parkourlrc/pcb-tgiacomellibr--sjc-6abed6a295/firmware/sjc_fw.pdf

24/08/2025

sjc_fw Project
Configuration Report

## 1. Description

### 1.1. Project

Project Name | sjc_fw
Board Name | custom
Generated with: | STM32CubeMX 6.15.0
Date | 08/24/2025

### 1.2. MCU

MCU Series | STM32F4
MCU Line | STM32F446
MCU name | STM32F446RETx
MCU Package | LQFP64
MCU Pin number | 64

### 1.3. Core(s) information

Core(s) | Arm Cortex-M4

## 2. Pinout Configuration

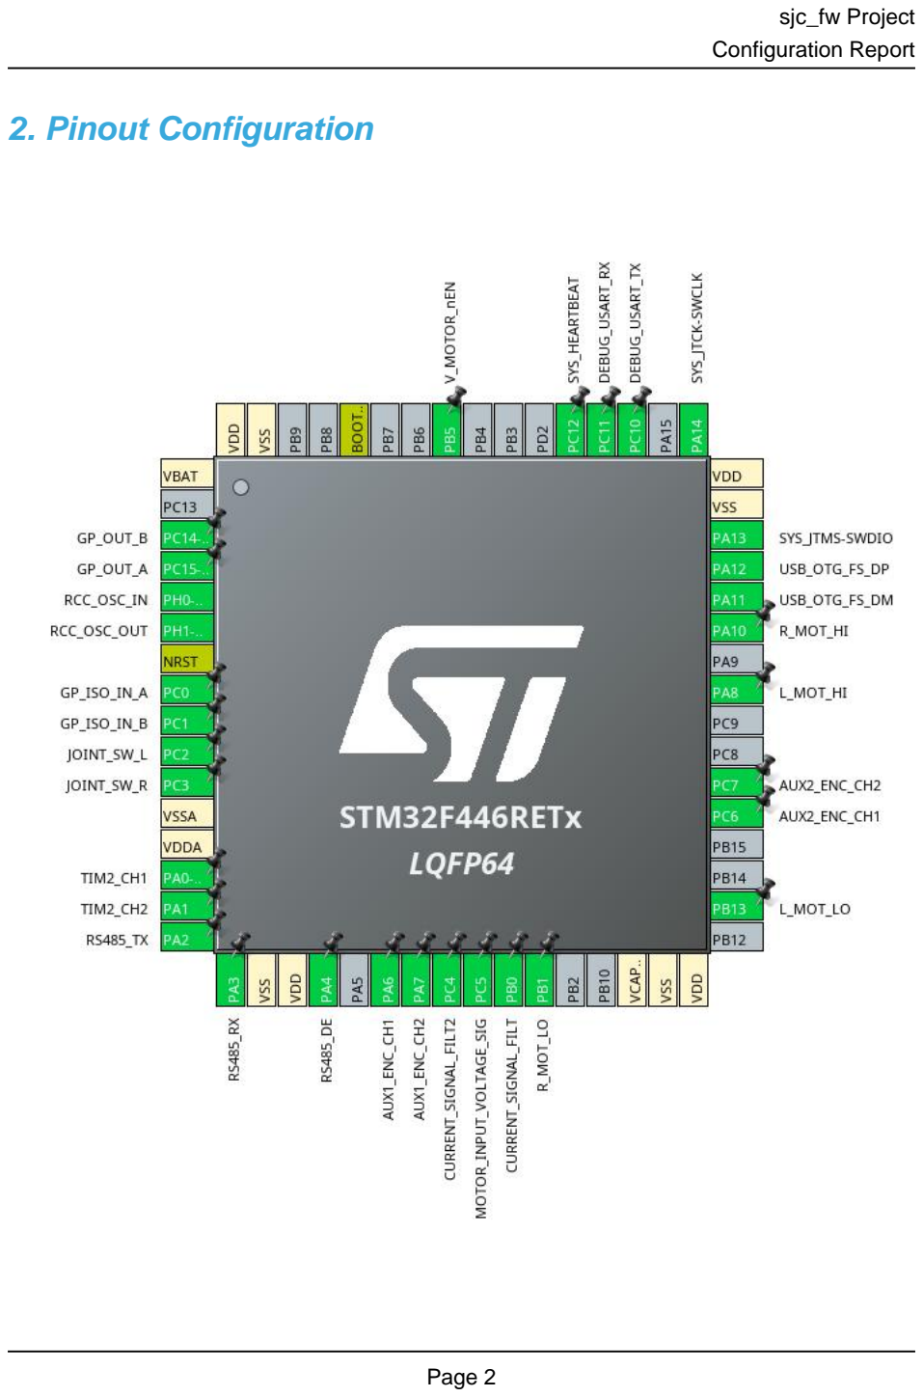
[picture p2: page 3]

## 3. Pins Configuration

Pin Number LQFP64 | Pin Name (function after reset) | Pin Type | Alternate Function(s) | Label
1 | VBAT | Power
3 | PC14-OSC32_IN * | I/O | GPIO_Output | GP_OUT_B
4 | PC15-OSC32_OUT * | I/O | GPIO_Output | GP_OUT_A
5 | PH0-OSC_IN | I/O | RCC_OSC_IN
6 | PH1-OSC_OUT | I/O | RCC_OSC_OUT
7 | NRST | Reset
8 | PC0 * | I/O | GPIO_Input | GP_ISO_IN_A
9 | PC1 * | I/O | GPIO_Input | GP_ISO_IN_B
10 | PC2 * | I/O | GPIO_Input | JOINT_SW_L
11 | PC3 * | I/O | GPIO_Input | JOINT_SW_R
12 | VSSA | Power
13 | VDDA | Power
14 | PA0-WKUP | I/O | TIM2_CH1
15 | PA1 | I/O | TIM2_CH2
16 | PA2 | I/O | USART2_TX | RS485_TX
17 | PA3 | I/O | USART2_RX | RS485_RX
18 | VSS | Power
19 | VDD | Power
20 | PA4 * | I/O | GPIO_Output | RS485_DE
22 | PA6 | I/O | TIM3_CH1 | AUX1_ENC_CH1
23 | PA7 | I/O | TIM3_CH2 | AUX1_ENC_CH2
24 | PC4 | I/O | ADC1_IN14 | CURRENT_SIGNAL_FILT2
25 | PC5 | I/O | ADC1_IN15 | MOTOR_INPUT_VOLTAGE _SIG
26 | PB0 | I/O | ADC1_IN8, ADC2_IN8 | CURRENT_SIGNAL_FILT
27 | PB1 | I/O | TIM1_CH3N | R_MOT_LO
30 | VCAP_1 | Power
31 | VSS | Power
32 | VDD | Power
34 | PB13 | I/O | TIM1_CH1N | L_MOT_LO
37 | PC6 | I/O | TIM8_CH1 | AUX2_ENC_CH1
38 | PC7 | I/O | TIM8_CH2 | AUX2_ENC_CH2
41 | PA8 | I/O | TIM1_CH1 | L_MOT_HI
43 | PA10 | I/O | TIM1_CH3 | R_MOT_HI
44 | PA11 | I/O | USB_OTG_FS_DM
45 | PA12 | I/O | USB_OTG_FS_DP

Pin Number LQFP64 | Pin Name (function after reset) | Pin Type | Alternate Function(s) | Label
46 | PA13 | I/O | SYS_JTMS-SWDIO
47 | VSS | Power
48 | VDD | Power
49 | PA14 | I/O | SYS_JTCK-SWCLK
51 | PC10 | I/O | USART3_TX | DEBUG_USART_TX
52 | PC11 | I/O | USART3_RX | DEBUG_USART_RX
53 | PC12 * | I/O | GPIO_Output | SYS_HEARTBEAT
57 | PB5 * | I/O | GPIO_Output | V_MOTOR_nEN
60 | BOOT0 | Boot
63 | VSS | Power
64 | VDD | Power

* The pin is affected with an I/O function

## 4. Clock Tree Configuration

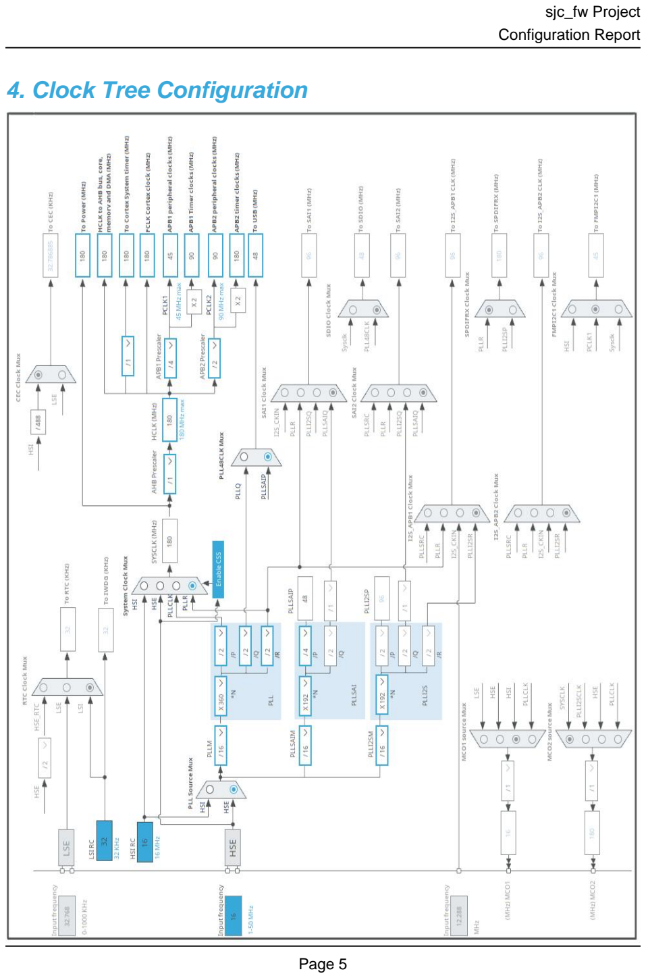
[picture p3: page 6]

## 1. Power Consumption Calculator report

### 1.1. Microcontroller Selection

Series | STM32F4
Line | STM32F446
MCU | STM32F446RETx
Datasheet | DS10693_Rev6

### 1.2. Parameter Selection

Temperature | 25
Vdd | 3.3

### 1.3. Battery Selection

Battery | Li-SOCL2(A3400)
Capacity | 3400.0 mAh
Self Discharge | 0.08 %/month
Nominal Voltage | 3.6 V
Max Cont Current | 100.0 mA
Max Pulse Current | 200.0 mA
Cells in series | 1
Cells in parallel | 1

### 1.4. Sequence

Step | Step1 | Step2
Mode | RUN | STOP_UDM (Under Drive)
Vdd | 3.3 | 3.3
Voltage Source | Battery | Battery
Range | Scale1-High | No Scale
Fetch Type | RAM/FLASH/REGON/ART/P REFETCH | n/a
CPU Frequency | 180 MHz | 0 Hz
Clock Configuration | HSE PLL | Regulator_LP Flash-PwrDwn
Clock Source Frequency | 4 MHz | 0 Hz
Peripherals
Additional Cons. | 0 mA | 0 mA
Average Current | 46 mA | 55 µA
Duration | 0.1 ms | 0.9 ms
DMIPS | 225.0 | 0.0
Ta Max | 98.02 | 104.99
Category | In DS Table | In DS Table

### 1.5. Results

Sequence Time | 1 ms | Average Current | 4.65 mA
Battery Life | 1 month | Average DMIPS | 225.0 DMIPS

### 1.6. Chart

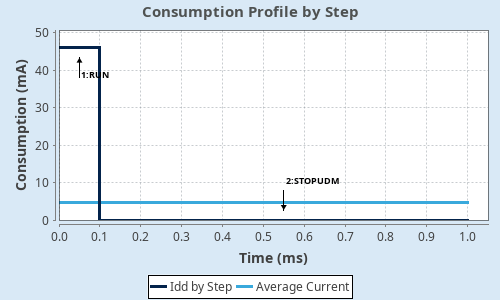
[picture p4: figure]

## 2. Software Project

### 2.1. Project Settings

Name | Value
Project Name | sjc_fw
Project Folder | /opt/Apps/Dropbox/Work/sjc/firmware
Toolchain / IDE | STM32CubeIDE
Firmware Package Name and Version | STM32Cube FW_F4 V1.28.2
Application Structure | Advanced
Generate Under Root | Yes
Do not generate the main() | No
Minimum Heap Size | 0x200
Minimum Stack Size | 0x400

### 2.2. Code Generation Settings

Name | Value
STM32Cube MCU packages and embedded software | Copy only the necessary library files
Generate peripheral initialization as a pair of '.c/.h' files | Yes
Backup previously generated files when re-generating | Yes
Keep User Code when re-generating | Yes
Delete previously generated files when not re-generated | Yes
Set all free pins as analog (to optimize the power consumption) | Yes
Enable Full Assert | Yes

### 2.3. Advanced Settings - Generated Function Calls

Rank | Function Name | Peripheral Instance Name
1 | SystemClock_Config | RCC
2 | MX_GPIO_Init | GPIO
3 | MX_DMA_Init | DMA
4 | MX_USART2_UART_Init | USART2
5 | MX_USART3_UART_Init | USART3
6 | MX_ADC1_Init | ADC1
7 | MX_TIM1_Init | TIM1
8 | MX_TIM2_Init | TIM2
9 | MX_TIM3_Init | TIM3
10 | MX_TIM8_Init | TIM8
11 | MX_USB_DEVICE_Init | USB_DEVICE

Rank | Function Name | Peripheral Instance Name
12 | MX_TIM11_Init | TIM11
13 | MX_TIM4_Init | TIM4
14 | MX_ADC2_Init | ADC2

## 3. Peripherals and Middlewares Configuration

### 3.1. ADC1

mode: IN14
mode: IN15
mode: Temperature Sensor Channel mode: Vrefint Channel
3.1.1. Parameter Settings:

ADCs_Common_Settings:

Mode | Independent mode
ADC_Settings:
Clock Prescaler | PCLK2 divided by 4
Resolution | 12 bits (15 ADC Clock cycles)
Data Alignment | Right alignment
Scan Conversion Mode | Enabled
Continuous Conversion Mode | Disabled
Discontinuous Conversion Mode | Disabled
DMA Continuous Requests | Disabled
End Of Conversion Selection | EOC flag at the end of all conversions *
ADC_Regular_ConversionMode:
Number Of Conversion | 1
External Trigger Conversion Source | Regular Conversion launched by software
External Trigger Conversion Edge | None
Rank | 1
Channel | Channel Vrefint *
Sampling Time | 28 Cycles *
ADC_Injected_ConversionMode:
Number Of Conversions | 4 *
External Trigger Source | Timer 1 Trigger Out event *
External Trigger Edge | Trigger detection on the falling edge *
Injected Conversion Mode | None
Injected Rank | 1
Channel | Channel Vrefint *
Sampling Time | 28 Cycles *
Injected Offset | 0
Injected Rank | 2 *
Channel | Channel Vrefint *
Sampling Time | 28 Cycles *

Injected Offset | 0
Injected Rank | 3 *
Channel | Channel 15 *
Sampling Time | 28 Cycles *
Injected Offset | 0
Injected Rank | 4 *
Channel | Channel 15 *
Sampling Time | 28 Cycles *
Injected Offset | 0
WatchDog:
Enable Analog WatchDog Mode | false

### 3.2. ADC2

mode: IN8
3.2.1. Parameter Settings:

ADCs_Common_Settings:

Mode | Independent mode
ADC_Settings:
Clock Prescaler | PCLK2 divided by 4
Resolution | 12 bits (15 ADC Clock cycles)
Data Alignment | Right alignment
Scan Conversion Mode | Enabled
Continuous Conversion Mode | Disabled
Discontinuous Conversion Mode | Disabled
DMA Continuous Requests | Disabled
End Of Conversion Selection | EOC flag at the end of all conversions *
ADC_Regular_ConversionMode:
Number Of Conversion | 1
External Trigger Conversion Source | Regular Conversion launched by software
External Trigger Conversion Edge | None
Rank | 1
Channel | Channel 8
Sampling Time | 3 Cycles
ADC_Injected_ConversionMode:
Number Of Conversions | 4 *
External Trigger Source | Timer 1 Trigger Out event *
External Trigger Edge | Trigger detection on the rising edge

Injected Conversion Mode | None
Injected Rank | 1
Channel | Channel 8
Sampling Time | 56 Cycles *
Injected Offset | 0
Injected Rank | 2 *
Channel | Channel 8
Sampling Time | 56 Cycles *
Injected Offset | 0
Injected Rank | 3 *
Channel | Channel 8
Sampling Time | 56 Cycles *
Injected Offset | 0
Injected Rank | 4 *
Channel | Channel 8
Sampling Time | 56 Cycles *
Injected Offset | 0
WatchDog:
Enable Analog WatchDog Mode | false

### 3.3. RCC

High Speed Clock (HSE): BYPASS Clock Source
3.3.1. Parameter Settings:

System Parameters:

VDD voltage (V) | 3.3
Instruction Cache | Enabled
Prefetch Buffer | Enabled
Data Cache | Enabled
Flash Latency(WS) | 5 WS (6 CPU cycle)
RCC Parameters:
HSI Calibration Value | 16
TIM Prescaler Selection | Disabled
HSE Startup Timout Value (ms) | 100
LSE Startup Timout Value (ms) | 5000
Power Parameters:
Power Regulator Voltage Scale | Power Regulator Voltage Scale 1
Power Over Drive | Enabled

### 3.4. SYS

Debug: Serial Wire
Timebase Source: TIM5

### 3.5. TIM1

Clock Source : Internal Clock Channel1: PWM Generation CH1 CH1N Channel3: PWM Generation CH3 CH3N
3.5.1. Parameter Settings:

Counter Settings:

Prescaler (PSC - 16 bits value) | 8 *
Counter Mode | Up
Counter Period (AutoReload Register - 16 bits value ) | 999 *
Internal Clock Division (CKD) | No Division
Repetition Counter (RCR - 8 bits value) | 0
auto-reload preload | Disable
Trigger Output (TRGO) Parameters:
Master/Slave Mode (MSM bit) | Disable (Trigger input effect not delayed)
Trigger Event Selection | Update Event *
Break And Dead Time management - BRK Configuration:
BRK State | Disable
BRK Polarity | High
Break And Dead Time management - Output Configuration:
Automatic Output State | Disable
Off State Selection for Run Mode (OSSR) | Disable
Off State Selection for Idle Mode (OSSI) | Disable
Lock Configuration | Off
Dead Time | 9 *
PWM Generation Channel 1 and 1N:
Mode | PWM mode 1
Pulse (16 bits value) | 700 *
Output compare preload | Enable
Fast Mode | Disable
CH Polarity | High
CHN Polarity | High
CH Idle State | Reset

CHN Idle State | Reset
PWM Generation Channel 3 and 3N:
Mode | PWM mode 2 *
Pulse (16 bits value) | 300 *
Output compare preload | Enable
Fast Mode | Disable
CH Polarity | High
CHN Polarity | High
CH Idle State | Reset
CHN Idle State | Reset

### 3.6. TIM2

Combined Channels: Encoder Mode
3.6.1. Parameter Settings:

Counter Settings:

Prescaler (PSC - 16 bits value) | 0
Counter Mode | Up
Counter Period (AutoReload Register - 32 bits value ) | 4294967295
Internal Clock Division (CKD) | No Division
auto-reload preload | Disable
Trigger Output (TRGO) Parameters:
Master/Slave Mode (MSM bit) | Disable (Trigger input effect not delayed)
Trigger Event Selection | Reset (UG bit from TIMx_EGR)
Encoder:
Encoder Mode | Encoder Mode TI1 and TI2 *

____ Parameters for Channel 1 ____
Polarity | Rising Edge
IC Selection | Direct
Prescaler Division Ratio | No division
Input Filter | 15 *

____ Parameters for Channel 2 ____
Polarity | Rising Edge
IC Selection | Direct
Prescaler Division Ratio | No division
Input Filter | 15 *

### 3.7. TIM3

Combined Channels: Encoder Mode
3.7.1. Parameter Settings:

Counter Settings:

Prescaler (PSC - 16 bits value) | 0
Counter Mode | Up
Counter Period (AutoReload Register - 16 bits value ) | 65535
Internal Clock Division (CKD) | No Division
auto-reload preload | Disable
Trigger Output (TRGO) Parameters:
Master/Slave Mode (MSM bit) | Disable (Trigger input effect not delayed)
Trigger Event Selection | Reset (UG bit from TIMx_EGR)
Encoder:
Encoder Mode | Encoder Mode TI1 and TI2 *

____ Parameters for Channel 1 ____
Polarity | Rising Edge
IC Selection | Direct
Prescaler Division Ratio | No division
Input Filter | 15 *

____ Parameters for Channel 2 ____
Polarity | Rising Edge
IC Selection | Direct
Prescaler Division Ratio | No division
Input Filter | 15 *

### 3.8. TIM4

Slave Mode: Trigger Mode
Trigger Source: ITR0
mode: Clock Source
3.8.1. Parameter Settings:

Counter Settings:

Prescaler (PSC - 16 bits value) | 89 *
Counter Mode | Up
Counter Period (AutoReload Register - 16 bits value ) | 9999 *
Internal Clock Division (CKD) | No Division

auto-reload preload | Enable *
Slave Mode Controller | Trigger Mode
Trigger Output (TRGO) Parameters:
Master/Slave Mode (MSM bit) | Disable (Trigger input effect not delayed)
Trigger Event Selection | Reset (UG bit from TIMx_EGR)

### 3.9. TIM8

Combined Channels: Encoder Mode
3.9.1. Parameter Settings:

Counter Settings:

Prescaler (PSC - 16 bits value) | 0
Counter Mode | Up
Counter Period (AutoReload Register - 16 bits value ) | 65535
Internal Clock Division (CKD) | No Division
Repetition Counter (RCR - 8 bits value) | 0
auto-reload preload | Disable
Trigger Output (TRGO) Parameters:
Master/Slave Mode (MSM bit) | Disable (Trigger input effect not delayed)
Trigger Event Selection | Reset (UG bit from TIMx_EGR)
Encoder:
Encoder Mode | Encoder Mode TI1 and TI2 *

____ Parameters for Channel 1 ____
Polarity | Rising Edge
IC Selection | Direct
Prescaler Division Ratio | No division
Input Filter | 15 *

____ Parameters for Channel 2 ____
Polarity | Rising Edge
IC Selection | Direct
Prescaler Division Ratio | No division
Input Filter | 15 *

### 3.10. TIM11

mode: Activated
3.10.1. Parameter Settings:

Counter Settings:

Prescaler (PSC - 16 bits value) | 4499 *
Counter Mode | Up
Counter Period (AutoReload Register - 16 bits value ) | 35 *
Internal Clock Division (CKD) | No Division
auto-reload preload | Disable

### 3.11. USART2

Mode: Asynchronous
3.11.1. Parameter Settings:

Basic Parameters:

Baud Rate | 921600 *
Word Length | 8 Bits (including Parity)
Parity | None
Stop Bits | 1
Advanced Parameters:
Data Direction | Receive and Transmit
Over Sampling | 16 Samples

### 3.12. USART3

Mode: Asynchronous
3.12.1. Parameter Settings:

Basic Parameters:

Baud Rate | 4000000 *
Word Length | 8 Bits (including Parity)
Parity | None
Stop Bits | 1
Advanced Parameters:
Data Direction | Transmit Only *
Over Sampling | 8 Samples *

### 3.13. USB_OTG_FS

Mode: Device_Only
3.13.1. Parameter Settings:
Speed | Device Full Speed 12MBit/s
Low power | Disabled
Link Power Management | Disabled
VBUS sensing | Disabled
Signal start of frame | Disabled

### 3.14. FREERTOS

Interface: CMSIS_V2
3.14.1. Config parameters:

API:

FreeRTOS API | CMSIS v2
Versions:
FreeRTOS version | 10.3.1
CMSIS-RTOS version | 2.00
MPU/FPU:
ENABLE_MPU | Disabled
ENABLE_FPU | Enabled *
Kernel settings:
USE_PREEMPTION | Enabled
CPU_CLOCK_HZ | SystemCoreClock
TICK_RATE_HZ | 1000
MAX_PRIORITIES | 56
MINIMAL_STACK_SIZE | 128
MAX_TASK_NAME_LEN | 16
USE_16_BIT_TICKS | Disabled
IDLE_SHOULD_YIELD | Enabled
USE_MUTEXES | Enabled
USE_RECURSIVE_MUTEXES | Enabled
USE_COUNTING_SEMAPHORES | Enabled
QUEUE_REGISTRY_SIZE | 8
USE_APPLICATION_TASK_TAG | Disabled
ENABLE_BACKWARD_COMPATIBILITY | Enabled
USE_PORT_OPTIMISED_TASK_SELECTION | Disabled
USE_TICKLESS_IDLE | Disabled

USE_TASK_NOTIFICATIONS | Enabled
RECORD_STACK_HIGH_ADDRESS | Enabled *
Memory management settings:
Memory Allocation | Dynamic / Static
TOTAL_HEAP_SIZE | 2048 *
Memory Management scheme | heap_4
Hook function related definitions:
USE_IDLE_HOOK | Disabled
USE_TICK_HOOK | Disabled
USE_MALLOC_FAILED_HOOK | Disabled
USE_DAEMON_TASK_STARTUP_HOOK | Disabled
CHECK_FOR_STACK_OVERFLOW | Option2 *
Run time and task stats gathering related definitions:
GENERATE_RUN_TIME_STATS | Enabled *
USE_TRACE_FACILITY | Enabled
USE_STATS_FORMATTING_FUNCTIONS | Enabled *
Co-routine related definitions:
USE_CO_ROUTINES | Disabled
MAX_CO_ROUTINE_PRIORITIES | 2
Software timer definitions:
USE_TIMERS | Enabled
TIMER_TASK_PRIORITY | 2
TIMER_QUEUE_LENGTH | 10
TIMER_TASK_STACK_DEPTH | 256
Interrupt nesting behaviour configuration:
LIBRARY_LOWEST_INTERRUPT_PRIORITY | 15
LIBRARY_MAX_SYSCALL_INTERRUPT_PRIORITY | 5
Added with 10.2.1 support:
MESSAGE_BUFFER_LENGTH_TYPE | size_t
USE_POSIX_ERRNO | Disabled
CMSIS-RTOS V2 flags:
USE_OS2_THREAD_SUSPEND_RESUME | Enabled
USE_OS2_THREAD_ENUMERATE | Enabled
USE_OS2_EVENTFLAGS_FROM_ISR | Enabled
USE_OS2_THREAD_FLAGS | Enabled
USE_OS2_TIMER | Enabled
USE_OS2_MUTEX | Enabled
3.14.2. Include parameters:

Include definitions:

vTaskPrioritySet | Enabled
uxTaskPriorityGet | Enabled
vTaskDelete | Enabled
vTaskCleanUpResources | Enabled *
vTaskSuspend | Enabled
vTaskDelayUntil | Enabled
vTaskDelay | Enabled
xTaskGetSchedulerState | Enabled
xTaskResumeFromISR | Enabled
xQueueGetMutexHolder | Enabled
xSemaphoreGetMutexHolder | Disabled
pcTaskGetTaskName | Enabled *
uxTaskGetStackHighWaterMark | Enabled
xTaskGetCurrentTaskHandle | Enabled
eTaskGetState | Enabled
xEventGroupSetBitFromISR | Enabled *
xTimerPendFunctionCall | Enabled
xTaskAbortDelay | Disabled
xTaskGetHandle | Enabled *
uxTaskGetStackHighWaterMark2 | Enabled *
3.14.3. Advanced settings:

Newlib settings (see parameter description first):

USE_NEWLIB_REENTRANT | Enabled *
Project settings (see parameter description first):
Use FW pack heap file | Enabled

### 3.15. USB_DEVICE

Class For FS IP: Communication Device Class (Virtual Port Com)
3.15.1. Parameter Settings:

Basic Parameters:

USBD_MAX_NUM_INTERFACES (Maximum number of supported interfaces) | 1
USBD_MAX_NUM_CONFIGURATION (Maximum number of supported configuration) | 1
USBD_MAX_STR_DESC_SIZ (Maximum size for the string descriptors) | 512

USBD_SELF_POWERED (Enabled self power) | Enabled
USBD_DEBUG_LEVEL (USBD Debug Level) | 0: No debug message
USBD_LPM_ENABLED (Link Power Management) | 1: Link Power Management supported
Class Parameters:
USB CDC Rx Buffer Size | 2048
USB CDC Tx Buffer Size | 2048
3.15.2. Device Descriptor:

Device Descriptor:

VID (Vendor IDentifier) | 1155
LANGID_STRING (Language Identifier) | English(United States)
MANUFACTURER_STRING (Manufacturer Identifier) | STMicroelectronics
Device Descriptor FS:
PID (Product IDentifier) | 22336
PRODUCT_STRING (Product Identifier) | STM32 Virtual ComPort
CONFIGURATION_STRING (Configuration Identifier) | CDC Config
INTERFACE_STRING (Interface Identifier) | CDC Interface

* User modified value

## 4. System Configuration

### 4.1. GPIO configuration

IP | Pin | Signal | GPIO mode | GPIO pull/up pull down | Max Speed | User Label
ADC1 | PC4 | ADC1_IN14 | Analog mode | No pull-up and no pull-down | n/a | CURRENT_SIGNAL_FILT 2
| PC5 | ADC1_IN15 | Analog mode | No pull-up and no pull-down | n/a | MOTOR_INPUT_VOLTAG E_SIG
| PB0 | ADC1_IN8 | Analog mode | No pull-up and no pull-down | n/a | CURRENT_SIGNAL_FILT
ADC2 | PB0 | ADC2_IN8 | Analog mode | No pull-up and no pull-down | n/a | CURRENT_SIGNAL_FILT
RCC | PH0-OSC_IN | RCC_OSC_IN | n/a | n/a | n/a
| PH1-OSC_OUT | RCC_OSC_OUT | n/a | n/a | n/a
SYS | PA13 | SYS_JTMS-SWDIO | n/a | n/a | n/a
| PA14 | SYS_JTCK-SWCLK | n/a | n/a | n/a
TIM1 | PB1 | TIM1_CH3N | Alternate Function Push Pull | No pull-up and no pull-down | Very High * | R_MOT_LO
| PB13 | TIM1_CH1N | Alternate Function Push Pull | No pull-up and no pull-down | Very High * | L_MOT_LO
| PA8 | TIM1_CH1 | Alternate Function Push Pull | No pull-up and no pull-down | Very High * | L_MOT_HI
| PA10 | TIM1_CH3 | Alternate Function Push Pull | No pull-up and no pull-down | Very High * | R_MOT_HI
TIM2 | PA0-WKUP | TIM2_CH1 | Alternate Function Push Pull | No pull-up and no pull-down | Low
| PA1 | TIM2_CH2 | Alternate Function Push Pull | No pull-up and no pull-down | Low
TIM3 | PA6 | TIM3_CH1 | Alternate Function Push Pull | No pull-up and no pull-down | Low | AUX1_ENC_CH1
| PA7 | TIM3_CH2 | Alternate Function Push Pull | No pull-up and no pull-down | Low | AUX1_ENC_CH2
TIM8 | PC6 | TIM8_CH1 | Alternate Function Push Pull | No pull-up and no pull-down | Low | AUX2_ENC_CH1
| PC7 | TIM8_CH2 | Alternate Function Push Pull | No pull-up and no pull-down | Low | AUX2_ENC_CH2
USART2 | PA2 | USART2_TX | Alternate Function Push Pull | No pull-up and no pull-down | Very High * | RS485_TX
| PA3 | USART2_RX | Alternate Function Push Pull | No pull-up and no pull-down | Very High * | RS485_RX
USART3 | PC10 | USART3_TX | Alternate Function Push Pull | No pull-up and no pull-down | Very High * | DEBUG_USART_TX
| PC11 | USART3_RX | Alternate Function Push Pull | No pull-up and no pull-down | Very High * | DEBUG_USART_RX

IP | Pin | Signal | GPIO mode | GPIO pull/up pull down | Max Speed | User Label
USB_OTG_ FS | PA11 | USB_OTG_FS_ DM | Alternate Function Push Pull | No pull-up and no pull-down | Very High *
| PA12 | USB_OTG_FS_ DP | Alternate Function Push Pull | No pull-up and no pull-down | Very High *
GPIO | PC14-OSC32_IN | GPIO_Output | Output Push Pull | No pull-up and no pull-down | Low | GP_OUT_B
| PC15-OSC32_OU T | GPIO_Output | Output Push Pull | No pull-up and no pull-down | Low | GP_OUT_A
| PC0 | GPIO_Input | Input mode | No pull-up and no pull-down | n/a | GP_ISO_IN_A
| PC1 | GPIO_Input | Input mode | No pull-up and no pull-down | n/a | GP_ISO_IN_B
| PC2 | GPIO_Input | Input mode | No pull-up and no pull-down | n/a | JOINT_SW_L
| PC3 | GPIO_Input | Input mode | No pull-up and no pull-down | n/a | JOINT_SW_R
| PA4 | GPIO_Output | Output Push Pull | No pull-up and no pull-down | Very High * | RS485_DE
| PC12 | GPIO_Output | Output Push Pull | No pull-up and no pull-down | Very High * | SYS_HEARTBEAT
| PB5 | GPIO_Output | Output Push Pull | No pull-up and no pull-down | Very High * | V_MOTOR_nEN

### 4.2. DMA configuration

DMA request | Stream | Direction | Priority
USART2_TX | DMA1_Stream6 | Memory To Peripheral | Medium *
USART3_TX | DMA1_Stream3 | Memory To Peripheral | Medium *

USART2_TX: DMA1_Stream6 DMA request Settings:

Mode: | Normal
Use fifo: | Disable
Peripheral Increment: | Disable
Memory Increment: | Enable *
Peripheral Data Width: | Byte
Memory Data Width: | Byte

USART3_TX: DMA1_Stream3 DMA request Settings:

Mode: | Normal
Use fifo: | Disable
Peripheral Increment: | Disable
Memory Increment: | Enable *
Peripheral Data Width: | Byte
Memory Data Width: | Byte

### 4.3. NVIC configuration

4.3.1. NVIC
Interrupt Table | Enable | Preenmption Priority | SubPriority
Non maskable interrupt | true | 0 | 0
Hard fault interrupt | true | 0 | 0
Memory management fault | true | 0 | 0
Pre-fetch fault, memory access fault | true | 0 | 0
Undefined instruction or illegal state | true | 0 | 0
System service call via SWI instruction | true | 0 | 0
Debug monitor | true | 0 | 0
Pendable request for system service | true | 15 | 0
System tick timer | true | 15 | 0
DMA1 stream3 global interrupt | true | 5 | 0
DMA1 stream6 global interrupt | true | 5 | 0
ADC1, ADC2 and ADC3 interrupts | true | 5 | 0
TIM1 trigger and commutation interrupts and TIM11 global interrupt | true | 5 | 0
USART2 global interrupt | true | 5 | 0
TIM8 break interrupt and TIM12 global interrupt | true | 5 | 0
TIM5 global interrupt | true | 15 | 0
USB On The Go FS global interrupt | true | 5 | 0
PVD interrupt through EXTI line 16 | | unused
Flash global interrupt | | unused
RCC global interrupt | | unused
TIM1 break interrupt and TIM9 global interrupt | | unused
TIM1 update interrupt and TIM10 global interrupt | | unused
TIM1 capture compare interrupt | | unused
TIM2 global interrupt | | unused
TIM3 global interrupt | | unused
TIM4 global interrupt | | unused
USART3 global interrupt | | unused
TIM8 update interrupt and TIM13 global interrupt | | unused
TIM8 trigger and commutation interrupts and TIM14 global interrupt | | unused
TIM8 capture compare interrupt | | unused
FPU global interrupt | | unused
4.3.2. NVIC Code generation
Enabled interrupt Table | Select for init | Generate IRQ | Call HAL handler

Enabled interrupt Table Select for init sequence ordering

Generate IRQ
handler

Call HAL handler

Non maskable interrupt | false | true | false
Hard fault interrupt | false | true | false
Memory management fault | false | true | false
Pre-fetch fault, memory access fault | false | true | false
Undefined instruction or illegal state | false | true | false
System service call via SWI instruction | false | false | false
Debug monitor | false | true | false
Pendable request for system service | false | false | false
System tick timer | false | false | true
DMA1 stream3 global interrupt | false | false | true
DMA1 stream6 global interrupt | false | false | true
ADC1, ADC2 and ADC3 interrupts | false | false | true
TIM1 trigger and commutation interrupts and TIM11 global interrupt | false | false | true
USART2 global interrupt | false | false | true
TIM8 break interrupt and TIM12 global interrupt | false | false | true
TIM5 global interrupt | false | true | true
USB On The Go FS global interrupt | false | true | true

* User modified value

## 5. System Views

5.1. Category view
5.1.1. Current

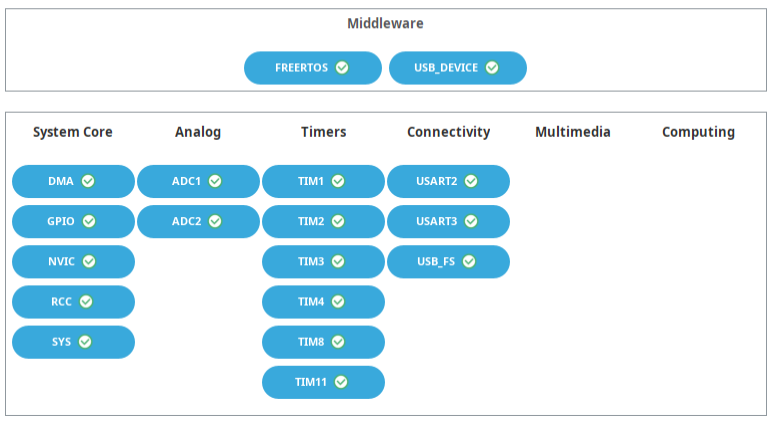
[picture p5: figure]

## 6. Docs & Resources

Type | Link
BSDL files | https://www.st.com/resource/en/bsdl_model/stm32f446_bsdl.zip
IBIS models | https://www.st.com/resource/en/ibis_model/stm32f446_ibis.zip
System View Description | https://www.st.com/resource/en/svd/stm32f4-svd.zip
Presentations | https://www.st.com/resource/en/product_presentation/stm32-stm8_embedded_software_solutions.pdf
Presentations | https://www.st.com/resource/en/product_presentation/stm32_eval-tools_portfolio.pdf
Presentations | https://www.st.com/resource/en/product_presentation/stm32_stm8_functi onal-safety-packages.pdf
Presentations | https://www.st.com/resource/en/product_presentation/stm32-stm8_software_development_tools.pdf
Presentations | https://www.st.com/resource/en/product_presentation/microcontrollers-stm32-family-overview.pdf
Brochures | https://www.st.com/resource/en/brochure/products-and-solutions-for-plcs-and-smart-i-os.pdf
Flyers | https://www.st.com/resource/en/flyer/flstm32nucleo.pdf
Flyers | https://www.st.com/resource/en/flyer/flstm32trust.pdf
Product Certifications | https://www.st.com/resource/en/certification_document/stm32_authentication_can.pdf
Security Bulletin | https://www.st.com/resource/en/technical_note/tn1489-security-bulletin-tn1489stpsirt-physical-attacks-on-stm32-and-stm32cube-firmware-stmicroelectronics.pdf
Application Notes | https://www.st.com/resource/en/application_note/an1709-emc-design-guide-for-stm8-stm32-and-legacy-mcus-stmicroelectronics.pdf
Application Notes | https://www.st.com/resource/en/application_note/an2606-stm32-microcontroller-system-memory-boot-mode-stmicroelectronics.pdf
Application Notes | https://www.st.com/resource/en/application_note/an2945-stm8s-and- stm32-mcus-a-consistent-832bit-product-line-for-painless-migration-

| stmicroelectronics.pdf
Application Notes | https://www.st.com/resource/en/application_note/an3070-managing-the-driver-enable-signal-for-rs485-and-iolink-communications-with-the-stm32s-usart-stmicroelectronics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
Application Notes | https://www.st.com/resource/en/application_note/an3126-audio-and-waveform-generation-using-the-dac-in-stm32-products-stmicroelectronics.pdf
Application Notes | https://www.st.com/resource/en/application_note/an3155-usart-protocol-used-in-the-stm32-bootloader-stmicroelectronics.pdf
Application Notes | https://www.st.com/resource/en/application_note/an3156-usb-dfu-protocol-used-in-the-stm32-bootloader-stmicroelectronics.pdf
Application Notes | https://www.st.com/resource/en/application_note/an3364-migration-and-compatibility-guidelines-for-stm32-microcontroller-applications-stmicroelectronics.pdf
Application Notes | https://www.st.com/resource/en/application_note/an3997-audio-playback-and-recording-using-the-stm32f4discovery-stmicroelectronics.pdf
Application Notes | https://www.st.com/resource/en/application_note/an3998-pdm-audio-software-decoding-on-stm32-microcontrollers-stmicroelectronics.pdf
Application Notes | https://www.st.com/resource/en/application_note/an4031-using-the-stm32f2-stm32f4-and-stm32f7-series-dma-controller-stmicroelectronics.pdf
Application Notes | https://www.st.com/resource/en/application_note/an4221-i2c-protocol-used-in-the-stm32-bootloader-stmicroelectronics.pdf
Application Notes | https://www.st.com/resource/en/application_note/an4286-spi-protocol-used-in-the-stm32-bootloader-stmicroelectronics.pdf
Application Notes | https://www.st.com/resource/en/application_note/an4488-getting-started-with-stm32f4xxxx-mcu-hardware-development-stmicroelectronics.pdf
Application Notes | https://www.st.com/resource/en/application_note/an4640-peripherals-interconnections-on-stm32f4057xx-stm32f4157xx-stm32f42xxx-stm32f43xxx-stm32f446xx-and-stm32f469479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
Application Notes | https://www.st.com/resource/en/application_note/an4655-virtually-increasing-the-number-of-serial-communication-peripherals-in-stm32-applications-stmicroelectronics.p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

Application Notes | https://www.st.com/resource/en/application_note/an4658-migration-of-applications-from-stm32f429439-lines-to-stm32f446-line-stmicroelectronics.pdf
Application Notes | https://www.st.com/resource/en/application_note/an4739-stm32cube-firmware-examples-for-stm32f4-series-stmicroelectronics.pdf
Application Notes | https://www.st.com/resource/en/application_note/an4750-handling-of-soft-errors-in-stm32-applications-stmicroelectronics.pdf
Application Notes | https://www.st.com/resource/en/application_note/an4776-generalpurpose-timer-cookbook-for-stm32-microcontrollers-stmicroelectronics.pdf
Application Notes | https://www.st.com/resource/en/application_note/an4803-highspeed-si-simulations-using-ibis-and-boardlevel-simulations-using-hyperlynx-si-on-stm32-mcus-and-mpus-stmic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
Application Notes | https://www.st.com/resource/en/application_note/an4850-stm32-mcus-spreadspectrum-clock-generation-principles-properties-and-implementation-stmicroelectronics.pdf
Application Notes | https://www.st.com/resource/en/application_note/an4989-stm32-microcontroller-debug-toolbox-stmicroelectronics.pdf
Application Notes | https://www.st.com/resource/en/application_note/an4995-using-an-electromyogram-technique-to-detect-muscle-activity-stmicroelectronics.pdf
Application Notes | https://www.st.com/resource/en/application_note/an5027-interfacing-pdm-digital-microphones-using-stm32-mcus-and-mpus-stmicroelectronics.pdf
Application Notes | https://www.st.com/resource/en/application_note/an5073-receiving-spdif-audio-stream-with-the-stm32f4f7h7-series-stmicroelectronics.pdf
Application Notes | https://www.st.com/resource/en/application_note/an4760-quadspi-interface-on-stm32-microcontrollers-and-microprocessors--stmicroelectronics.pdf
Application Notes | https://www.st.com/resource/en/application_note/an4899-stm32-microcontroller-gpio-hardware-settings-and-lowpower-consumption-stmicroelectronics.pdf
Application Notes | https://www.st.com/resource/en/application_note/an5612-esd-protection-of-stm32-mcus-and-mpus-stmicroelectronics.pdf
Application Notes | https://www.st.com/resource/en/application_note/an4838-introduction-to-

| memory-protection-unit-management-on-stm32-mcus-stmicroelectronics.pdf
Application Notes | https://www.st.com/resource/en/application_note/an4879-introduction-to-usb-hardware-and-pcb-guidelines-using-stm32-mcus-stmicroelectronics.pdf
Application Notes | https://www.st.com/resource/en/application_note/an5225-introduction-to-usb-typec-power-delivery-for-stm32-mcus-and-mpus-stmicroelectronics.pdf
Application Notes | https://www.st.com/resource/en/application_note/an5537-how-to-use-adc-oversampling-techniques-to-improve-signaltonoise-ratio-on-stm32-mcus-stmicroelectronics.pdf
Application Notes | https://www.st.com/resource/en/application_note/an5036-guidelines-for-thermal-management-on-stm32-applications-stmicroelectronics.pdf
Application Notes | https://www.st.com/resource/en/application_note/an4230-introduction-to-random-number-generation-validation-using-the-nist-statistical-test-suite-for-stm32-mcus-and-m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
Application Notes | https://www.st.com/resource/en/application_note/an2867-guidelines-for-oscillator-design-on-stm8afals-and-stm32-mcusmpus-stmicroelectronics.pdf
Application Notes | https://www.st.com/resource/en/application_note/an4013-introduction-to-timers-for-stm32-mcus-stmicroelectronics.pdf
Application Notes | https://www.st.com/resource/en/application_note/an4277-how-to-use-pwm-shutdown-for-motor-control-and-digital-power-conversion-on-stm32-mcus-stmicroelectronics.pdf
Application Notes | https://www.st.com/resource/en/application_note/an4759-introduction-to-using-the-hardware-realtime-clock-rtc-and-the-tamper-management-unit-tamp-with-stm32-mcus-stmi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
Application Notes | https://www.st.com/resource/en/application_note/an4908-getting-started-with-usart-automatic-baud-rater-detection-for-stm32-mcus-stmicroelectronics.pdf
Application Notes | https://www.st.com/resource/en/application_note/an5156-introduction-to-security-for-stm32-mcus-stmicroelectronics.pdf
Application Notes | https://www.st.com/resource/en/application_note/an5543-guidelines-for- enhanced-spi-communication-on-stm32-mcus-and-mpus-

| stmicroelectronics.pdf
Application Notes | https://www.st.com/resource/en/application_note/an5992-migrating-from-stm32f446-to-stm32h523533-mcus-stmicroelectronics.pdf
Application Notes | https://www.st.com/resource/en/application_note/cd00211314-how-to-optimize-the-adc-accuracy-in-the-stm32-mcus-stmicroelectronics.pdf
Application Notes | https://www.st.com/resource/en/application_note/an2639-soldering-recommendations-and-package-information-for-leadfree-ecopack2-mcus-and-mpus-stmicroelectronics.pdf
Application Notes | https://www.st.com/resource/en/application_note/an5020-introduction-to-digital-camera-interface-dcmi-for-stm32-mcus-stmicroelectronics.pdf
Application Notes | https://www.st.com/resource/en/application_note/an3154-how-to-use-can-protocol-in-bootloader-on-stm32-mcus-stmicroelectronics.pdf
Application Notes | https://www.st.com/resource/en/application_note/an4566-how-to-extend-the-dac-performance-on-stm32-mcus-stmicroelectronics.pdf
Application Notes for related Tools & Software | https://www.st.com/resource/en/application_note/an2656-stm32f10xxx-lcd-glass-driver-firmware-stmicroelectronics.pdf
Application Notes for related Tools & Software | https://www.st.com/resource/en/application_note/an2790-tft-lcd-interfacing-with-the-highdensity-stm32f10xxx-fsmc-stmicroelectronics.pdf
Application Notes for related Tools & Software | https://www.st.com/resource/en/application_note/an3078-stm32-inapplication-programming-over-the-ic-bus-stmicroelectronics.pdf
Application Notes for related Tools & Software | https://www.st.com/resource/en/application_note/an3116-stm32s-adc-modes-and-their-applications-stmicroelectronics.pdf
Application Notes for related Tools & Software | https://www.st.com/resource/en/application_note/an3174-implementing-receivers-for-infrared-remote-control-protocols-using-stm32f10xxx-microcontrollers-stmicroelectro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
Application Notes for related Tools & Software | https://www.st.com/resource/en/application_note/an3241-qvga-tftlcd-direct-drive-using-the-stm32f10xx-fsmc-peripheral-stmicroelectronics.pdf
Application Notes | https://www.st.com/resource/en/application_note/an3307-guidelines-for-

for related Tools & Software | obtaining-iec-60335-class-b-certification-for-any-stm32-application-stmicroelectronics.pdf
Application Notes for related Tools & Software | https://www.st.com/resource/en/application_note/an3965-stm32f40xstm32f41x-inapplication-programming-using-the-usart-stmicroelectronics.pdf
Application Notes for related Tools & Software | https://www.st.com/resource/en/application_note/an3969-eeprom-emulation-in-stm32f40xstm32f41x-microcontrollers-stmicroelectronics.pdf
Application Notes for related Tools & Software | https://www.st.com/resource/en/application_note/an4044-floating-point-unit-demonstration-on-stm32-microcontrollers-stmicroelectronics.pdf
Application Notes for related Tools & Software | https://www.st.com/resource/en/application_note/an4323-getting-started-with-stemwin-library-stmicroelectronics.pdf
Application Notes for related Tools & Software | https://www.st.com/resource/en/application_note/an4365-using-stm32f4-mcu-power-modes-with-best-dynamic-efficiency-stmicroelectronics.pdf
Application Notes for related Tools & Software | https://www.st.com/resource/en/application_note/an4435-guidelines-for-obtaining-ulcsaiec-607301603351-class-b-certification-in-any-stm32-application-stmicroelectroni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
Application Notes for related Tools & Software | https://www.st.com/resource/en/application_note/an4457-implementing-an-emulated-uart-on-stm32f4-microcontrollers-stmicroelectronics.pdf
Application Notes for related Tools & Software | https://www.st.com/resource/en/application_note/an4499-stm32--nrf51822-bluetooth-low-energy-system-solution-stmicroelectronics.pdf
Application Notes for related Tools & Software | https://www.st.com/resource/en/application_note/an4657-stm32-inapplication-programming-iap-using-the-usart-stmicroelectronics.pdf
Application Notes for related Tools & Software | https://www.st.com/resource/en/application_note/an4666-parallel-synchronous-transmission-using-gpio-and-dma-stmicroelectronics.pdf

Application Notes
for related Tools

https://www.st.com/resource/en/application_note/an4678-full-duplex-spiemulation-for-stm32f4-microcontrollers-stmicroelectronics.pdf

& Software
Application Notes for related Tools & Software | https://www.st.com/resource/en/application_note/an4701-proprietary-code-readout-protection-on-microcontrollers-of-the-stm32f4-series-stmicroelectronics.pdf
Application Notes for related Tools & Software | https://www.st.com/resource/en/application_note/an4739-stm32cube-firmware-examples-for-stm32f4-series-stmicroelectronics.pdf
Application Notes for related Tools & Software | https://www.st.com/resource/en/application_note/an4758-proprietary-code-readout-protection-on-stm32l4-stm32l4-stm32g4-and-stm32wb-series-mcus-stmicroelectronics.pdf
Application Notes for related Tools & Software | https://www.st.com/resource/en/application_note/an4841-digital-signal-processing-for-stm32-microcontrollers-using-cmsis-stmicroelectronics.pdf
Application Notes for related Tools & Software | https://www.st.com/resource/en/application_note/an4852-programming-an-external-flash-memory-using-the-uart-bootloader-builtin-stm32-microcontrollers-stmicroelectroni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
Application Notes for related Tools & Software | https://www.st.com/resource/en/application_note/an4968-proprietary-code-read-out-protection-pcrop-on-stm32f72xxx-and-stm32f73xxx-microcontrollers-stmicroelectronics.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
Application Notes for related Tools & Software | https://www.st.com/resource/en/application_note/an5056-integration-guide-for-the-xcubesbsfu-stm32cube-expansion-package-stmicroelectronics.pdf
Application Notes for related Tools & Software | https://www.st.com/resource/en/application_note/an5360-getting-started-with-projects-based-on-the-stm32mp1-series-in-stm32cubeide-stmicroelectronics.pdf
Application Notes for related Tools & Software | https://www.st.com/resource/en/application_note/an5361-getting-started-with-projects-based-on-dualcore-stm32h7-microcontrollers-in-stm32cubeide-stmicroelectronics.pd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
Application Notes for related Tools & Software | https://www.st.com/resource/en/application_note/an5394-getting-started-with-projects-based-on-the-stm32l5-series-in-stm32cubeide-stmicroelectronics.pdf
Application Notes for related Tools & Software | https://www.st.com/resource/en/application_note/an5418-how-to-build-a-simple-usbpd-sink-application-with-stm32cubemx-stmicroelectronics.pdf

Application Notes for related Tools & Software | https://www.st.com/resource/en/application_note/an5426-migrating-graphics-middleware-projects-from-stm32cubemx-540-to-stm32cubemx-550-stmicroelectronics.pdf
Application Notes for related Tools & Software | https://www.st.com/resource/en/application_note/an5464-position-control-of-a-threephase-permanent-magnet-motor-using-xcubemcsdk-or-xcubemcsdkful-stmicroelectronics.p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
Application Notes for related Tools & Software | https://www.st.com/resource/en/application_note/an5564-getting-started-with-projects-based-on-dualcore-stm32wl-microcontrollers-in-stm32cubeide-stmicroelectronics.pd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
Application Notes for related Tools & Software | https://www.st.com/resource/en/application_note/an5698-adapting-the-xcubestl-functional-safety-package-for-stm32-iec-61508-compliant-to-other-safety-standards-stmicr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
Application Notes for related Tools & Software | https://www.st.com/resource/en/application_note/an5731-stm32cubemx-and-stm32cubeide-threadsafe-solution-stmicroelectronics.pdf
Application Notes for related Tools & Software | https://www.st.com/resource/en/application_note/an4502-stm32-smbuspmbus-expansion-package-for-stm32cube-stmicroelectronics.pdf
Application Notes for related Tools & Software | https://www.st.com/resource/en/application_note/an5952-how-to-use-cmake-in-stm32cubeide-stmicroelectronics.pdf
Application Notes for related Tools & Software | https://www.st.com/resource/en/application_note/an5054-how-to-perform-secure-programming-using-stm32cubeprogrammer-stmicroelectronics.pdf
Application Notes for related Tools & Software | https://www.st.com/resource/en/application_note/an6179-how-to-integrate-the-stl-firmware-into-a-time-critical-user-application-stmicroelectronics.pdf
Application Notes for related Tools & Software | https://www.st.com/resource/en/application_note/an6127-getting-started-with-stm32h7rx7sx-mcus-in-stm32cubeide-stmicroelectronics.pdf
Errata Sheets | https://www.st.com/resource/en/errata_sheet/es0298-stm32f446xcxe-device-errata-stmicroelectronics.pdf
Datasheet | https://www.st.com/resource/en/datasheet/dm00141306.pdf
Programming | https://www.st.com/resource/en/programming_manual/pm0214-stm32-

Manuals | cortexm4-mcus-and-mpus-programming-manual-stmicroelectronics.pdf
Reference Manuals | https://www.st.com/resource/en/reference_manual/rm0390-stm32f446xx-advanced-armbased-32bit-mcus-stmicroelectronics.pdf
Technical Notes & Articles | https://www.st.com/resource/en/technical_note/tn0516-overview-of-the-stm32f0xf100xxf103xx-and-stm32f2xxf30xf4xx-mcus-pmsm-singledual-foc-sdk-v40-stmicroelectronics.p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
Technical Notes & Articles | https://www.st.com/resource/en/technical_note/tn1163-description-of-wlcsp-for-microcontrollers-and-recommendations-for-its-use-stmicroelectronics.pdf
Technical Notes & Articles | https://www.st.com/resource/en/technical_note/tn1204-tape-and-reel-shipping-media-for-stm32-microcontrollers-in-bga-packages-stmicroelectronics.pdf
Technical Notes & Articles | https://www.st.com/resource/en/technical_note/tn1205-tape-and-reel-shipping-media-for-stm8-and-stm32-microcontrollers-in-fpn-packages-stmicroelectronics.pdf
Technical Notes & Articles | https://www.st.com/resource/en/technical_note/tn1206-tape-and-reel-shipping-media-for-stm8-and-stm32-microcontrollers-in-qfp-packages-stmicroelectronics.pdf
Technical Notes & Articles | https://www.st.com/resource/en/technical_note/tn1207-tape-and-reel-shipping-media-for-stm8-and-stm32-microcontrollers-in-so-packages-stmicroelectronics.pdf
Technical Notes & Articles | https://www.st.com/resource/en/technical_note/tn1208-tape-and-reel-shipping-media-for-stm8-and-stm32-microcontrollers-in-tssop-and-ssop-packages-stmicroelectronics.p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
Technical Notes & Articles | https://www.st.com/resource/en/technical_note/tn1433-reference-device-marking-schematics-for-stm32-microcontrollers-and-microprocessors-stmicroelectronics.pdf
User Manuals | https://www.st.com/resource/en/user_manual/um3461-stm32f4-series-ulcsaiec-607301603351-selftest-library-user-guide-stmicroelectronics.pdf
