parkourlrc/pcb-tgiacomellibr--sjc-6abed6a295/hardware_v2/outputs/doc/hardware_v2_botton.png

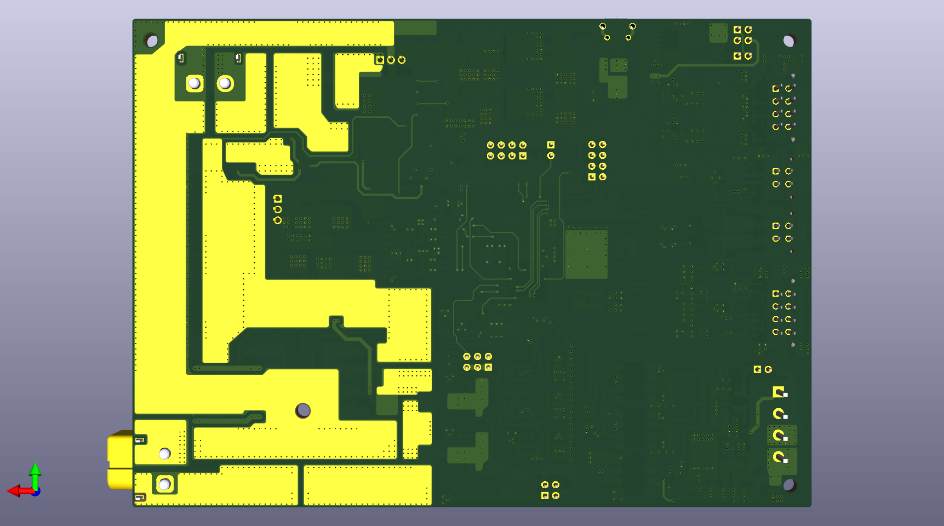
hardware_v2/outputs/doc/hardware_v2_botton.png
