parkourlrc/pcb-tgiacomellibr--sjc-6abed6a295/hardware/outputs/bom/bom_mouser.xlsx

Comment | Designator | Footprint | Quantity Per PCB | LCSC part number | MF | PN | Mouser #
Capacitor, 100nF, ±5%, X7R, 50V, SMD 0603 | C3 C8 C9 C20 C21 C23 C24 C25 C27 C28 C29 C36 C39 C43 C46 C54 C55 C56 C57 C58 C59 C60 C61 C62 C65 C66 C67 C68 C69 C70 C72 C73 C78 C80 C82 C84 C86 C88 C93 | C_0603_1608Metric | 39 | C91183 | YAGEO | CC0603JRX7R9BB104
Capacitor, 10nF, ±5%, NP0, 50V, SMD 0603 | C26 C30 C40 C47 C63 C64 C85 C90 C91 C92 | C_0603_1608Metric | 10 | C389113 | YAGEO | CC0603JRNPO9BN103
Capacitor, 10uF, ±10%, X5R, 50V, SMD 1206 | C2 C6 C11 C12 C13 C17 C18 C19 C31 C35 C42 C48 C75 C76 C79 | C_1206_3216Metric | 15 | C13585 | Samsung Electro-Mechanics | CL31A106KBHNNNE
Capacitor, 12nF, ±5%, X7R, 50V, SMD 0603 | C22 | C_0603_1608Metric | 1 | C302013 | Walsin Tech Corp | 0603B123J500CT
Capacitor, 1uF, ±10%, X7R, 50V, SMD 1206 | C14 C15 C32 C49 C50 C51 C71 C74 C77 C81 C83 C87 | C_1206_3216Metric | 12 | C1848 | Samsung Electro-Mechanics | CL31B105KBHNNNE
Capacitor, 22nF, ±5%, X7R, 50V, SMD 0603 | C34 C52 C53 | C_0603_1608Metric | 3 | C277528 | YAGEO | CC0603JRX7R9BB223
Capacitor, 22uF, ±10%, X5R, 25V, SMD 1206 | C4 C16 | C_1206_3216Metric | 2 | C105213 | Walsin Tech Corp | 1206X226K250CT
Capacitor, 39nF, ±5%, X7R, 50V, SMD 0603 | C37 C38 C41 C44 | C_0603_1608Metric | 4 | C519553 | YAGEO | CC0603JRX7R9BB393
Tantalum Capacitor, 4.7uF, ±10%, X5R, 50V, SMD 1206 | C89 | CP_EIA-3528-15_AVX-H_Pad1.50x2.35mm_HandSolder | 1 | C308921 | Kyocera AVX | TPSB475K020R0750
Electrolytic capacitor, 47uF, 20%, 63V, SMD D8xL10.5mm | C1 C10 | CP_Elec_8x10.5 | 2 | C116428 | ST(Semtech) | CS1J470M-CRF10
Electrolytic capacitor, 680uF, 20%, 63V, SMD D18xL16.5mm | C5 C7 | CP_Elec_18x17.5 | 2 | C249956 | Lelon | VZH681M1JTR-1816
Capacitor, 82nF, ±5%, X7R, 50V, SMD 0805 | C33 C45 | C_0805_2012Metric_Pad1.18x1.45mm_HandSolder | 2 | C520047 | YAGEO | CC0805JRX7R9BB823
Dual Series Schottky Barrier Diodes, 30V Reverse Voltage, 200mA Forward Current | D2 | SOT-23 | 1 | C19726 | Onsemi | BAT54SLT1G
Schottky diode, 60 V reverse voltage, 1 A average forward current, 600 mV forward voltage, SOD123W | D4 D5 D6 D7 D9 D10 | D_SOD-123F | 6 | C552945 | Nexperia | PMEG60T10ELRX
60V, 2A low leakage current Trench MEGA Schottky barrier rectifier, SOD-123W | D1 D3 D8 D11 | D_SOD-123F | 4 | C552947 | Nexperia | PMEG60T20ELRX
Ferrite Bead, 3A, 40mΩ DC Resistance, 220Ω@100MHz, SMD 0805 | FB1 FB2 FB3 FB4 FB5 FB6 FB7 FB8 FB9 FB10 FB11 FB12 FB13 FB14 | L_0805_2012Metric_Pad1.05x1.20mm_HandSolder | 14 | C76818 | TDK | MPZ2012S221AT000
USB Micro Type B connector | J8 | AMPHENOL_10118194-0001LF | 1 | C132563 | Amphenol ICC | 10118194-0001LF
Generic connector, double row, 02x04, top/bottom pin numbering scheme (row 1: 1...pins_per_row, row2: pins_per_row+1 ... num_pins), script generated (kicad-library-utils/schlib/autogen/connector/) | J4 J5 | Molex_Micro-Fit_3.0_43045-0812_2x04_P3.00mm_Vertical | 2
Generic connector, double row, 02x02, top/bottom pin numbering scheme (row 1: 1...pins_per_row, row2: pins_per_row+1 ... num_pins), script generated (kicad-library-utils/schlib/autogen/connector/) | J6 J7 | Molex_Micro-Fit_3.0_43045-0412_2x02_P3.00mm_Vertical | 2
Generic screw terminal, single row, 01x02, script generated (kicad-library-utils/schlib/autogen/connector/) | J3 | TerminalBlock_Phoenix_MKDS-3-2-5.08_1x02_P5.08mm_Horizontal | 1 | C8465 | Ningbo Kangnex Elec | WJ500V-5.08-2P
Generic connector, single row, 01x04, script generated (kicad-library-utils/schlib/autogen/connector/) | J9 | TerminalBlock_Phoenix_MKDS-3-4-5.08_1x04_P5.08mm_Horizontal | 1 | C2915641 | DIBO | DB128V-5.08-4P-GN-S
2 Pos. Pin Header, 2.54 mm Pitch | JP1 JP2 JP3 JP4 JP5 | PinHeader_1x02_P2.54mm_Vertical | 5 | C234182 | MOLEX | 22284020
Light emitting diode | LD1 LD2 LD3 LD4 LD5 LD6 LD7 | LED_0603_1608Metric_Pad1.05x0.95mm_HandSolder | 7 | C165982 | BrtLed (Bright LED Elec) | BL-HGE36G-AV-TRB
-0.13A Id, -50V Vds, P-Channel MOSFET, SOT-23 | Q7 | SOT-23 | 1 | C85202 | Diodes Incorporated | BSS84-7-F
280mA Id, 60V Vds, 20V Vgss, N-Channel MOSFET, SOT-23 | Q2 Q5 Q6 Q8 | SOT-23 | 4 | C74715 | onsemi | NDS7002A
50A Id, -30 V Drain-Source Voltage, 25 V Gate-Source Voltage, 5.2 mOhm Ron, PowerPAK-8 | Q1 Q3 | PowerPAK_SO-8_Single | 2 | C554002 | Vishay Intertech | SI7149ADP-T1-GE3
Resistor, 0 Ohms, ±5%, 1/10W, SMD 0603 | R29 R49 | R_0603_1608Metric | 2 | C103196 | RALEC | RTT03000JTP
Resistor, 1.6 kOhms, ±5%, 1W, SMD 2512 | R73 R74 | R_2512_6332Metric_Pad1.40x3.35mm_HandSolder | 2 | C453392 | FH (Guangdong Fenghua Advanced Tech) | RC-12K162JT
Resistor, 1.02 kOhms, ±0.1%, 1/10W, SMD 0603 | R26 R35 R38 R40 R43 R50 | R_0603_1608Metric | 6 | C705819 | YAGEO | RT0603BRE071K02L
Resistor, 1.5 kOhms, ±1%, 1/10W, SMD 0603 | R57 R58 R90 | R_0603_1608Metric | 3 | C285210 | Viking Tech | CR-03FA7---1K5
Resistor, 100k Ohms, ±1%, 1/10W, SMD 0603 | R1 R3 R5 R6 R13 R36 R37 R41 R42 R76 R81 R85 R104 R114 R117 | R_0603_1608Metric | 15 | C14675 | YAGEO | RC0603FR-07100KL
Pulse-Proof/Anti-Surge Resistor, 10 Ohms, ±1%, 1/2W, SMD 0805 | R99 R100 | R_0805_2012Metric_Pad1.20x1.40mm_HandSolder | 2 | C441969 | PANASONIC | ERJP06F10R0V
Resistor, 10 kOhms, ±1%, 1/10W, SMD 0603 | R14 R23 R107 | R_0603_1608Metric | 3 | C98220 | YAGEO | RC0603FR-0710KL
Resistor, 120 Ohms, ±0.1%, 1/8W, SMD 0805 | R103 | R_0805_2012Metric_Pad1.20x1.40mm_HandSolder | 1 | C2828708 | Viking Tech | ARG05BTC1200
Resistor, 130 Ohms, ±1%, 1W, SMD 2512 | R32 R34 R45 R47 | R_2512_6332Metric_Pad1.40x3.35mm_HandSolder | 4 | C728111 | YAGEO | AC2512FK-07130RL
Resistor, 160 Ohms, ±5%, 1/8W, SMD 0603 | R88 R89 R93 | R_0603_1608Metric | 3 | C171721 | KOA Speer Elec | RK73B1JTTD161J
Resistor, 1.0 kOhms, ±1%, 1/10W, SMD 0603 | R2 R21 R59 R60 R75 R80 R86 R96 R97 R105 R116 | R_0603_1608Metric | 11 | C22548 | YAGEO | RC0603FR-071KL
Resistor, 2.4 Ohms, ±1%, 1W, SMD 2512 | R31 R33 R44 R46 | R_2512_6332Metric_Pad1.40x3.35mm_HandSolder | 4 | C175225 | Ever Ohms Tech | CR2512F2R40E04S
Resistor, 22 Ohms, ±1%, 1/10W, SMD 0603 | R91 R92 | R_0603_1608Metric | 2 | C107701 | YAGEO | RC0603FR-0722RL
Resistor, 270 Ohms, ±0.1%, 1/10W, SMD 0603 | R24 | R_0603_1608Metric | 1 | C861270 | YAGEO | RT0603BRD07270RL
Resistor, 2 Ohms, ±5%, 2W, SMD 2512 | R30 R48 | R_2512_6332Metric_Pad1.40x3.35mm_HandSolder | 2 | C91926 | Ever Ohms Tech | CRH2512J2R00E04S
Resistor, 2k Ohms, ±5%, 1/10W, SMD 0603 | R10 R77 R78 R79 R82 | R_0603_1608Metric | 5 | C103396 | RALEC | RTT03202JTP
Resistor, 2.7 kOhms, ±1%, 1/10W, SMD 0603 | R8 R15 R16 R22 R53 R54 R55 R56 R61 R62 R87 R94 R95 R118 R119 R120 | R_0603_1608Metric | 16 | C114612 | YAGEO | RC0603FR-072K7L
Resistor, 330 Ohms, ±1%, 1/10W, SMD 0603 | R12 R106 R115 | R_0603_1608Metric | 3 | C144102 | YAGEO | AF0603FR-07330RL
Resistor, 33 Ohms, ±1%, 1/10W, SMD 0603 | R17 R18 R19 R20 R27 R28 R51 R52 R63 R64 R65 R66 R67 R68 R69 R70 R71 R72 R83 R84 R98 R108 R109 R110 R111 R112 R113 | R_0603_1608Metric | 27 | C108661 | YAGEO | RC0603FR-0733RL
Resistor, 47 kOhms, ±0.1%, 1/10W, SMD 0603 | R101 | R_0603_1608Metric | 1 | C2828645 | Viking Tech | AR03BTCX4702
Resistor, 5.62k Ohms, ±5%, 250 mW, SMD 0805 | R9 | R_0805_2012Metric_Pad1.20x1.40mm_HandSolder | 1 | C425493 | UNI-ROYAL(Uniroyal Elec) | TC0550D5621T5E
Resistor, 510 Ohms, ±0.1%, 1/10W, SMD 0603 | R25 | R_0603_1608Metric | 1 | C2828640 | Viking Tech | AR03BTCX5100
Resistor, 680 Ohms, ±1%, 1/10W, SMD 0603 | R11 | R_0603_1608Metric | 1 | C2097840 | YAGEO | AF0603FR-07680RL
Resistor, 82 kOhms, ±0.1%, 1/10W, SMD 0603 | R4 R7 R102 | R_0603_1608Metric | 3 | C728598 | YAGEO | RT0603BRD0782KL
Current Sense Resistor, 8 mOhms, ±1%, 2 W, SMD 2512 | R39 | R_2512_6332Metric_Pad1.40x3.35mm_HandSolder | 1 | C2440282 | JU YONG CHANG | AND2512EFR008
Unidirectional Transient Voltage Suppressor, 400W, 12Vrwm, 14.7 V Max. Breakdown Voltage, 19.9 Max. Clamping Voltage, 20.1 Ippm, SOD123W | TV4 TV6 TV11 TV16 TV17 TV18 | D_SOD-123 | 6 | C456115 | Nexperia | PTVS12VS1UR,115
Unidirectional Transient Voltage Suppressor, 400W, 30Vrwm, 36.8 V Max. Breakdown Voltage, 48.4 Max. Clamping Voltage, 8.3 Ippm, SOD123W | TV14 TV15 | D_SOD-123 | 2 | C553410 | Nexperia | PTVS30VS1UR,115
Unidirectional Transient Voltage Suppressor, 350W, 3.3 Vrwm, 6 V Max. Breakdown Voltage, 8 Max. Clamping Voltage, 43.8 Ippm, SOD123W | TV3 TV20 | D_SOD-123 | 2 | C183521 | Nexperia | PTVS3V3S1UR,115
Unidirectional Transient Voltage Suppressor, 350W, 5 Vrwm, 7 V Max. Breakdown Voltage, 9.2 Max. Clamping Voltage, 43.5 Ippm, SOD123W | TV2 TV5 TV7 TV8 TV9 TV10 TV12 TV13 | D_SOD-123 | 8 | C478011 | Nexperia | PTVS5V0S1UR,115
7V/12V, 600W Asymmetrical TVS Diode Array, SOT-23 | TV19 | SOT-23-3 | 1 | C293966 | BOURNS | CDSOT23-SM712
Unidirectional Transient Voltage Suppressor, 400W, 30Vrwm, 36.8 V Max. Breakdown Voltage, 48.4 Max. Clamping Voltage, 8.3 Ippm, SOD123W | TV1 | D_SMB_Handsoldering | 1 | C83851 | Littelfuse | SMBJ30A
Optocoupler, Logic output, 3.3 V/5 V Dual supply voltage, 15 MBd, SOIC-8pa | U29 U30 U31 | SMDIP-8_W7.62mm | 3 | C92651 | Lite-On | 6N137S-TA1-L
Dual supply translating transceiver, 3-state, 2-bit, VSSOP-8 | U6 U8 U21 U22 U23 U24 | VSSOP-8_2.3x2mm_P0.5mm | 6 | C730237 | Nexperia | 74LVC2T45DC,125
±20A Bidirectional Hall-Effect Current Sensor, +5.0V supply, 100mV/A, SOIC-8 | U12 | SOIC-8_3.9x4.9mm_P1.27mm | 1 | C10681 | Allegro MicroSystems, LLC | ACS712ELCTR-20A-T
70V Bidirectional, Zero Drift, Current Sense Amplifier, 20V/V gain, bandwidth 250kHz, VS=2.7V~5.5V, SOIC-8/MSOP-8 | U18 | MSOP-8_3x3mm_P0.65mm | 1 | C147928 | Analog Devices | AD8418BRMZ-RL
MOSFET Transistor, 30Vdss, 100A @ 25°C, 2.8mOhm, 20Vgss | U13 U14 U16 U17 | TDSON-8-1 | 4 | C534382 | Infineon Technologies | BSC0902NSI
High-side and low-side gate driver, 600V, 350/650mA, SOIC-8 | U11 U20 | SOIC-8_3.9x4.9mm_P1.27mm | 2 | C128796 | onsemi | FAN7382MX
1A Low drop-out regulator, Fixed Output 3.3V, TO-252 (DPAK) | U5 U35 | TO-252-2 | 2 | C152529 | onsemi | NCP1117DT33T5G
1A Low drop-out regulator, Fixed Output 5V, TO-252 (DPAK) | U4 | TO-252-2 | 1 | C152470 | onsemi | NCP1117DT50RKG
3.3V, 20 Mbps RS-485 Transceiver With IEC ESD protection, SOIC-8 | U34 | SOIC-8_3.9x4.9mm_P1.27mm | 1 | C57928 | Texas Instruments | SN65HVD75DR
Single Inverter Gate, 1.65 V to 5.5 V, 24 mA Output drive at 3.3 V, SOT-23-5 | U1 U32 | SOT-23-5_HandSoldering | 2 | C7827 | Texas Instruments | SN74LVC1G04DBVR
Dual Inverter Gate, SOT-23 | U25 U28 | SOT-23-6_Handsoldering | 2 | C10428 | Texas Instruments | SN74LVC2G04DBVR
STMicroelectronics Arm Cortex-M4 MCU, 512KB flash, 128KB RAM, 180 MHz, 1.8-3.6V, 50 GPIO, LQFP64 | U9 | LQFP-64_10x10mm_P0.5mm | 1 | C69336 | STMicroelectronics | STM32F446RET6
DC Optocoupler, Vce 80V, CTR 50-100%, SOP4 | U26 U27 | SOP-4_4.4x2.6mm_P1.27mm | 2 | C55144 | TOSHIBA | TLP291(GB-TP,SE
Low-power Operational Amplifier, SOT-353 | U7 U10 U15 U19 | SOT-23-5 | 4 | C1849429 | Texas Instruments | TLV9051IDBVR
Very low capacitance ESD protection diode, 4 data-line, SOT-23-6 | U33 | SOT-23-6_Handsoldering | 1 | C111212 | STMicroelectronics | USBLC6-4SC6
Non-isolated DC-DC switching regulator, Fixed Output 12V | U3 | CONV_VXO78012-1000 | 1 |  | CUI Inc. | VXO78012-1000 | 490-VXO7812-1000
Non-isolated DC-DC switching regulator, Fixed Output 15V | U2 | CONV_VXO78015-1000 | 1 |  | CUI Inc. | VXO78015-1000 | 490-VXO7815-1000
Wide voltage crystal oscillator, 16 MHz, 1.8V - 3.3V Supply voltage, 10 PPM Frequency tolerance @25℃, CMOS, SMD7050-4P | U36 | Oscillator_SMD_YXC_YSO110TR_7050-4Pin_7.0x5.0mm | 1 | C669093 | Yangxing Tech | OT705016MJBA4SL
