parkourlrc/pcb-tgiacomellibr--sjc-6abed6a295/deprecated/hardware_v2/outputs/doc/hardware_v2_color.pdf

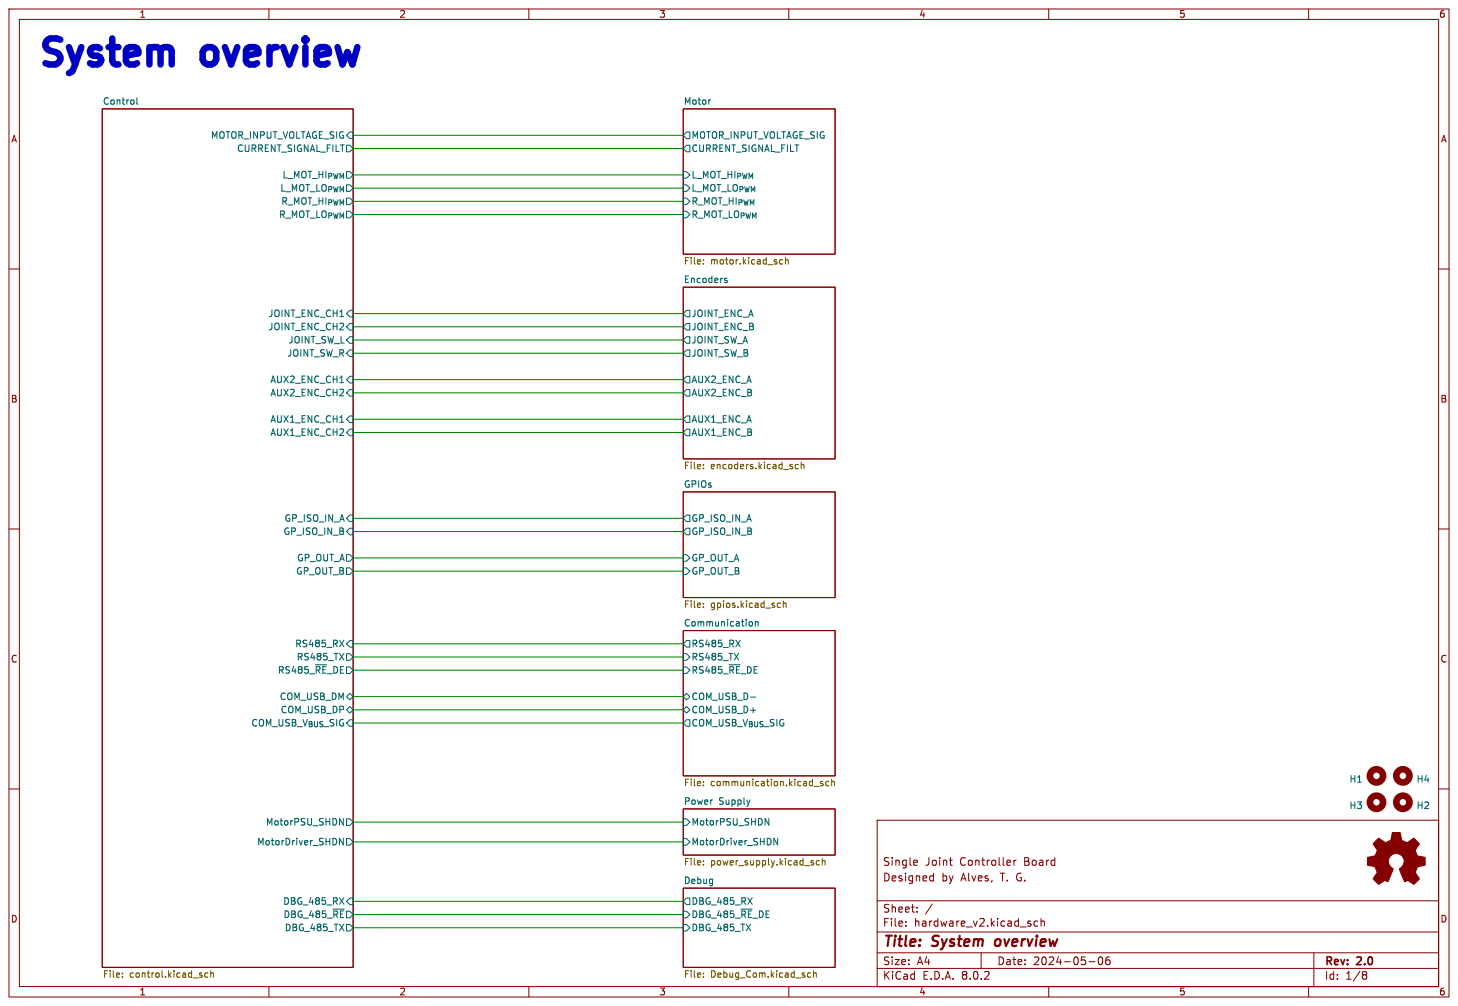
[picture p14: page 1]

R_MOT_LO_{PWM} Motor File: motor.kicad_sch

Encoders File: encoders.kicad_sch RS485_~{RE}_DE RS485_RX RS485_TX COM_USB_DP COM_USB_DM

Id: 1/8 Title: System overview

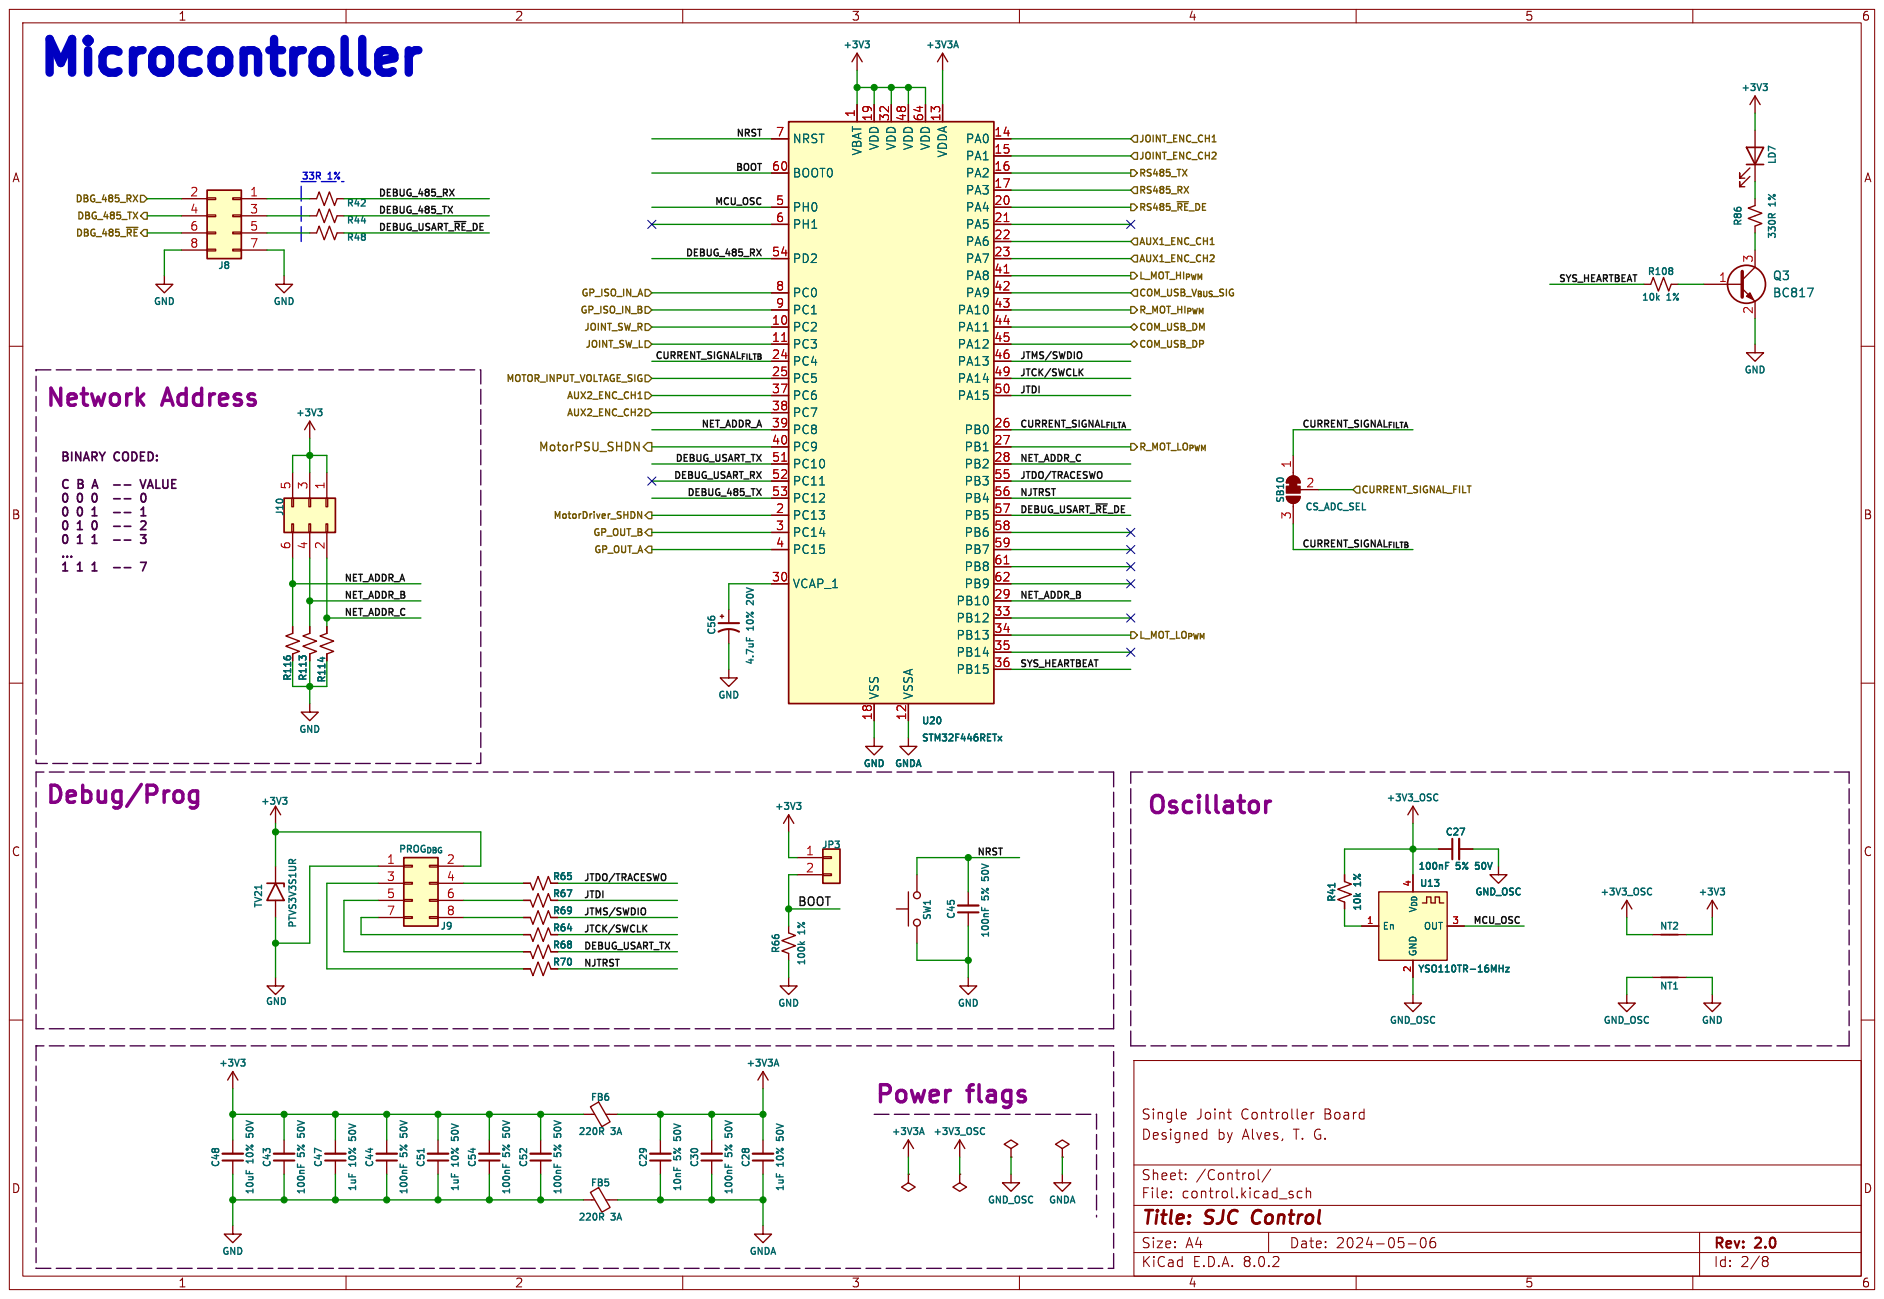
[picture p15: page 2]

1 PC2 10 PC3 11 VSSA 12 VDDA 13 PA0 14 PA1 15 PA2 16 PA3 17 VSS 18 VDD 19 PC13 2 PA4 20 PA5 21 PA6 22 PA7 23 PC4 24 PC5 25 PB0 26 PB1 27 PB2 28 PB10 29 PC14 3 VCAP_1 30 VDD 32 PB12 33 PB13 34 PB14 35 PB15 36 PC6 37 PC7 38 PC8 39 PC15 4 PC9 40 PA8 41 PA9 42 PA10 43 PA11 44 PA12 45 PA13 46 VDD 48 PA14 49 PH0 5 PA15 50 PC10 51 PC11 52 PC12 53 PD2 54 PB3 55 PB4 56 PB5 57 PB6 58 PB7 59 PH1 6 BOOT0 60 PB8 61 PB9 62 VDD 64 NRST 7 PC0 8 PC1 9 U20 STM32F446RETx R108

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

2 OUT 3 V_{DD}4U13 YSO110TR-16MHz NT1 NT2 GND GNDR113 R114 C56 4.7uF 10% 20V VBAT

DEBUG_485_RX
CURRENT_SIGNAL_{FILTA} JTCK/SWCLK DEBUG_USART_~{RE}_DE DEBUG_485_TX

JTCK/SWCLK Debug/Prog

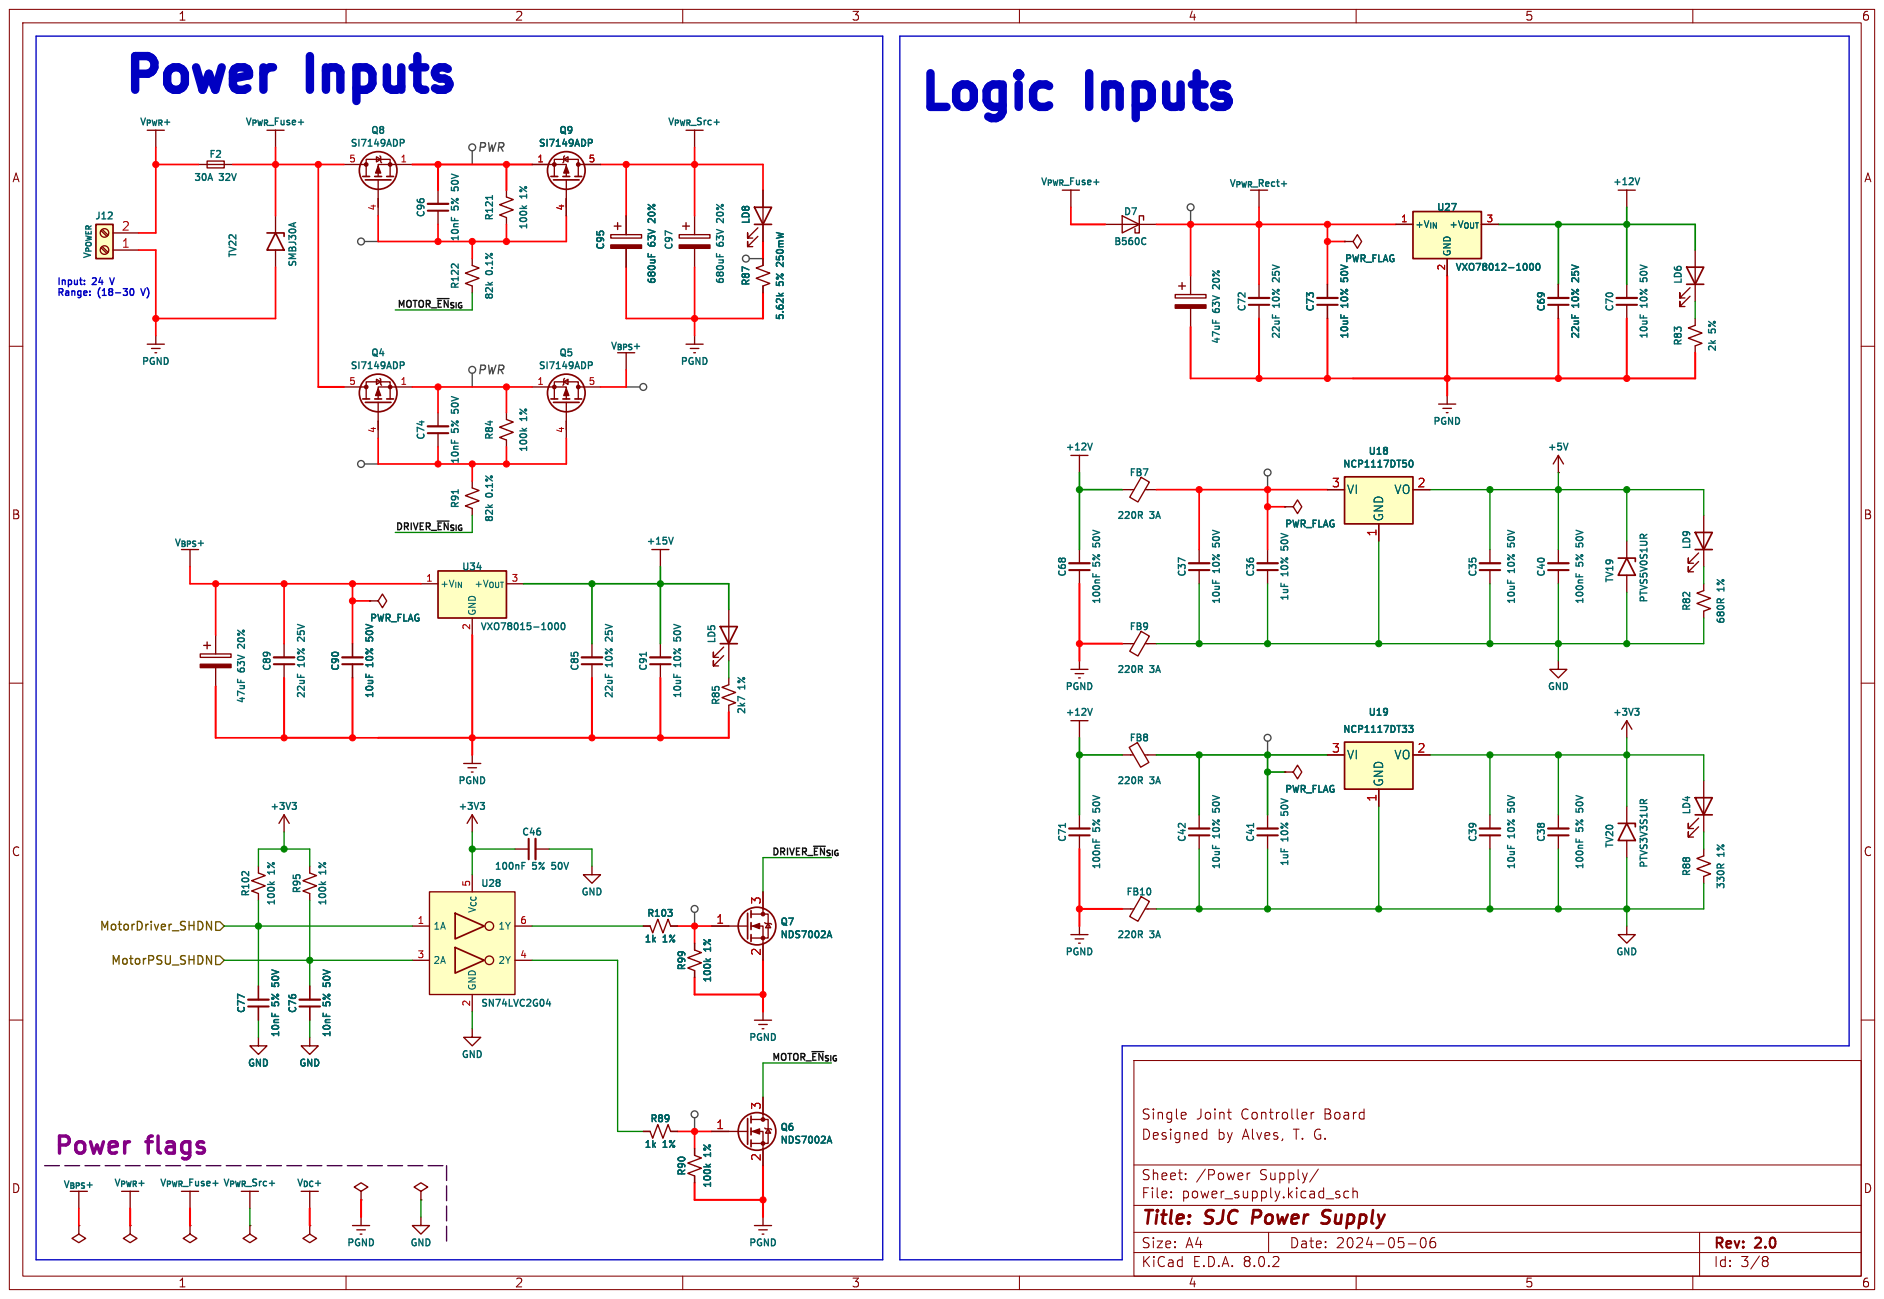
[picture p16: page 3]

MOTOR_~{EN}_{SIG} Power flags

Id: 3/8 Title: SJC Power Supply

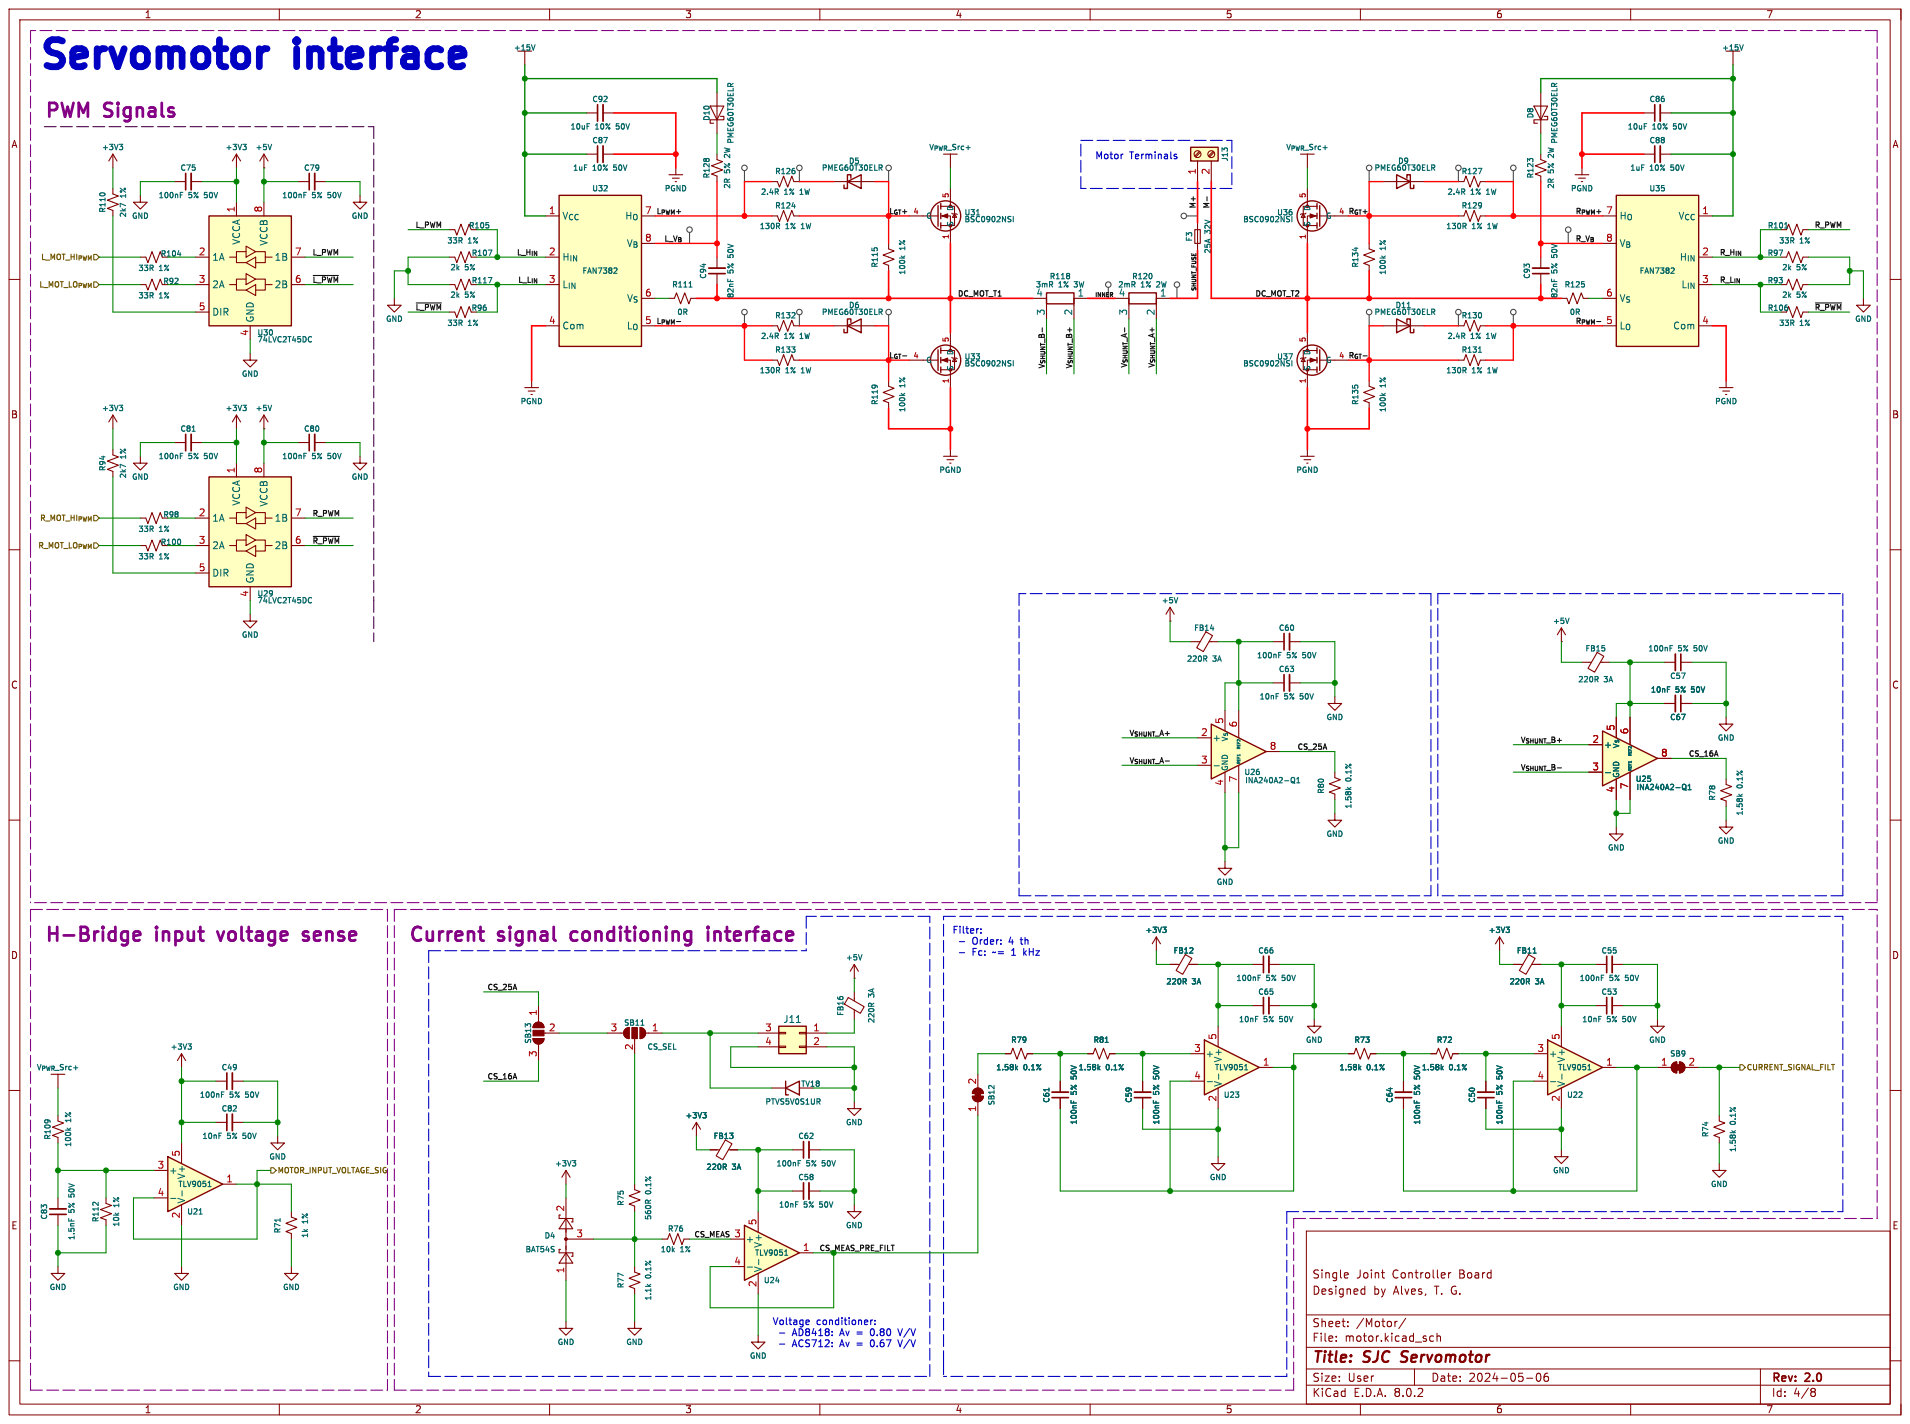
[picture p17: page 4]

- Fc: ~= 1 kHz PWM Signals

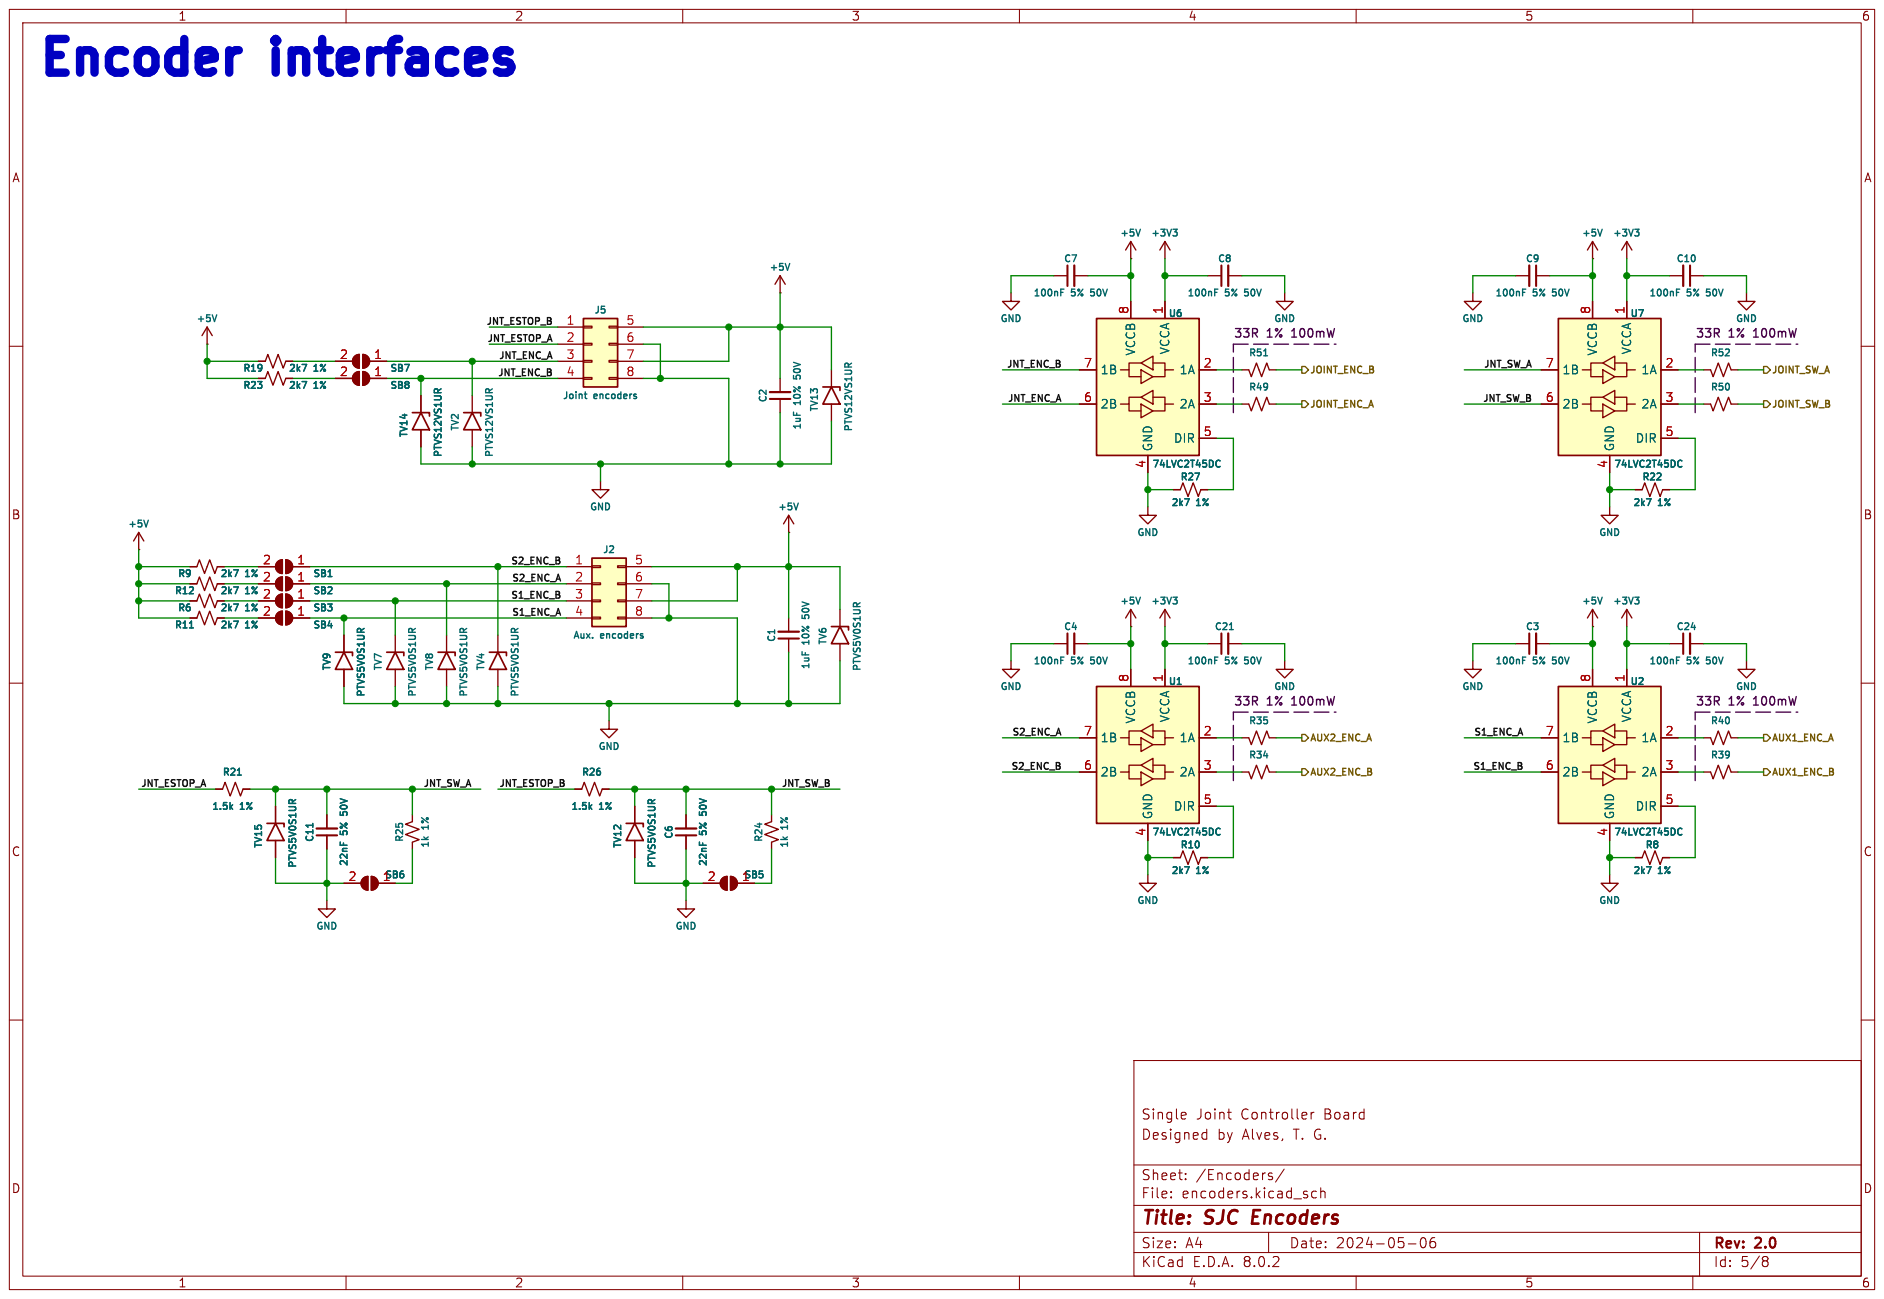
[picture p18: page 5]

Id: 5/8 Title: SJC Encoders

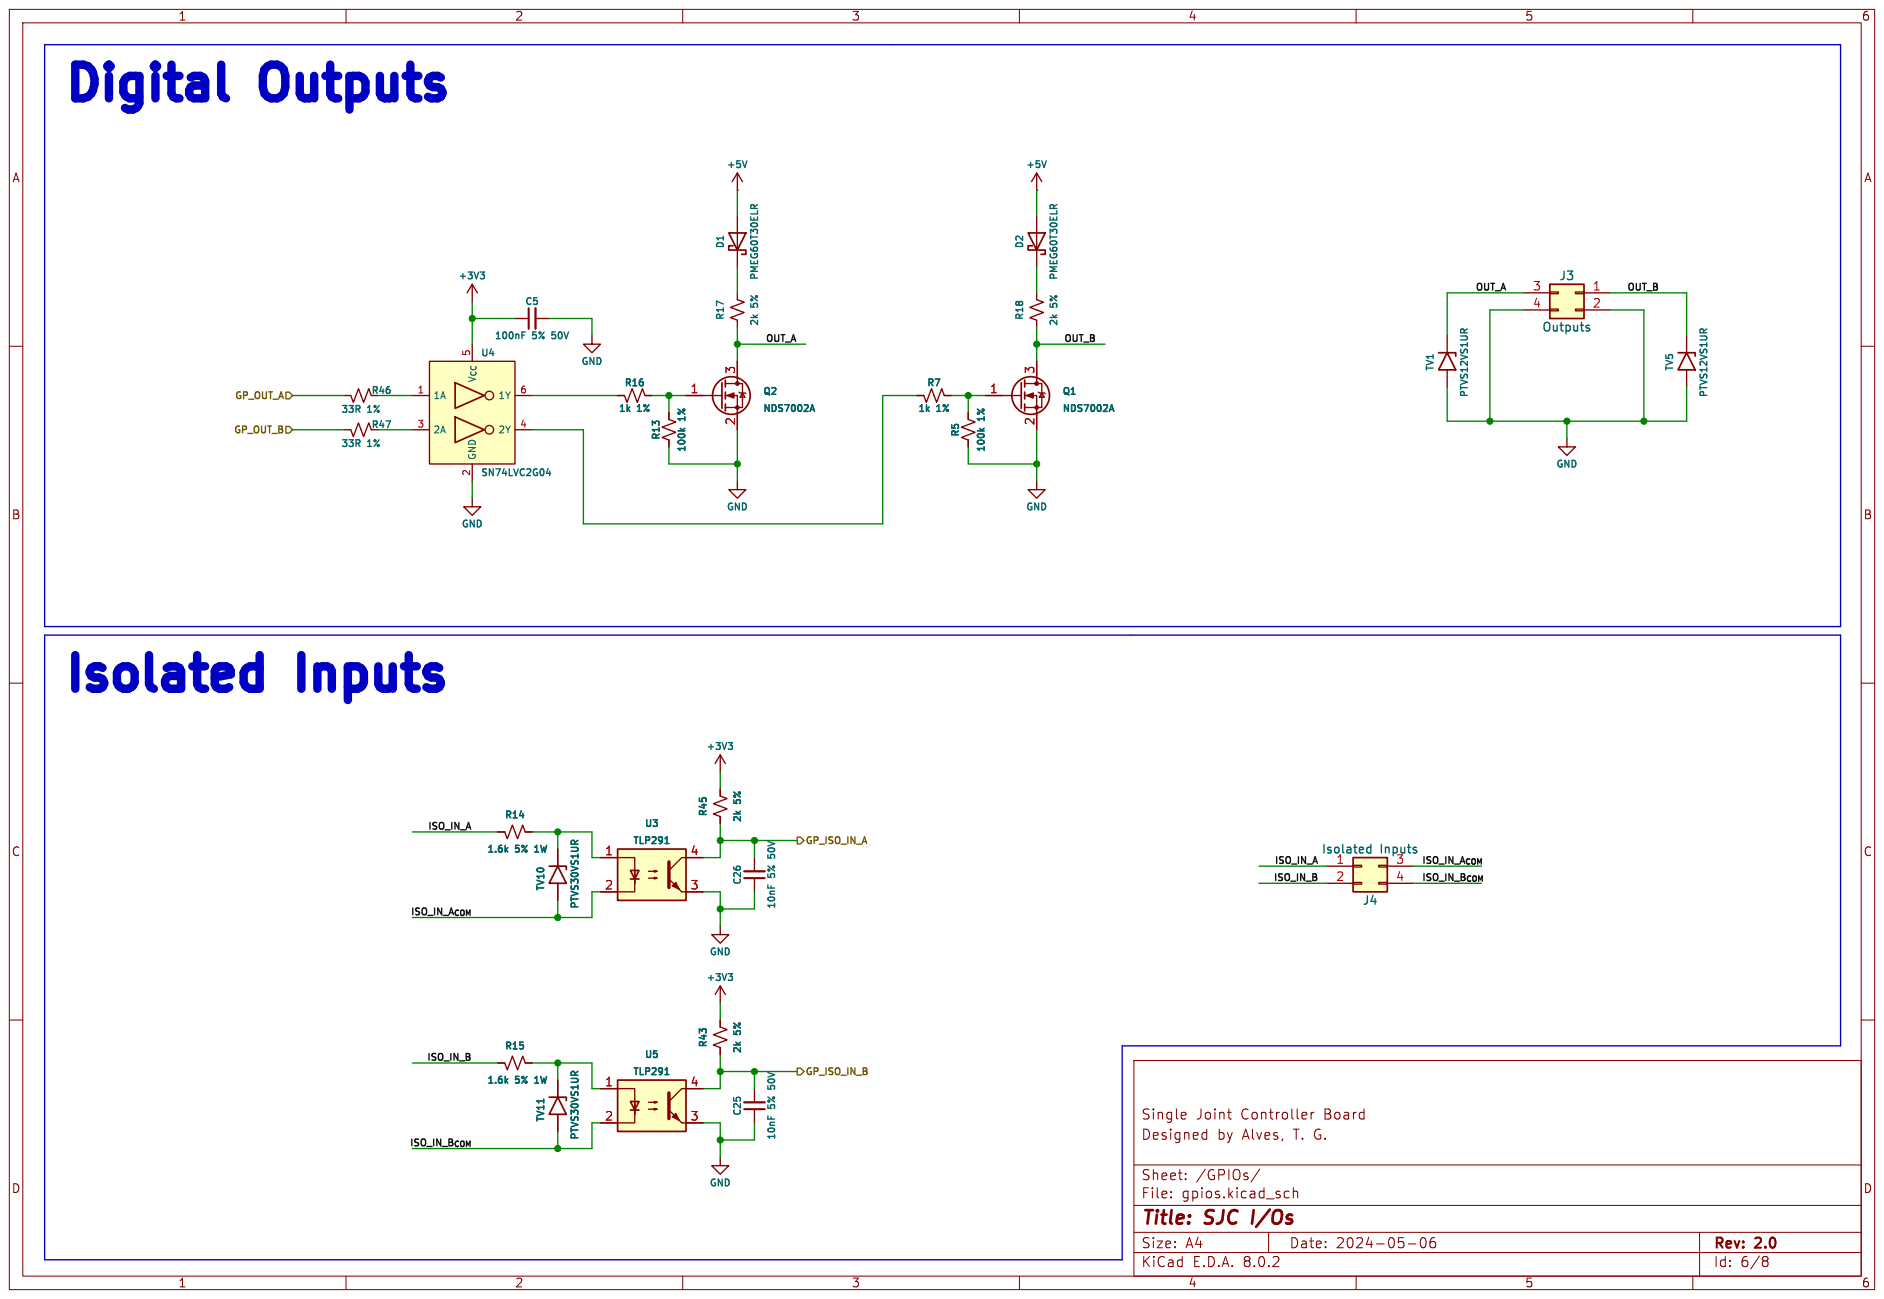
[picture p19: page 6]

Id: 6/8 Title: SJC I/Os

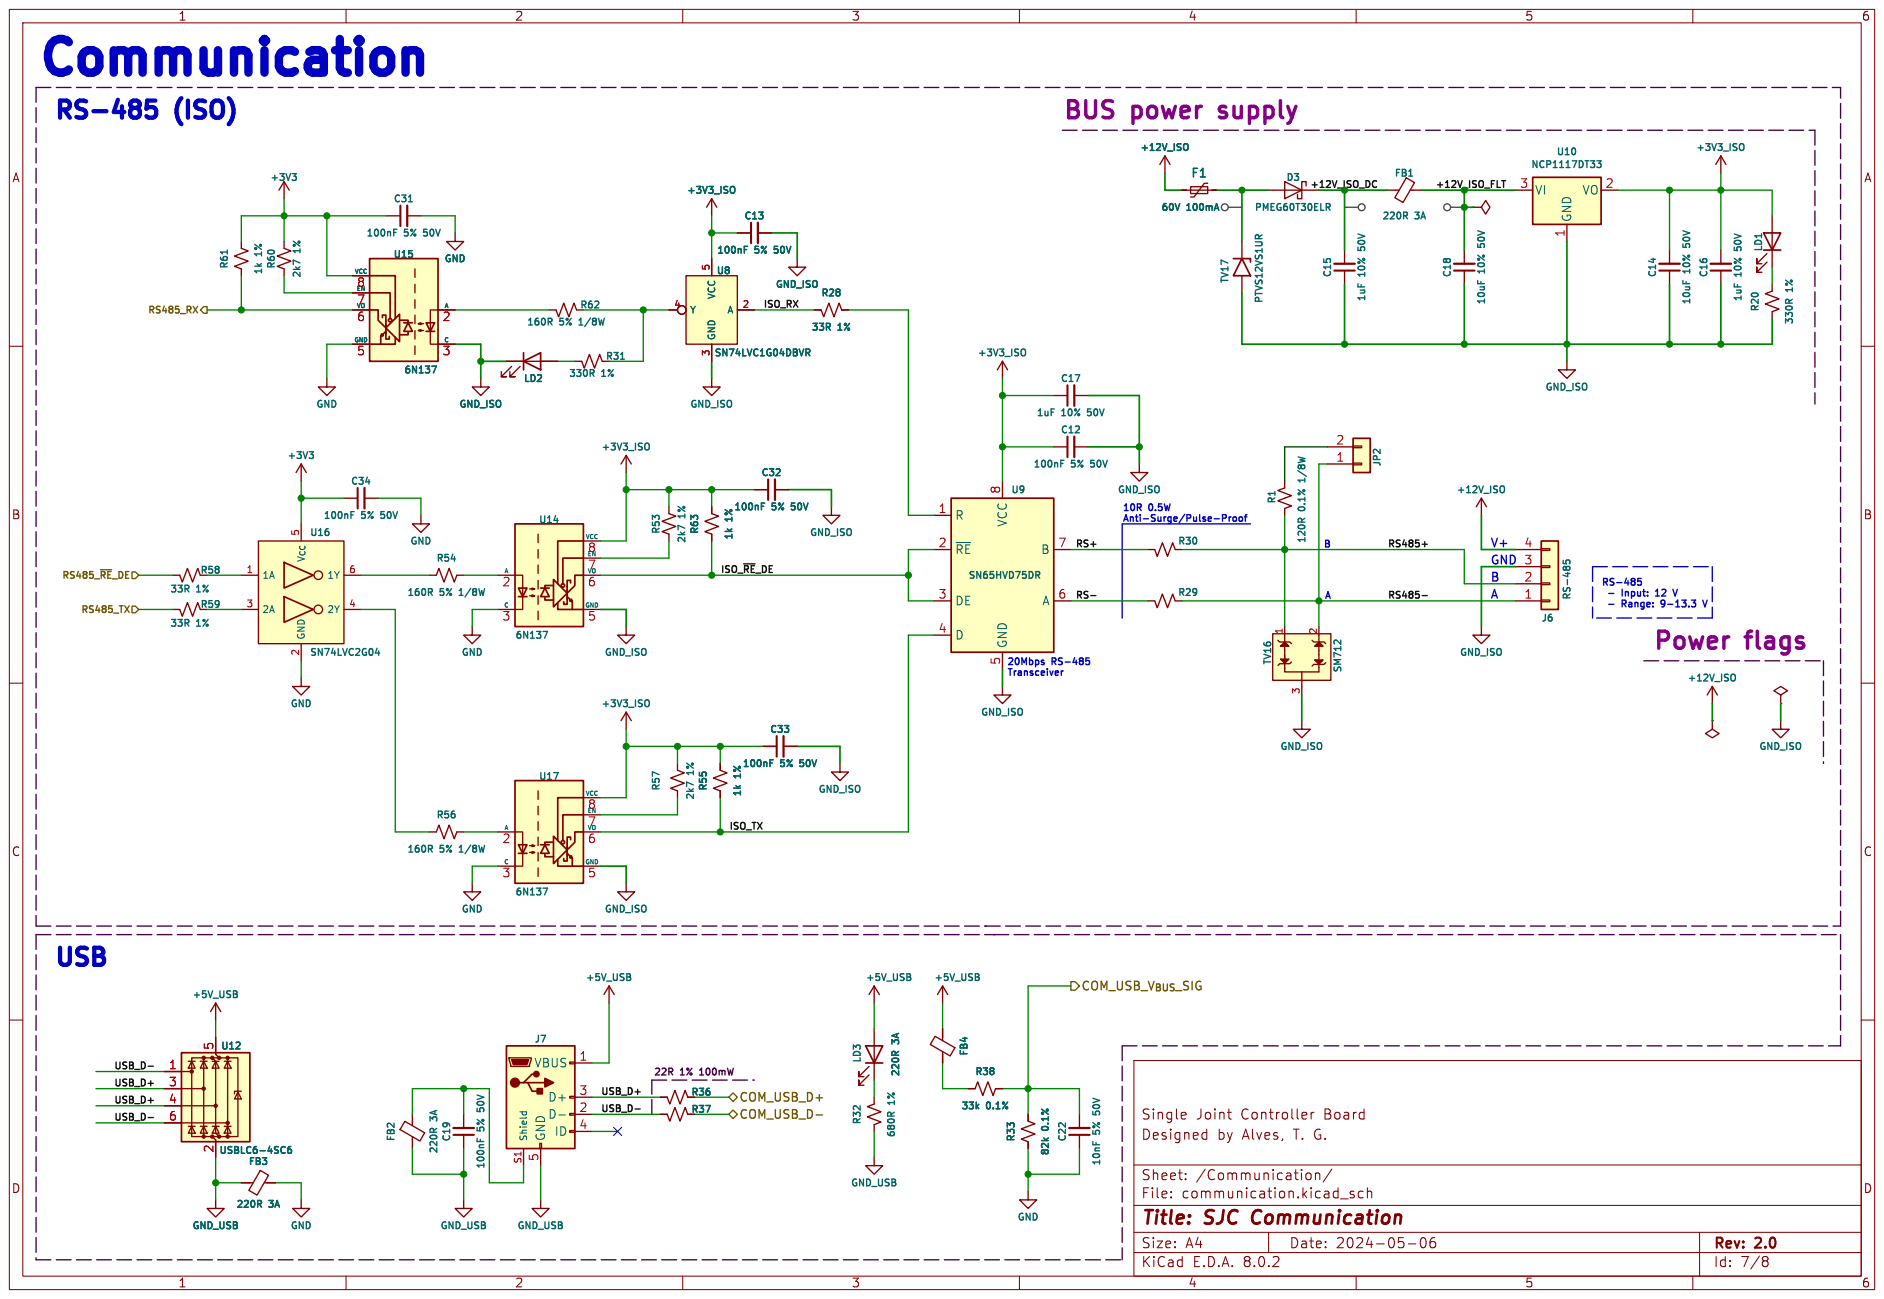
[picture p20: page 7]

Anti-Surge/Pulse-Proof GND U15
6N137 GND

Id: 7/8 Title: SJC Communication

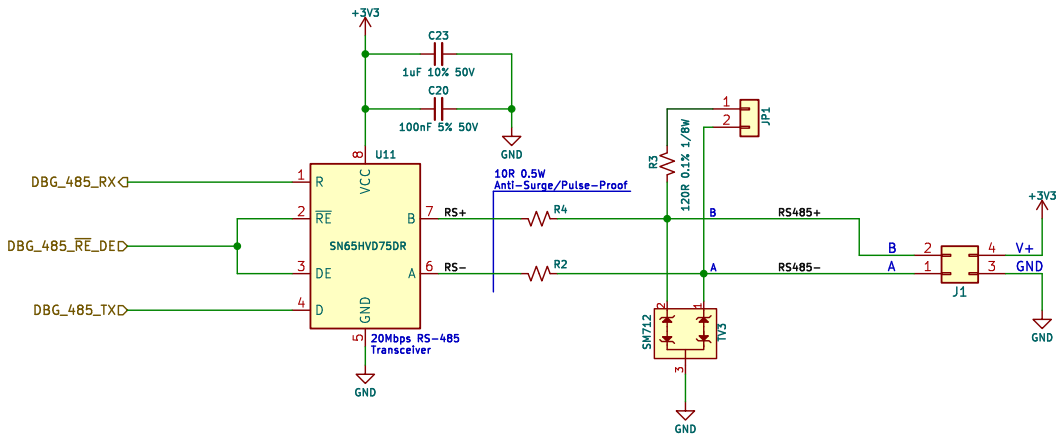
[picture p21: page 8]

Anti-Surge/Pulse-Proof

Id: 8/8 Title: Data Logger Debug Output File: Debug_Com.kicad_sch Sheet: /Debug/
