parkourlrc/pcb-tgiacomellibr--sjc-6abed6a295/hardware/outputs/deprecated/doc/hardware.pdf

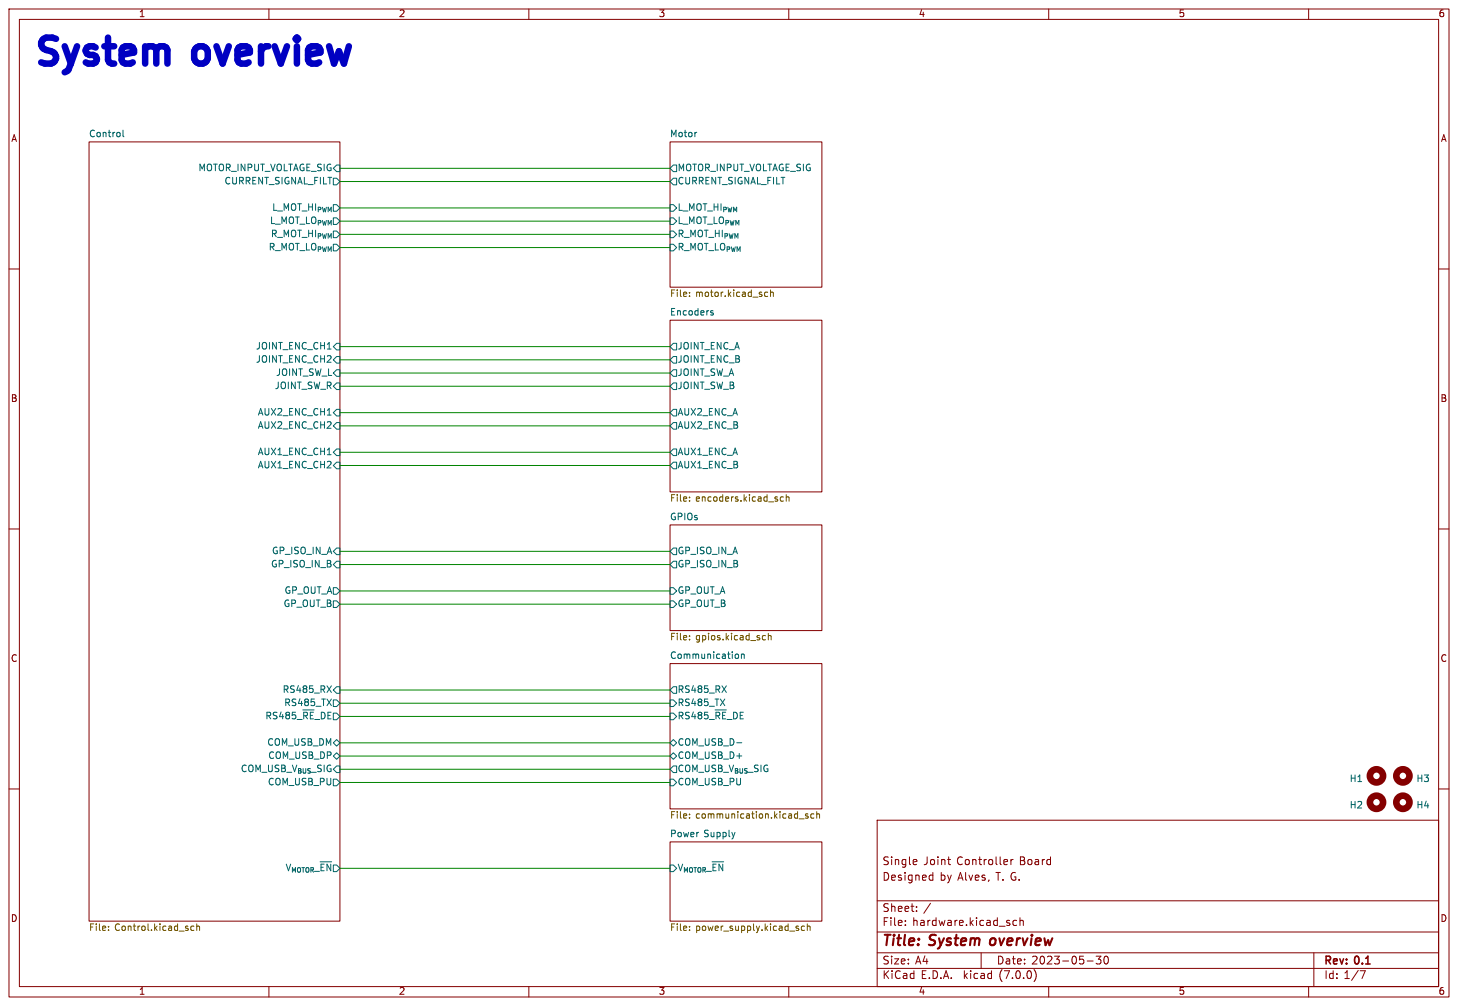
[picture p22: page 1]

R_MOT_LO_{PWM} Motor File: motor.kicad_sch
Encoders File: encoders.kicad_sch RS485_~{RE}_DE RS485_TX RS485_RX COM_USB_V_{BUS}_SIG

Id: 1/7 Title: System overview

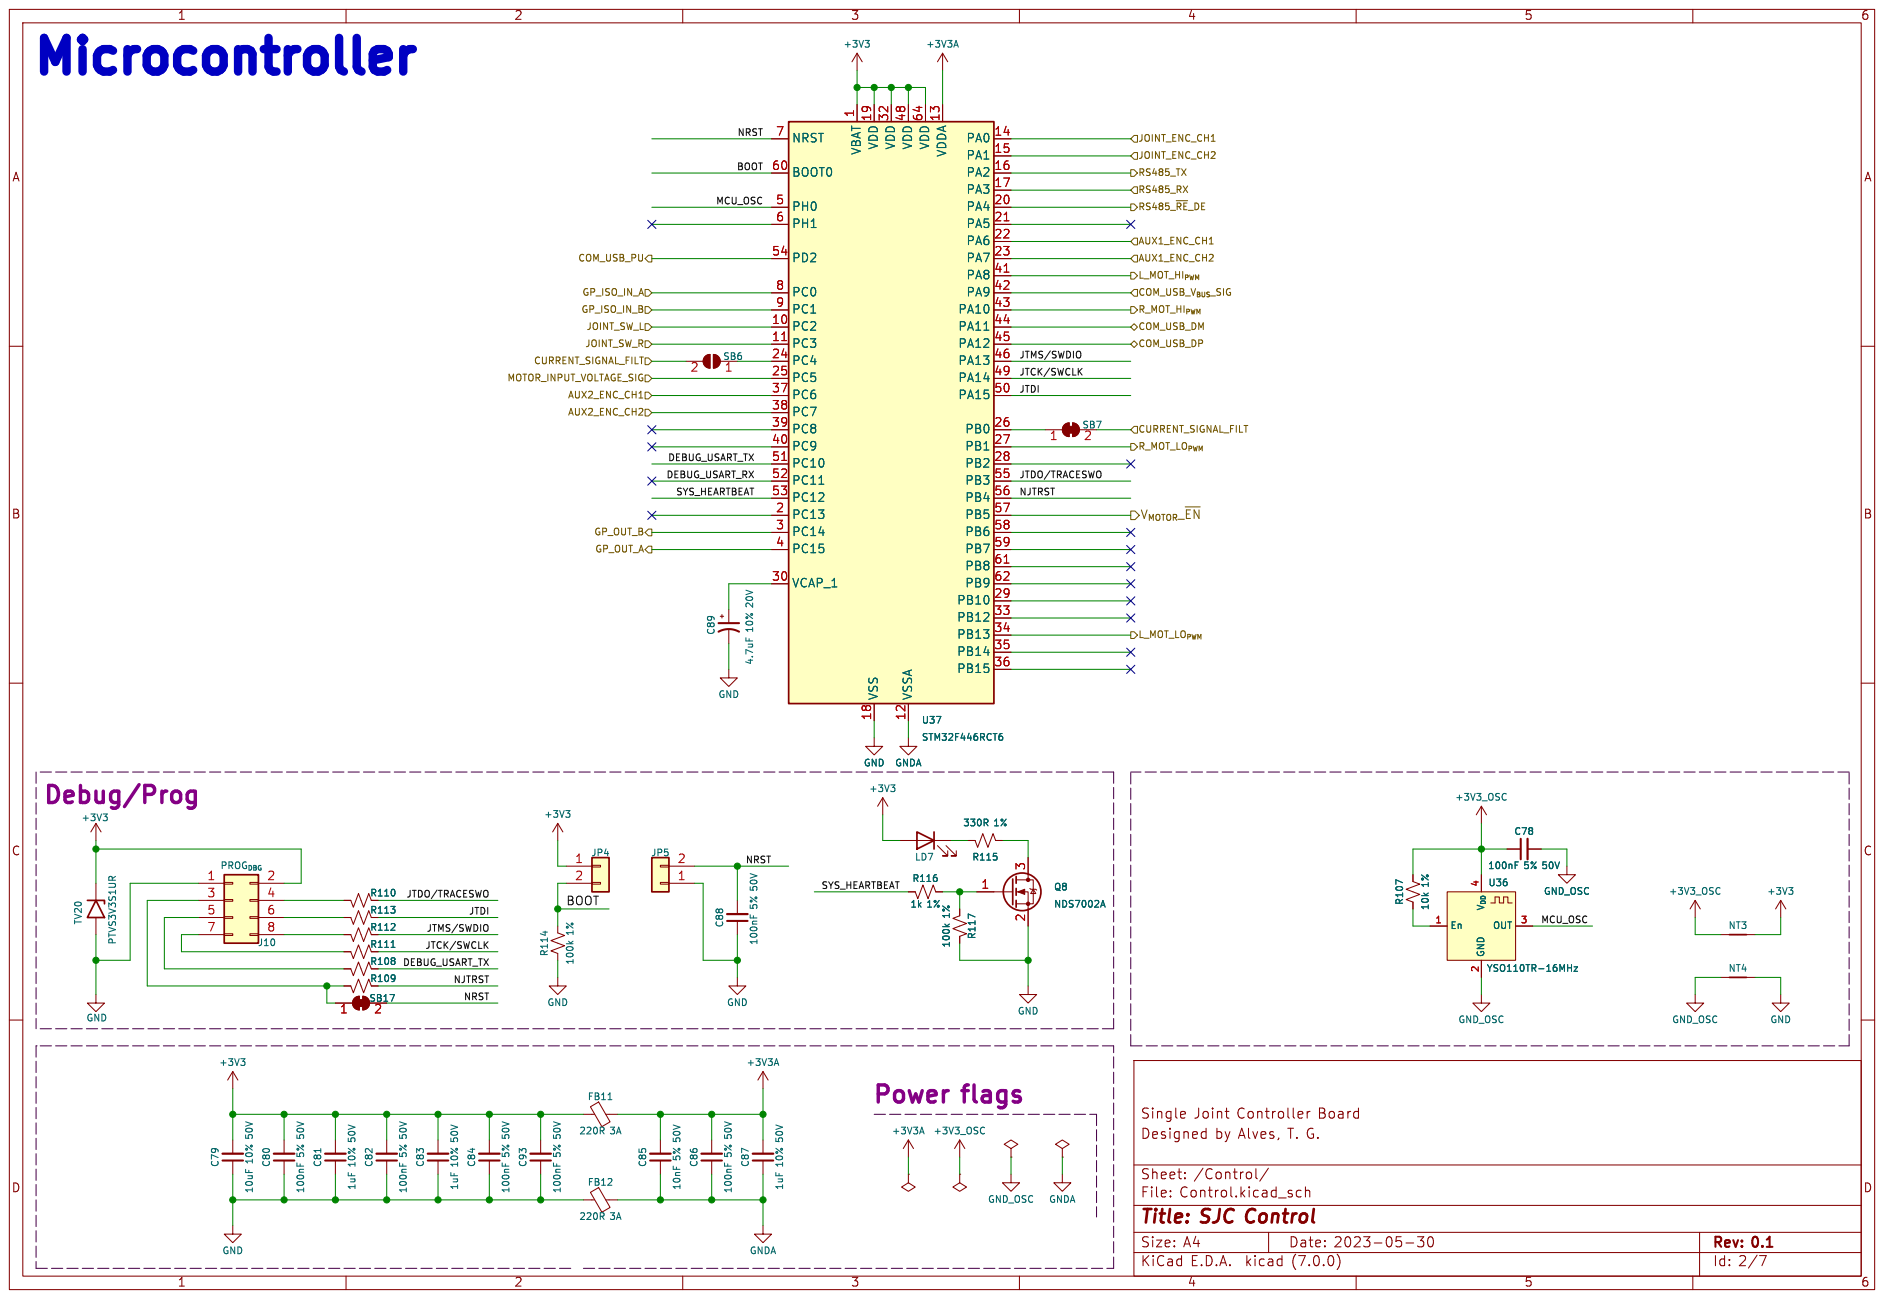
[picture p23: page 2]

1 PC2 10 PC3 11 VSSA 12 VDDA 13 PA0 14 PA1 15 PA2 16 PA3 17 VSS 18 VDD 19 PC13 2 PA4 20 PA5 21 PA6 22 PA7 23 PC4 24 PC5 25 PB0 26 PB1 27 PB2 28 PB10 29 PC14 3 VCAP_1 30 VDD 32 PB12 33 PB13 34 PB14 35 PB15 36 PC6 37 PC7 38 PC8 39 PC15 4 PC9 40 PA8 41 PA9 42 PA10 43 PA11 44 PA12 45 PA13 46 VDD 48 PA14 49 PH0 5 PA15 50 PC10 51 PC11 52 PC12 53 PD2 54 PB3 55 PB4 56 PB5 57 PB6 58 PB7 59 PH1 6 BOOT0 60 PB8 61 PB9 62 VDD 64 NRST 7 PC0 8 PC1 9 R108 R111 SB17 1 2R109 R117 100k 1%

1 PC2 10 PC3 11 VSSA 12 VDDA 13 PA0 14 PA1 15 PA2 16 PA3 17 VSS 18 VDD 19 PC13 2 PA4 20 PA5 21 PA6 22 PA7 23 PC4 24 PC5 25 PB0 26 PB1 27 PB2 28 PB10 29 PC14 3 VCAP_1 30 VDD 32 PB12 33 PB13 34 PB14 35 PB15 36 PC6 37 PC7 38 PC8 39 PC15 4 PC9 40 PA8 41 PA9 42 PA10 43 PA11 44 PA12 45 PA13 46 VDD 48 PA14 49 PH0 5 PA15 50 PC10 51 PC11 52 PC12 53 PD2 54 PB3 55 PB4 56 PB5 57 PB6 58 PB7 59 PH1 6 BOOT0 60 PB8 61 PB9 62 VDD 64 NRST 7 PC0 8 PC1 9 U37 STM32F446RCT6 GND
NJTRST BOOT NRST

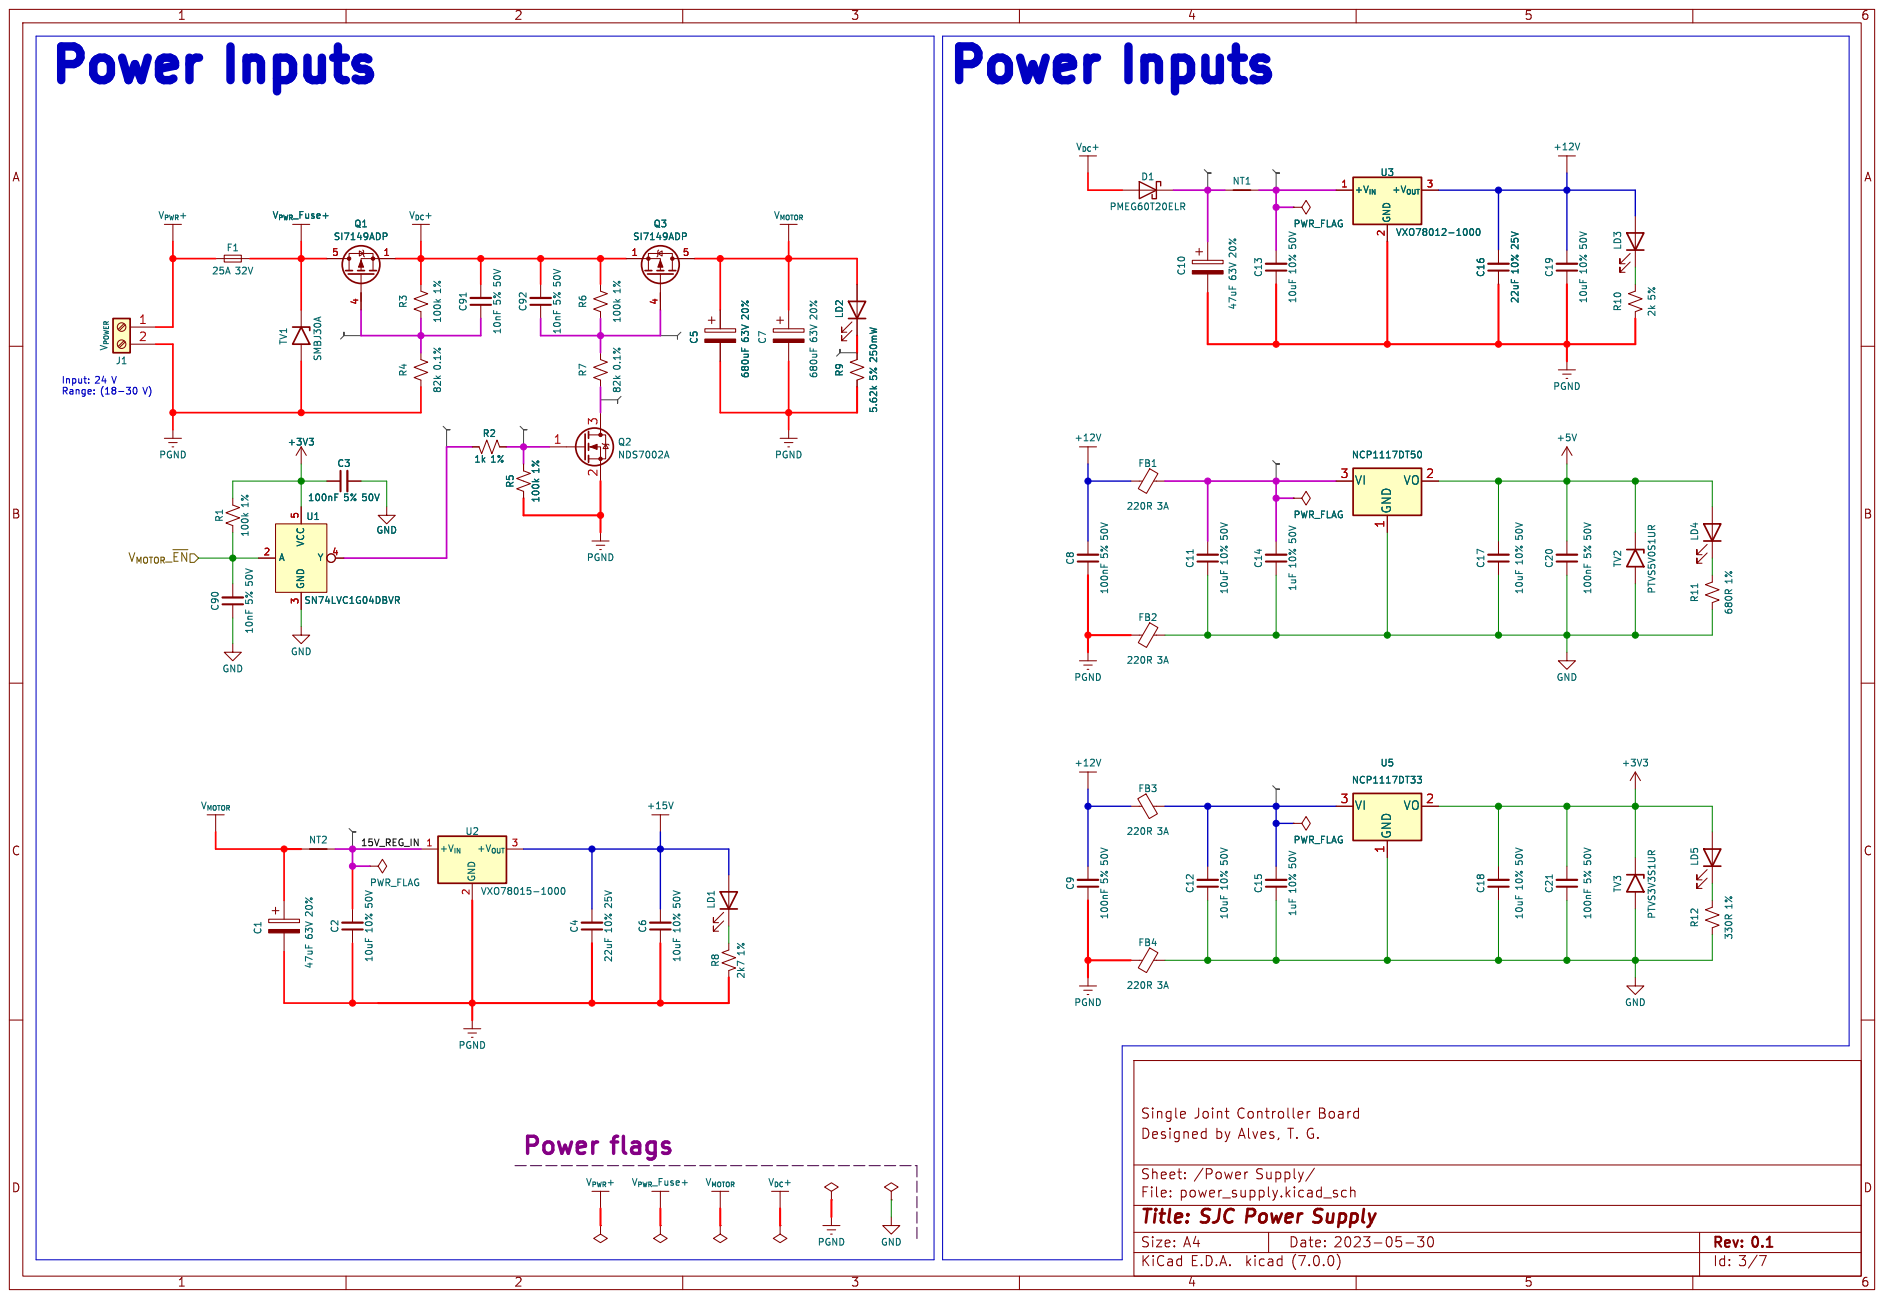
[picture p24: page 3]

1 VO 2 VI 3 C16 22uF 10% 25V U3 VXO78012-1000 +V_{IN} 1 GND

File: power_supply.kicad_sch Sheet: /Power Supply/
Id: 3/7 Title: SJC Power Supply

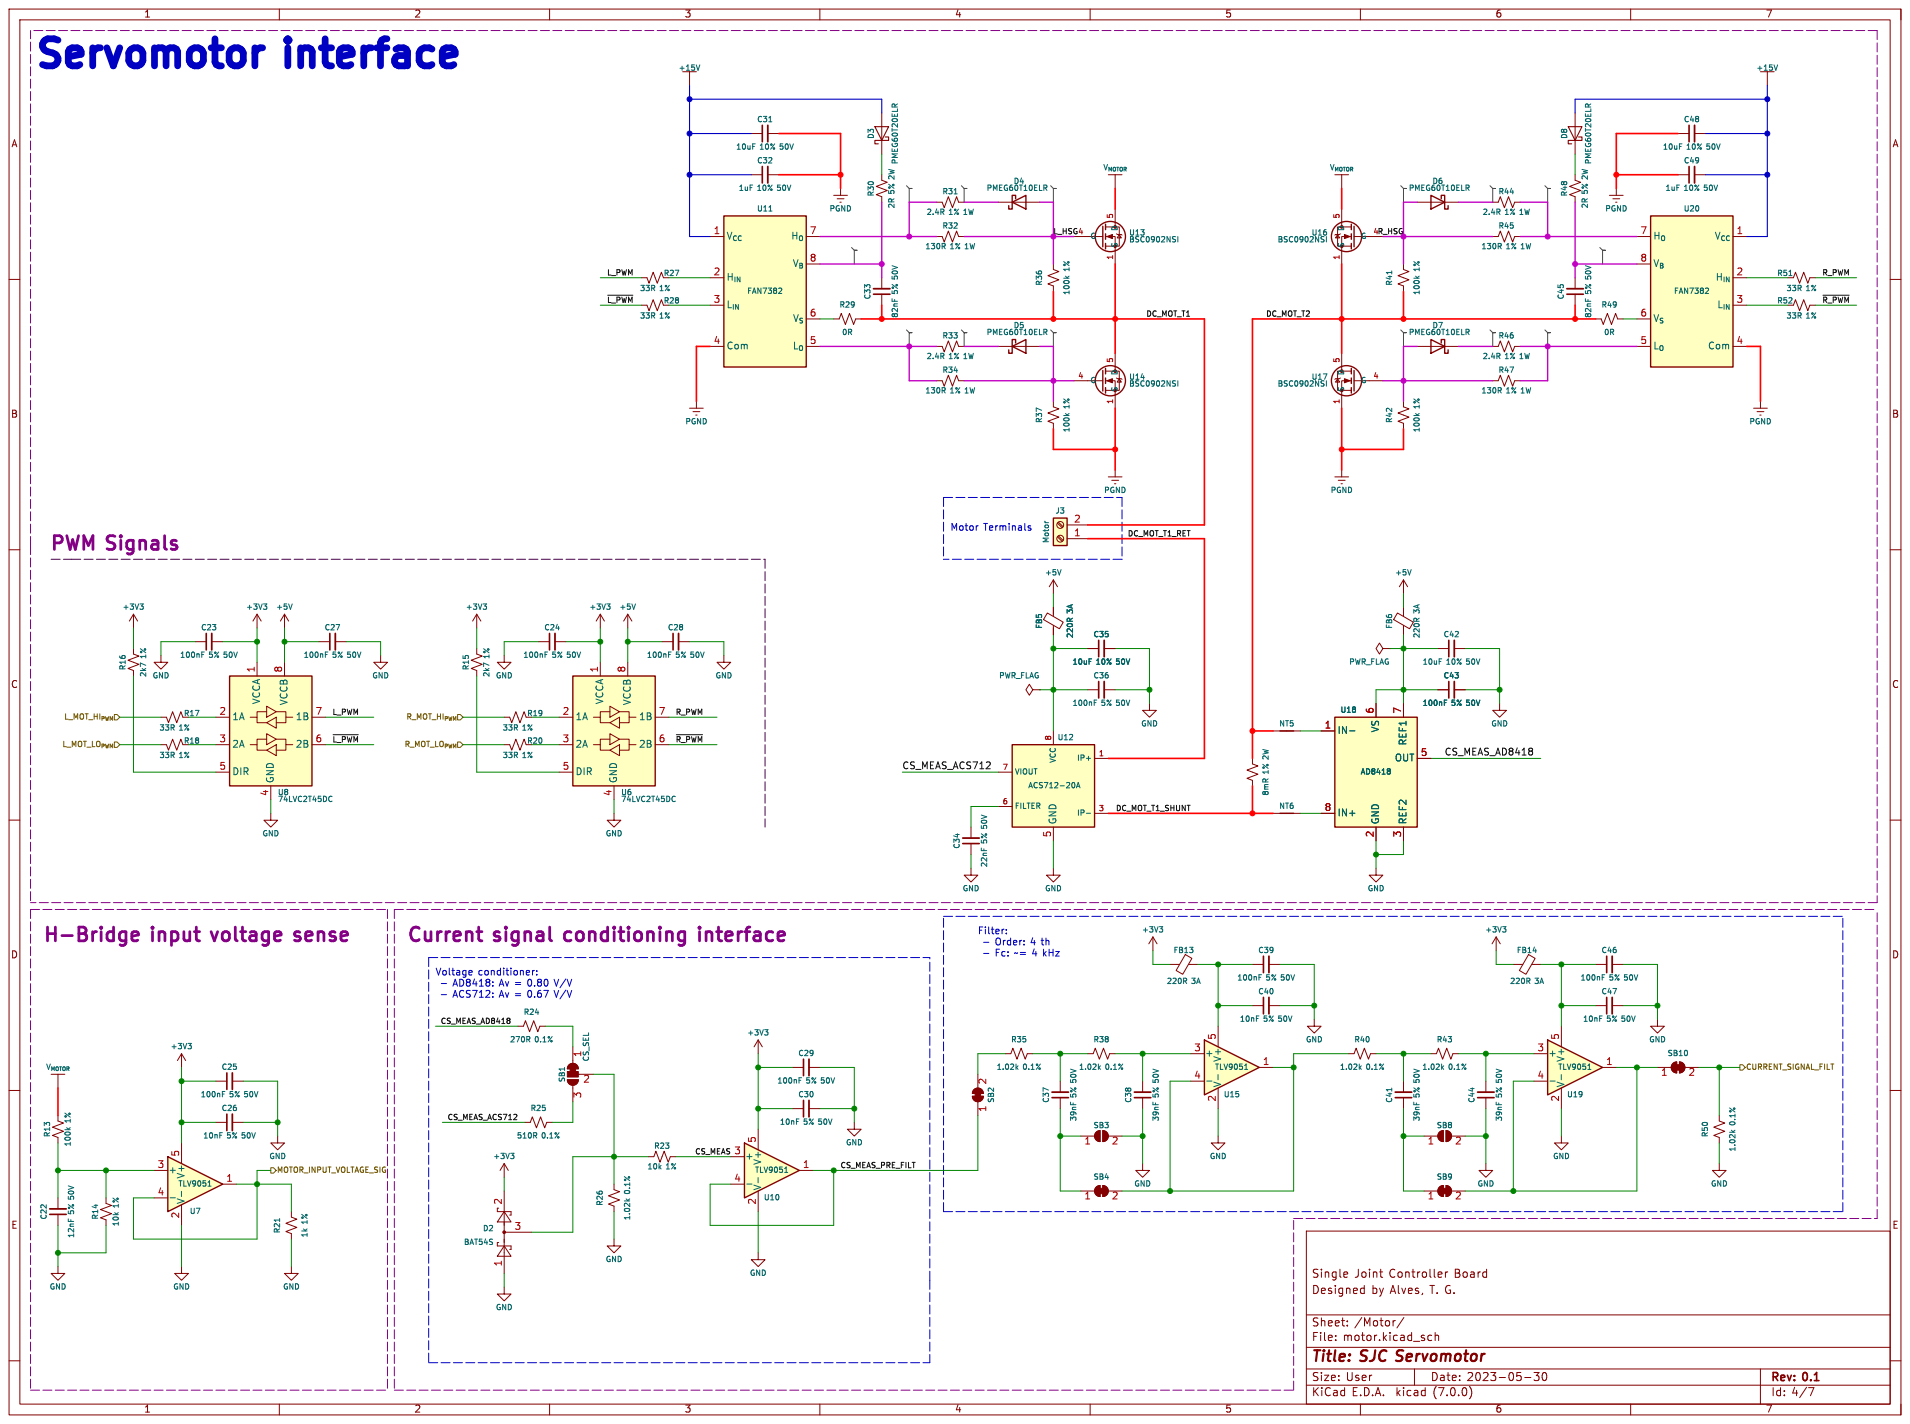
[picture p25: page 4]

DC_MOT_T2 Motor Terminals Voltage conditioner: - AD8418: Av = 0.80 V/V

Current signal conditioning interface

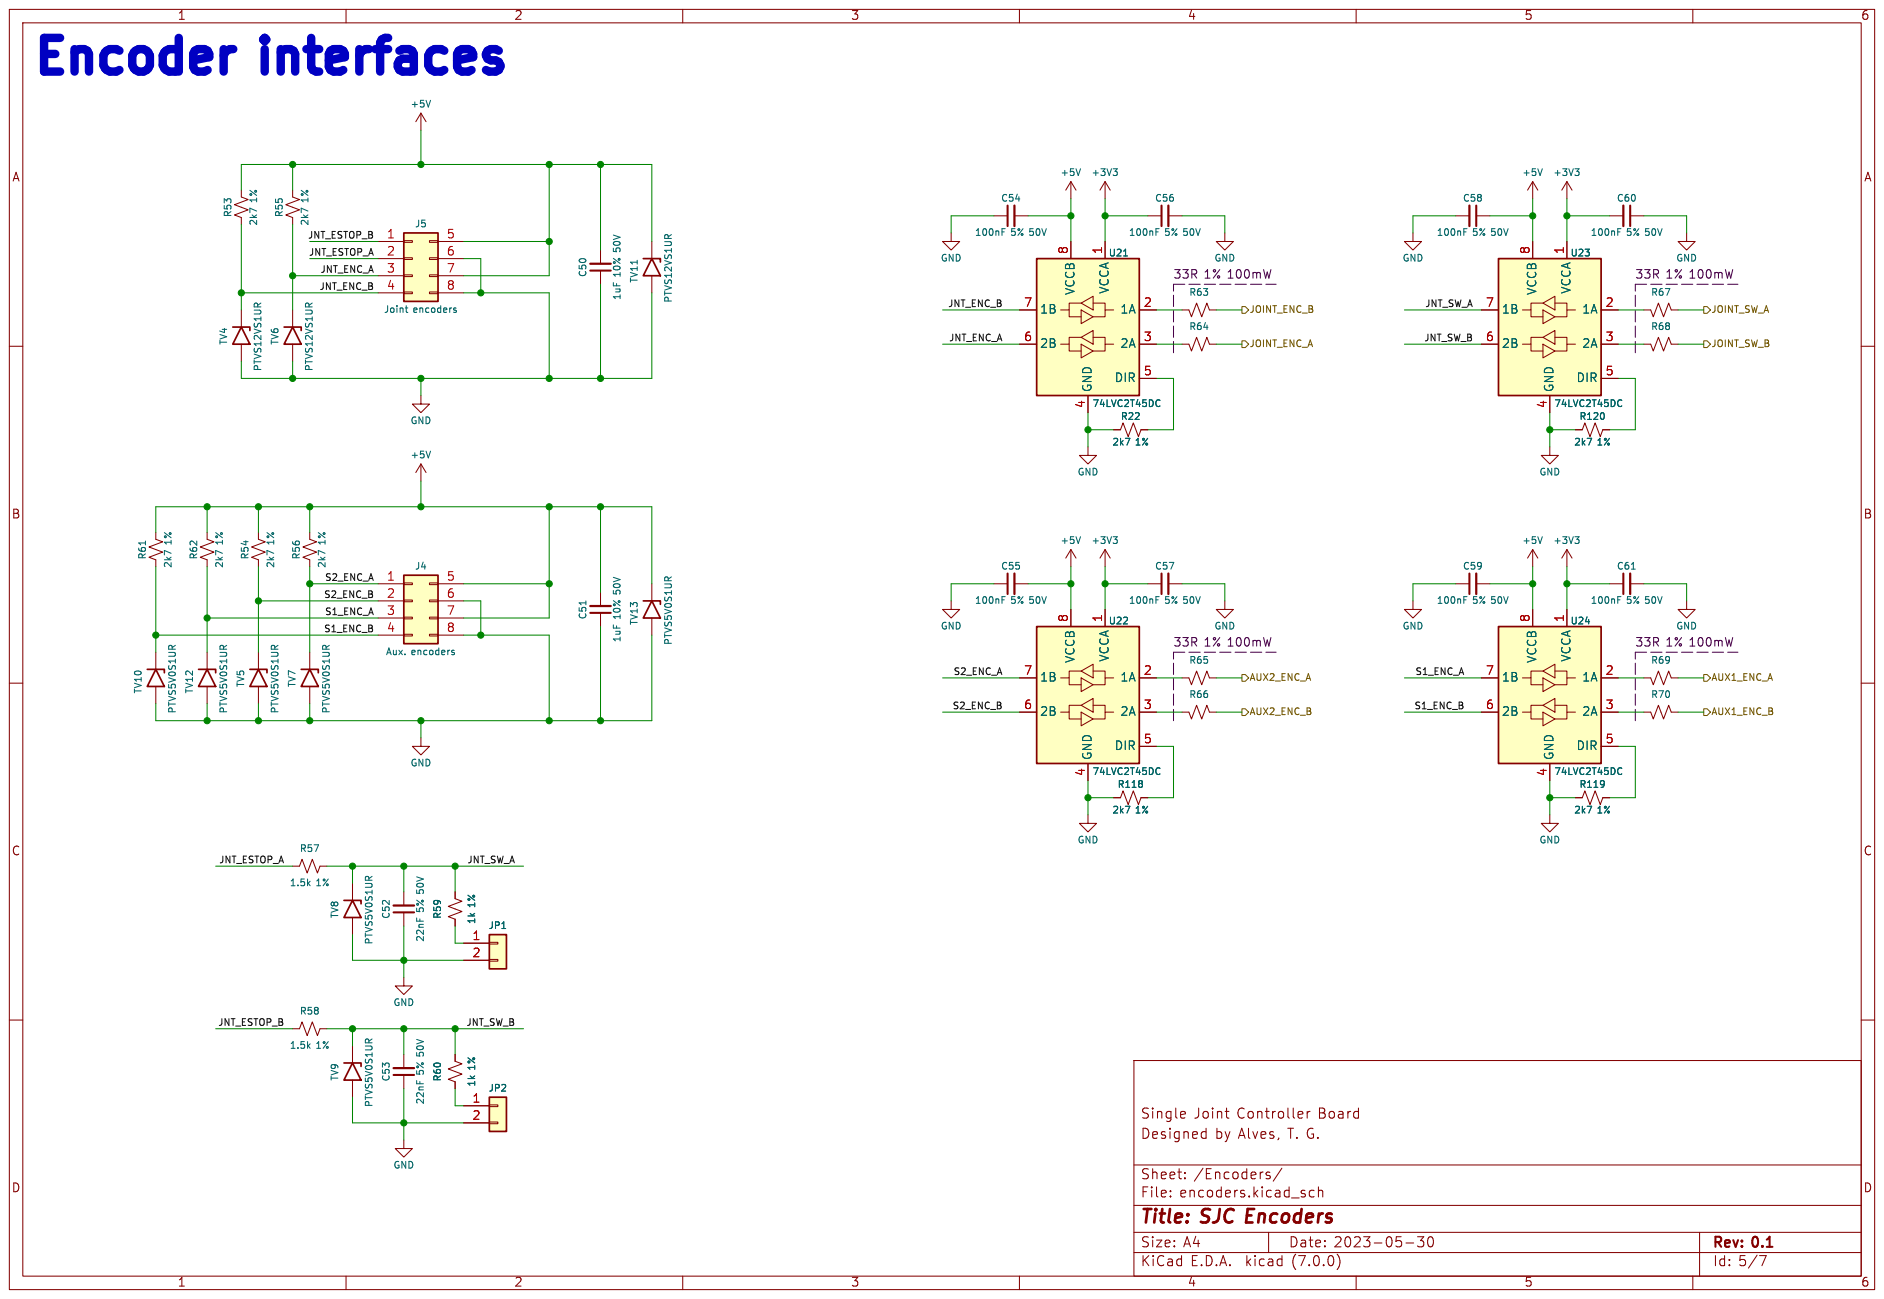
[picture p26: page 5]

Id: 5/7 Title: SJC Encoders

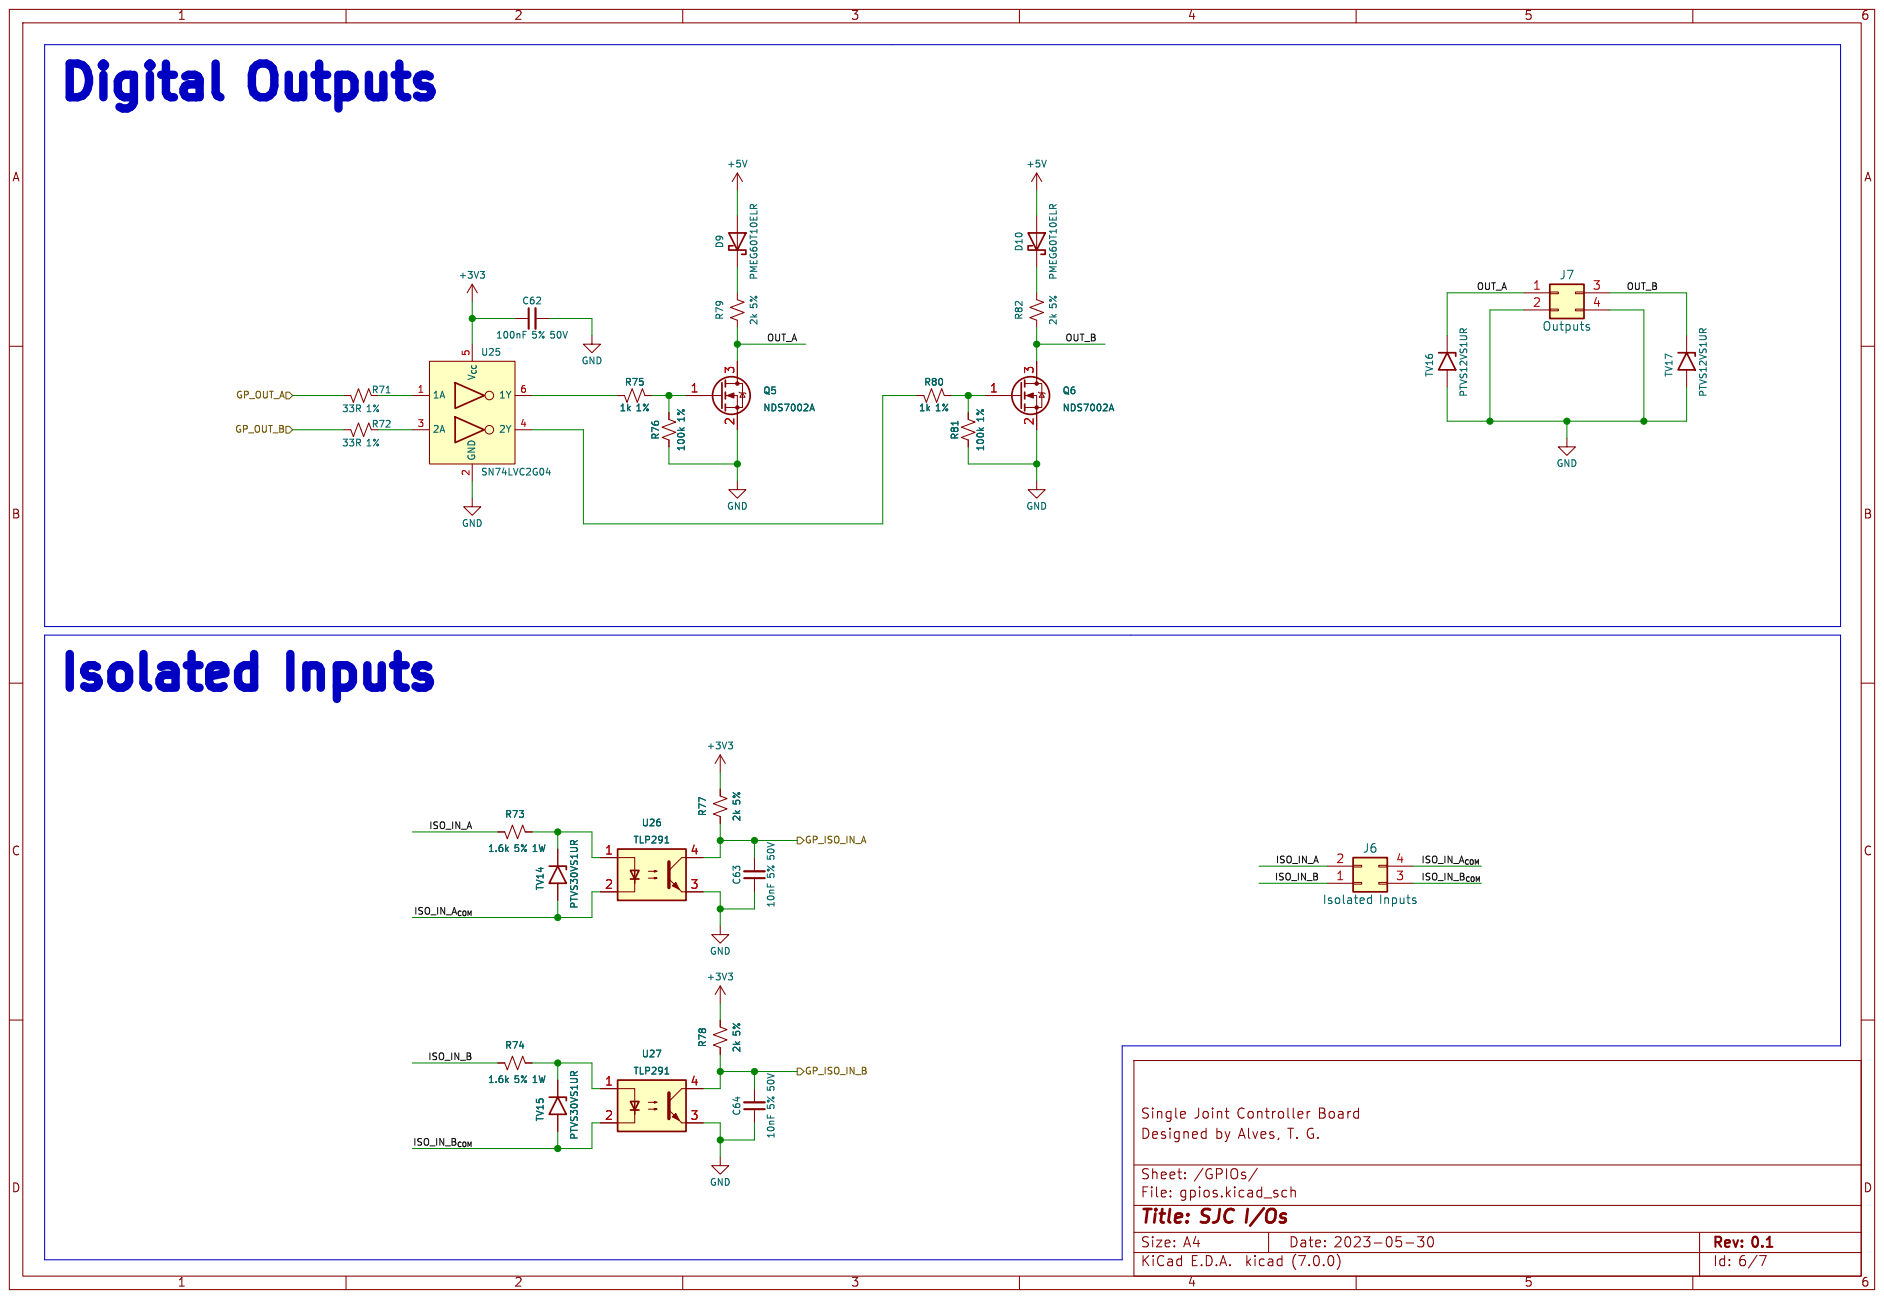
[picture p27: page 6]

Id: 6/7 Title: SJC I/Os

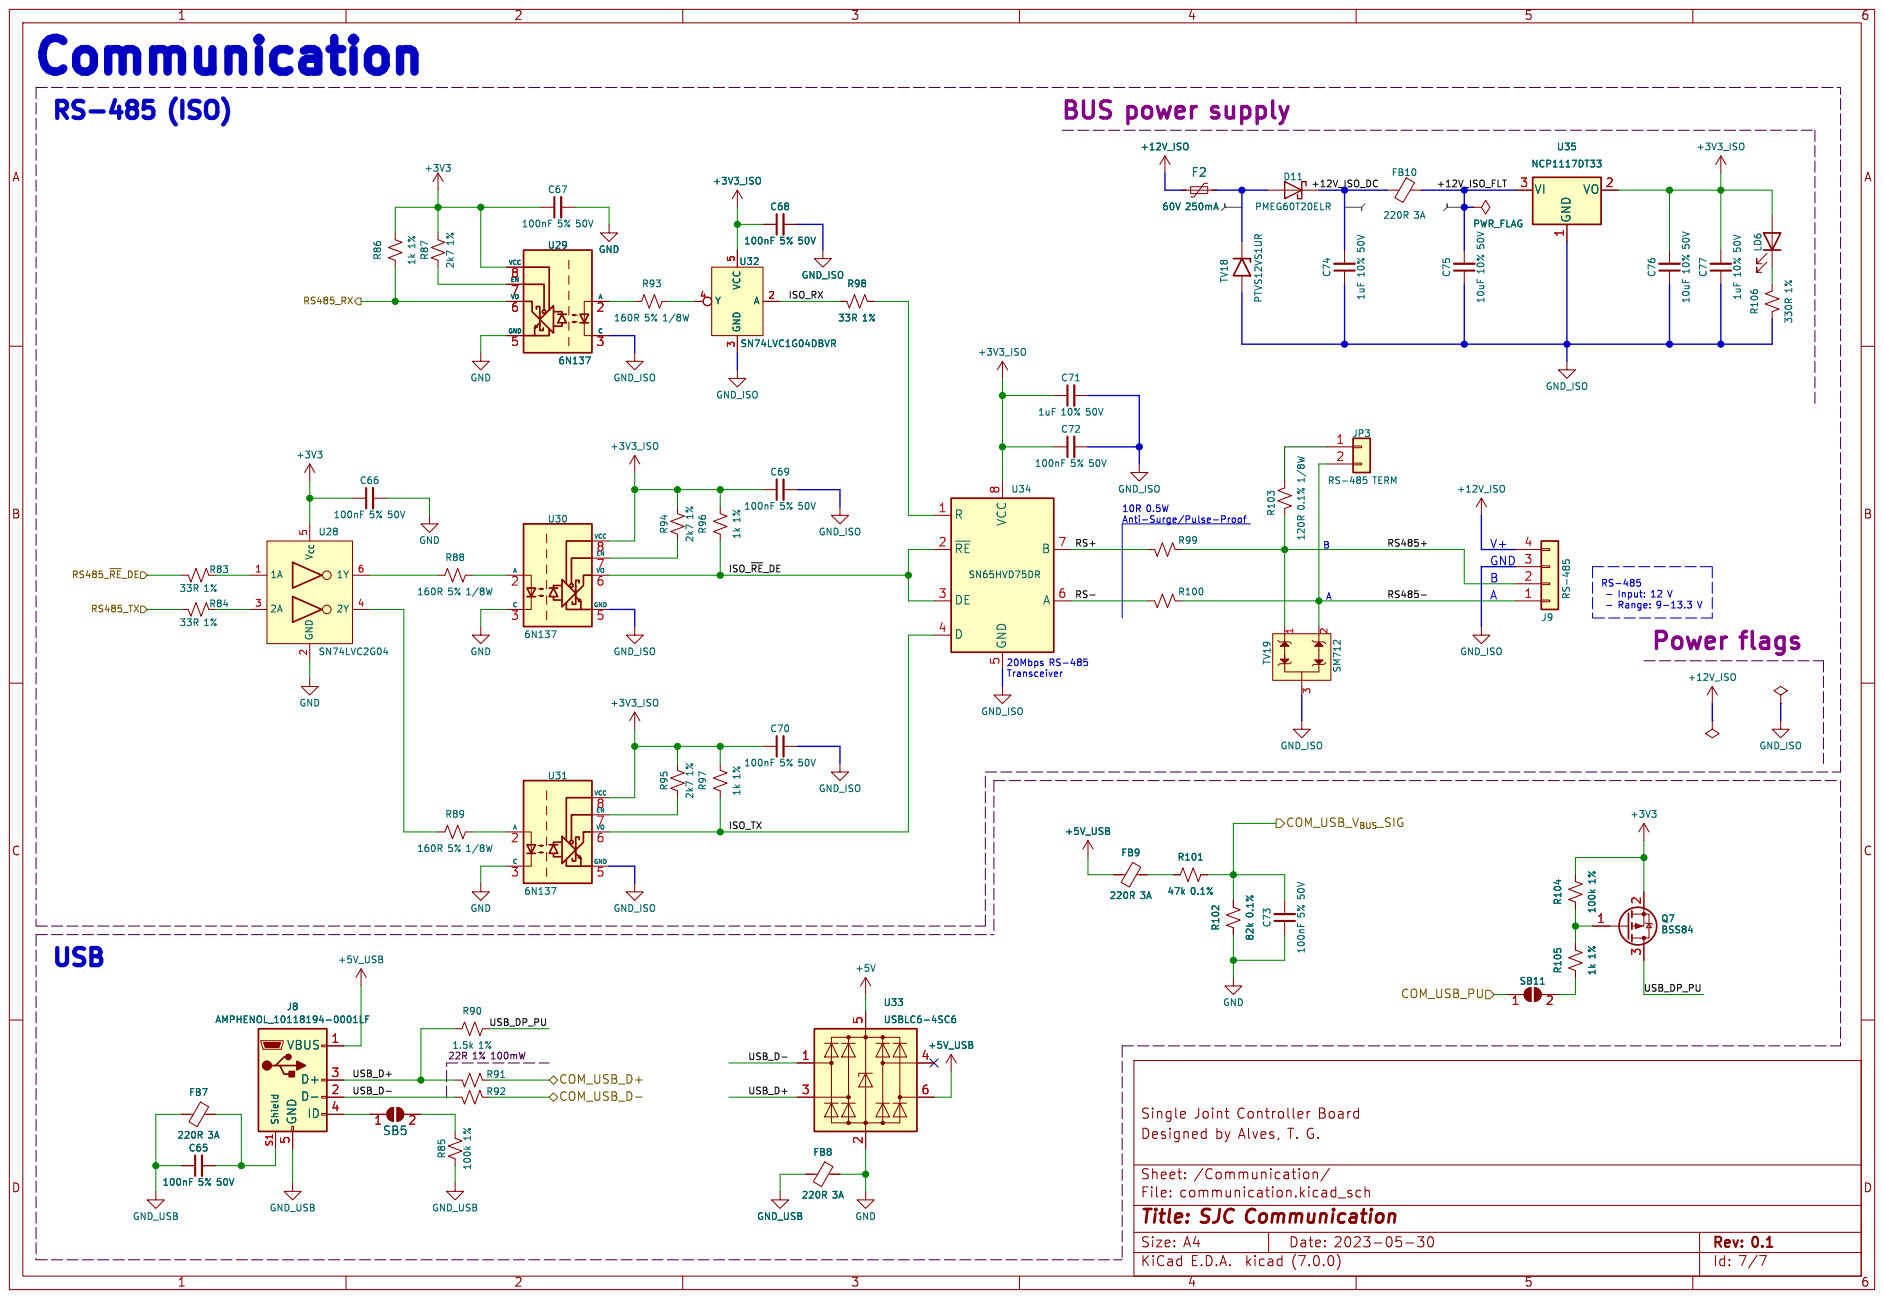
[picture p28: page 7]

Anti-Surge/Pulse-Proof 22R 1% 100mW Communication

Id: 7/7 Title: SJC Communication
