parkourlrc/pcb-tgiacomellibr--sjc-6abed6a295/hardware/sim/servo_circuit2.asc

A1: inv; Vhigh 5 Vlow 0
C1: cap; 82n; V=50
C2: cap; 82n; V=50
C7: cap; 39n
C8: cap; 39n
C9: cap; 39n
C10: cap; 39n
C11: cap; 200p; V=50
C12: cap; 200p; V=50
D1: schottky; PMEG6010AED
D2: schottky; PMEG6010AED
D3: schottky; PMEG6010AED
D4: schottky; PMEG6010AED
D5: schottky; PMEG6010AED
D6: schottky; PMEG6010AED
L2: ind; 22µ; Rser=4
M1: nmos; BSC0902NSI
M2: nmos; BSC0902NSI
M3: nmos; BSC0902NSI
M4: nmos; BSC0902NSI
R1: res; 1k; tol=1 pwr=0.1
R2: res; 2.4; tol=1 pwr=1
R3: res; 2; tol=5 pwr=2
R4: res; 2.4; tol=1 pwr=1
R5: res; 130; tol=1 pwr=1
R6: res; 130; tol=1 pwr=1
R7: res; 2; tol=5 pwr=2
R8: res; 130; tol=1 pwr=1
R9: res; 2.4; tol=1 pwr=1
R10: res; 2.4; tol=1 pwr=1
R11: res; 130; tol=1 pwr=1
R12: res; 8m
R13: res; 260; tol=0.1 pwr=0.1
R14: res; 1.02k; tol=0.1 pwr=0.1
R16: res; 55.6; tol=0.1 pwr=1
R17: res; 55.6; tol=0.1 pwr=1
R18: res; 55.6; tol=0.1 pwr=1
R19: res; 55.6; tol=0.1 pwr=1
R20: res; 100k; tol=1 pwr=0.1
R21: res; 100k; tol=1 pwr=0.1
R22: res; 100k; tol=1 pwr=0.1
R23: res; 100k; tol=1 pwr=0.1
R24: res; 1.02k; tol=0.1 pwr=0.1
R25: res; 1.02k; tol=0.1 pwr=0.1
R30: res; 1.02k; tol=0.1 pwr=0.1
R31: res; 1.02k; tol=0.1 pwr=0.1
R32: res; 1.02k; tol=0.1 pwr=0.1
R33: res; 100; tol=1 pwr=0.1
R34: res; 100; tol=1 pwr=0.1
U1: ADG772
U2: IR2104
U3: IR2104
U4: AD8418A
U7: AD8628
U8: AD8628
U9: AD8628
V2: voltage; 24; Rser=0.5
V5: voltage; 15; Rser=0.5
V6: signal; PULSE(0 5 0 100n 100n 35u 50u)
V7: signal; PULSE(0 5 0 100n 100n 15u 50u)
V11: signal; PULSE(0 5 0 100n 100n 1000u 2000u)
V15: voltage; 3.3; Rser=1
V18: voltage; 5; Rser=1
Named nets: PWM, 0, PWM1, PWM2, CTRL, VCC, V+, V-, V5, I_meas, V33, VDD, vb+, vb-, Vi_flt_out2, Vi_flt_mid2
.tran 0 1000u 10us 10us startup
Current sense circuit
Filter circuit
