parkourlrc/pcb-tgiacomellibr--sjc-6abed6a295/hardware_v2/hardware_v2.kicad_pcb

## KiCad design hardware_v2/hardware_v2.kicad_pcb (2025-11-01)

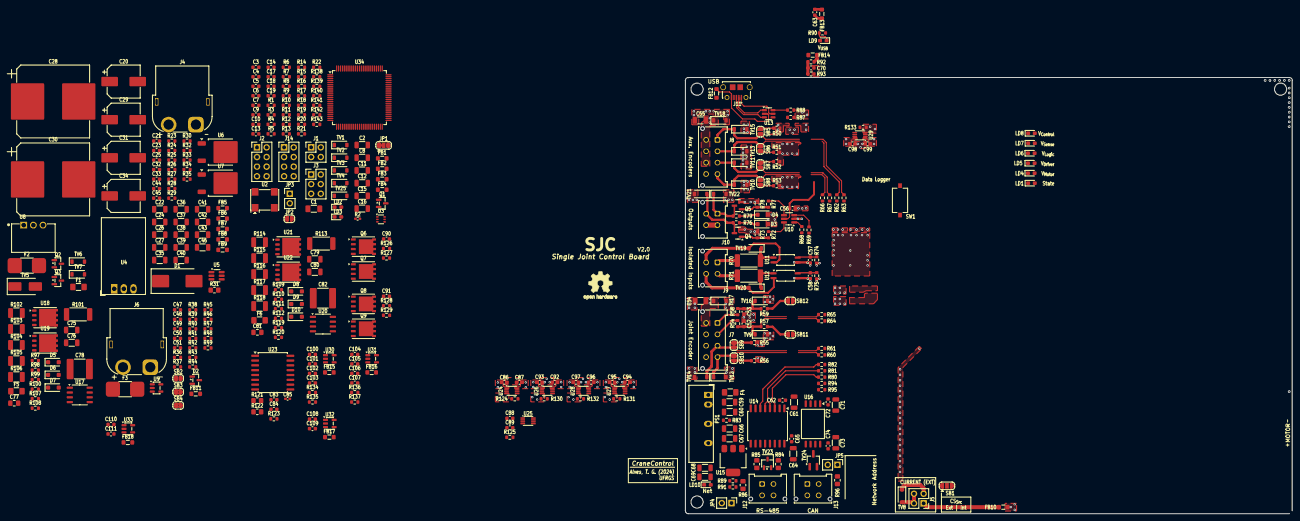
[picture p29: board hardware_v2.kicad_pcb from above]

Board: 4 copper layers, 160.0 x 115.0 mm, 403 parts (0 on the bottom side), 212 nets.

Parts:
C1: 4.7uF 10% 50V; C_1206_3216Metric_Pad1.33x1.80mm_HandSolder
C2, C8, C11, C12, C38, C39, C54, C55, C67, C68, C76, C80: 1uF 10% 50V; C_1206_3216Metric
C3, C5, C6, C7, C9, C10, C13, C14, C17, C18, C19, C25, C32, C33, C44, C45, C48, C49, C50, C56, C62, C63, C65, C72, C74, C83, C86, C87, C88, C89, C92, C93, C94, C95, C96, C97, C98, C99, C100, C101, C102, C104, C105, C106, C108, C110: 100nF 5% 50V; C_0603_1608Metric
C4, C21, C23, C51, C57, C58, C70, C84, C90, C91, C103, C107, C109, C111: 10nF 5% 50V; C_0603_1608Metric
C15, C16: 2.2uF 10% 50V; C_1206_3216Metric
C20, C34: 47uF 63V 20%; CP_Elec_8x10.5
C22, C24, C26, C27, C35, C36, C40, C41, C42, C46, C60, C61, C64, C66, C69, C71, C73, C75, C79: 10uF 10% 50V; C_1206_3216Metric
C28, C30: 680uF 63V 20%; CP_Elec_18x17.5
C29, C31: 100uF 63V 20%; CP_Elec_8x10.5
C37, C43, C59: 22uF 10% 25V; C_1206_3216Metric
C47: 1.5nF 5% 50V; C_0603_1608Metric
C52, C53: 22nF 5% 50V; C_0603_1608Metric
C77, C81: 100nF 5% 50V; C_0805_2012Metric_Pad1.18x1.45mm_HandSolder
C78, C82: 22uF 20% 50V; C_2220_5750Metric
C85: 220pF 5% 50V; C_0402_1005Metric_Pad0.74x0.62mm_HandSolder
D1: B560C; D_SMC_Handsoldering
D2: BAT54S; SOT-23
D3, D4, D5, D6, D7, D8, D9, D10: PMEG60T30ELR; D_SOD-123F
F1, F5, F6: 30V 1100mA; Fuse_1206_3216Metric_Pad1.42x1.75mm_HandSolder
F2, F3: 40A 63V; Fuse_2410_6125Metric_CB61F
F4: 13.2V 500mA; Fuse_1206_3216Metric_Pad1.42x1.75mm_HandSolder
FB1, FB2, FB3, FB4, FB5, FB6, FB7, FB8, FB9, FB10, FB11, FB12, FB13, FB14, FB15, FB16, FB17, FB18: 220R 3A; L_0805_2012Metric_Pad1.05x1.20mm_HandSolder
H1, H2, H3, H4: MountingHole; MountingHole_3.2mm_M3_ISO7380
J1: Aux Usart; PinHeader_2x02_P2.54mm_Vertical
J2: PROG_{DBG}; PinHeader_2x04_P2.54mm_Vertical
J3: NET ADDRESS; PinHeader_2x03_P2.54mm_Vertical
J4: V_{POWER}; AMASS_XT60PW-F_1x02_P7.20mm_Horizontal
J5: EXT-CS; PinHeader_2x02_P2.54mm_Vertical
J6: Motor; AMASS_XT60PW-F_1x02_P7.20mm_Horizontal
J7: Joint encoders; Molex_Micro-Fit_3.0_43045-0812_2x04_P3.00mm_Vertical
J8: Aux. encoders; Molex_Micro-Fit_3.0_43045-0812_2x04_P3.00mm_Vertical
J9: Isolated Inputs; Molex_Micro-Fit_3.0_43045-0412_2x02_P3.00mm_Vertical
J10: Outputs; Molex_Micro-Fit_3.0_43045-0412_2x02_P3.00mm_Vertical
J11: AMPHENOL_10118194-0001LF
J12, J13: RS-485; Molex_Micro-Fit_3.0_43045-0412_2x02_P3.00mm_Vertical
J14: SPI; PinHeader_2x04_P2.54mm_Vertical
JP1: CS_AD_SEL; SolderJumper-3_P1.3mm_Bridged12_RoundedPad1.0x1.5mm
JP2: CS_AD_SEL; SolderJumper-2_P1.3mm_Open_RoundedPad1.0x1.5mm
JP3: Boot; PinHeader_1x02_P2.54mm_Vertical
JP4, JP5: RS-485 TERM; PinHeader_1x02_P2.54mm_Vertical
LD1, LD2, LD3, LD4, LD5, LD6, LD7, LD8, LD9, LD10: 1.8V @ 5mA; LED_0603_1608Metric_Pad1.05x0.95mm_HandSolder
PS1: IB0512LS-1WR3; IB_LS-1WR3
Q1: BC817; SOT-23
Q2, Q3, Q4, Q5: NDS7002A; SOT-23
Q6, Q7, Q8, Q9: SI7149ADP; PowerPAK_SO-8_Single
R1, R27, R28, R49, R57, R59, R72, R77, R98, R110: 1k 1%; R_0603_1608Metric
R2: 47R 1%; R_0402_1005Metric_Pad0.72x0.64mm_HandSolder
R3, R14, R15, R16, R17, R23, R26, R36, R43, R89, R123: 10k 1%; R_0603_1608Metric
R4, R21, R22, R35: 330R 1%; R_0603_1608Metric
R5, R6, R8, R9, R10, R11, R12, R13, R18, R19, R20, R44, R45, R46, R47, R60, R61, R62, R63, R64, R65, R66, R67, R68, R69, R80, R81, R82, R94, R95, R97, R109, R138, R139, R140, R141, R142, R143: 33R 1%; R_0603_1608Metric
R7, R24, R25, R29, R30, R41, R73, R78, R83, R99, R100, R107, R108, R111, R112, R119, R120, R124, R125, R127, R129, R130, R131, R132, R133: 100k 1%; R_0603_1608Metric
R31: 5.62k 5% 250mW; R_0805_2012Metric_Pad1.20x1.40mm_HandSolder
R32, R33, R74, R75, R76, R79: 2k 5%; R_0603_1608Metric
R34, R90, R91: 680R 1%; R_0603_1608Metric
R37, R38: 1.1k 0.1%; R_0603_1608Metric
R39: 560R 0.1%; R_0603_1608Metric
R40, R42, R48, R134, R135, R136, R137: 1.58k 0.1%; R_0603_1608Metric
R50, R51, R52, R53, R55, R56: 2k7 1%; R_0603_1608Metric
R54, R58: 1.5k 1%; R_0603_1608Metric
R70, R71: 1.6k 5% 1W; R_2512_6332Metric_Pad1.40x3.35mm_HandSolder
R84, R85: 10R 5% 1/2W; R_0805_2012Metric_Pad1.20x1.40mm_HandSolder
R86, R96: 120R 0.1% 1/8W; R_0805_2012Metric_Pad1.20x1.40mm_HandSolder
R87, R88: 22R 1%; R_0603_1608Metric
R92: 33k 0.1%; R_0603_1608Metric
R93, R126, R128: 82k 0.1%; R_0603_1608Metric
R101, R113: 2R 5% 2W; R_2512_6332Metric_Pad1.40x3.35mm_HandSolder
R102, R105, R114, R117: 10R 1% 500mW; R_1210_3225Metric_Pad1.30x2.65mm_HandSolder
R103, R106, R115, R118: 62R 1% 500mW; R_1210_3225Metric_Pad1.30x2.65mm_HandSolder
R104, R116: 0R 1% 500mW; R_1210_3225Metric_Pad1.30x2.65mm_HandSolder
R121: 8k2 1% 1/8W; R_0805_2012Metric_Pad1.20x1.40mm_HandSolder
R122: 1k5 1% 1/8W; R_0805_2012Metric_Pad1.20x1.40mm_HandSolder
SB1: CS_SEL; SolderJumper-3_P1.3mm_Open_RoundedPad1.0x1.5mm
SB2, SB5, SB6, SB7, SB8, SB9, SB10, SB11, SB12: SolderJumper-2_P1.3mm_Open_RoundedPad1.0x1.5mm
SB3, SB4: SolderJumper-2_P1.3mm_Bridged2Bar_RoundedPad1.0x1.5mm
SW1: Tactile Switch; SW_Tactile_SPST_NO_Straight_CK_PTS636Sx25SMTRLFS
SYM1: Logo_Open_Hardware_Small; OSHW-Logo2_9.8x8mm_SilkScreen
TV1, TV2, TV3, TV4, TV7, TV25: PTVS3V3S1UR; D_SOD-123
TV5: SMBJ30A; D_SMB_Handsoldering
TV6, TV8, TV9, TV10, TV11, TV13, TV15, TV16, TV18: PTVS5V0S1UR; D_SOD-123
TV12, TV14, TV17, TV21, TV22: PTVS12VS1UR; D_SOD-123
TV19, TV20: PTVS30VS1UR; D_SOD-123
TV23: SM712; SOT-23-3
TV24: PESD2CANFD24L; SOT-23W_Handsoldering
U2: YSO110TR-16MHz; Oscillator_SMD_YXC_YSO110TR_7050-4Pin_7.0x5.0mm
U3: 74LVC2G17GW; SOT-363_SC-70-6
U4: R-78K12-2.0L; Converter_DCDC_RECOM_R-78K-2.0L_THT
U5, U10: SN74LVC2G04; SOT-23-6_Handsoldering
U6: NCP1117DT50; TO-252-2
U7: NCP1117DT33; TO-252-2
U8: VXO78012-1000; CONV_VXO78012-1000
U9, U30, U31, U32, U33: TLV9051; SOT-23-5
U11, U12: TLP291; SOP-4_4.4x2.6mm_P1.27mm
U13: USBLC6-4SC6; SOT-23-6
U14: ISO1430B; SOIC-16W_7.5x10.3mm_P1.27mm
U15: LD1117S50TR; SOT-223-3_TabPin2
U16: ISO1042; SOIC-8_7.5x5.85mm_P1.27mm
U17, U20: 2ED2184S06F; Infineon_PG-DSO-8-24_4x5mm
U18, U19, U21, U22: IAUC100N04S6N028; Infineon_PG-TDSON-8_6.15x5.15mm
U23: ACS733KLATR-40AB; SOIC-16W_7.5x10.3mm_P1.27mm
U24, U25, U26, U27, U28, U29: 74LVC2T45DC; VSSOP-8_2.3x2mm_P0.5mm
U34: STM32H750VBTx; LQFP-100_14x14mm_P0.5mm

Connections:
+3V3: C1.2, C2.2, C3.2, C5.2, C7.2, C9.2, C10.2, C11.2, C13.2, C19.1, C25.1, C42.2, C45.2, C56.1, C61.2, C62.1, C71.2, C72.1, C86.2, C88.2, C93.1, C95.1, C97.1, C99.1, D2.2, FB1.1, FB3.2, FB11.2, FB15.2, FB16.2, FB17.2, FB18.2, J1.3, J2.2, J3.1, J3.3, J3.5, J14.5, JP3.1, LD1.2 (A), LD8.2 (A), R24.2, R25.2, R74.2, R75.2, R124.2, R125.2, TV1.1 (K), TV2.1 (K), TV7.1 (K), TV25.1 (K), U3.5 (VCC), U5.5 (V_{CC}), U7.2 (VO), U10.5 (V_{CC}), U14.1 (VCC1), U16.1 (VCC1), U24.1 (VCCA), U25.1 (VCCA), U26.1 (VCCA), U27.1 (VCCA), U28.1 (VCCA), U29.1 (VCCA), U34.6 (VBAT), U34.11 (VDD), U34.27 (VDD), U34.50 (VDD), U34.75 (VDD), U34.100 (VDD)
+3V3A: C4.2, C6.2, C8.2, FB1.2, R2.2, U34.21 (VDDA)
+3V3_OSC: C18.1, FB3.1, R17.2, U2.4 (V_{DD})
+3V3_SENSE: C83.1, C84.1, R121.1, R123.2, U23.15 (VCC), U23.16 (VCC)
+5V: C41.2, C44.2, C54.2, C55.2, C87.1, C89.1, C92.2, C94.2, C96.2, C98.2, D3.2 (A), D4.2 (A), F4.2, FB10.1, J7.5, J7.7, J8.5, J8.7, LD7.2 (A), R50.1, R51.1, R52.1, R53.1, R55.2, R56.2, TV6.1 (K), TV17.1 (K), TV18.1 (K), U6.2 (VO), U24.8 (VCCB), U25.8 (VCCB), U26.8 (VCCB), U27.8 (VCCB), U28.8 (VCCB), U29.8 (VCCB)
+5V_ISO: C64.1, C65.1, C68.2, C69.2, C73.1, C74.1, R89.2, R91.1, U14.16 (VCC2), U15.2 (VO), U16.8 (VCC2)
+5V_USB: FB14.2, J11.1 (VBUS), LD9.2 (A), U13.5 (VBUS)
+12V: C32.2, C33.2, C43.2, C46.2, FB6.2, FB8.1, LD6.2 (A), U8.3 (+V_{OUT})
/Communication/485_XCVR_DE: R81.1, U14.4 (~RE), U14.5 (DE)
/Communication/485_XCVR_DI: R82.1, U14.6 (D)
/Communication/485_XCVR_RO: R80.2, U14.3 (R)
/Communication/+12V_ISO_DC: C66.2, C67.2, PS1.6 (+Vout), R83.2, U15.3 (VI)
/Communication/CAN_XCVR_RX: R94.2, U16.3 (RXD)
/Communication/CAN_XCVR_TX: R95.1, U16.2 (TXD)
/Communication/CAN_{H}: J13.2, R96.1, TV24.2 (K2), U16.7 (CANH)
/Communication/CAN_{L}: J13.1, JP5.2, TV24.1 (K1), U16.6 (CANL)
/Communication/COM_USB_V_{BUS}_SIG: C70.2, R92.2, R93.2
/Communication/RS_485_{A}: J12.1, R85.1, R86.1, TV23.1
/Communication/RS_485_{B}: J12.2, JP4.1, R84.1, TV23.2
/Communication/RS_{A}: R85.2, U14.12 (A)
/Communication/RS_{B}: R84.2, U14.13 (B)
/Communication/USB_D+: J11.3 (D+), R87.2, U13.3 (I/O2), U13.4 (I/O3)
/Communication/USB_D-: J11.2 (D-), R88.2, U13.1 (I/O1), U13.6 (I/O4)
/Control/BOOT: JP3.2, R7.2
/Control/CURRENT_SIGNAL_FILT: JP1.2 (C), R40.2, SB4.2 (B)
/Control/DBG_USART_TX: J2.5, R12.2
/Control/GP_ISO_IN_A: C57.2, R74.1, U11.4
/Control/GP_ISO_IN_B: C58.2, R75.1, U12.4
/Control/JTCK/SWCLK: J2.7, R11.2
/Control/JTDI: J2.6, R9.2
/Control/JTDO/TRACESWO: J2.4, R8.2
/Control/JTMS/SWDIO: J2.8, R10.2
/Control/MOTOR_INPUT_VOLTAGE_SIG: R49.2, U33.1, U33.4 (-)
/Control/MotorDriver_{EN}: C21.2, R24.1, U5.1 (1A)
/Control/MotorPSU_{EN}: C23.2, R25.1, U5.3 (2A)
/Control/NET_ADDR_A: J3.2, R14.1
/Control/NET_ADDR_B: J3.4, R15.1
/Control/NET_ADDR_C: J3.6, R16.1
/Control/NJTRST: J2.3, R13.2
/Control/NRST: C17.2, SW1.2
/Control/R_MOT_HI_{PWM}: JP2.1 (A), R46.2
/Control/SPI_CSEL_{PIN}: J14.6, R142.1
/Control/SPI_INT_{PIN}: J14.8, R143.1
/Control/SPI_MISO_{PIN}: J14.2, R140.1
/Control/SPI_MOSI_{PIN}: J14.1, R139.1
/Control/SPI_RST_{PIN}: J14.4, R141.1
/Control/SPI_SCK_{PIN}: J14.7, R138.1
/Control/X_{OSC}: R18.2, U2.3 (OUT)
/Encoders/Aux encoder A level shifter/OUT_{A}: R62.2, U28.2 (1A)
/Encoders/Aux encoder A level shifter/OUT_{B}: R63.2, U28.3 (2A)
/Encoders/Aux encoder B level shifter/OUT_{A}: R66.2, U29.2 (1A)
/Encoders/Aux encoder B level shifter/OUT_{B}: R67.2, U29.3 (2A)
/Encoders/JNT_ENC_A: J7.3, SB9.1 (A), TV14.1 (K), U26.6 (2B)
/Encoders/JNT_ENC_B: J7.4, SB10.1 (A), TV12.1 (K), U26.7 (1B)
/Encoders/JNT_ESTOP_A: J7.2, R54.1
/Encoders/JNT_ESTOP_B: J7.1, R58.1
/Encoders/JNT_SW_A: C52.2, R54.2, R57.1, TV9.1 (K), U27.7 (1B)
/Encoders/JNT_SW_B: C53.2, R58.2, R59.1, TV16.1 (K), U27.6 (2B)
/Encoders/Joint encoder level shifter/OUT_{A}: R60.2, U26.2 (1A)
/Encoders/Joint encoder level shifter/OUT_{B}: R61.2, U26.3 (2A)
/Encoders/Joint switch level shifter/OUT_{A}: R64.2, U27.2 (1A)
/Encoders/Joint switch level shifter/OUT_{B}: R65.2, U27.3 (2A)
/Encoders/S1_ENC_A: J8.4, SB8.1 (A), TV10.1 (K), U29.7 (1B)
/Encoders/S1_ENC_B: J8.3, SB7.1 (A), TV11.1 (K), U29.6 (2B)
/Encoders/S2_ENC_A: J8.2, SB6.1 (A), TV13.1 (K), U28.7 (1B)
/Encoders/S2_ENC_B: J8.1, SB5.1 (A), TV15.1 (K), U28.6 (2B)
/GPIOs/ISO_IN_A: J9.1, R70.2
/GPIOs/ISO_IN_A_{COM}: J9.3, TV19.2 (A), U11.2
/GPIOs/ISO_IN_B: J9.2, R71.2
/GPIOs/ISO_IN_B_{COM}: J9.4, TV20.2 (A), U12.2
/GPIOs/OUT_A: J10.3, Q4.3 (D), R76.1, TV21.1 (K)
/GPIOs/OUT_B: J10.1, Q5.3 (D), R79.1, TV22.1 (K)
/Motor/CS_ACS733: C85.1, SB1.3 (B), U23.12 (VIOUT)
/Motor/CS_EXT: R38.2, R39.1, SB1.1 (A)
/Motor/CS_MEAS_FILT_IN: R134.1, SB3.2 (B)
/Motor/FLT_ACS733: R123.1, U23.13 (~FAULT)
/Motor/INNER+: F3.1, U23.1 (IP+), U23.2 (IP+), U23.3 (IP+), U23.4 (IP+)
/Motor/INNER-: R116.1, R119.1, U21.1 (S), U21.2 (S), U21.3 (S), U22.5 (D), U23.5 (IP-), U23.6 (IP-), U23.7 (IP-), U23.8 (IP-)
/Motor/Input buffer1/In: C47.2, R41.1, R43.2, U33.3 (+)
/Motor/Input buffer/In: R36.2, U32.3 (+)
/Motor/Input buffer/Out: SB3.1 (A), U32.1, U32.4 (-)
/Motor/LP-Filter First stage/Out: C100.1, R136.1, U30.1, U30.4 (-)
/Motor/LP-Filter Second stage/Out: C104.1, SB4.1 (A), U31.1, U31.4 (-)
/Motor/L_EN: R110.2, U24.6 (2B)
/Motor/L_PWM: R109.2, U24.7 (1B)
/Motor/Left half-bridge/BST_VCC: C79.1, C80.1, D8.2 (A), F6.2, U20.5 (VCC)
/Motor/Left half-bridge/HO: D9.1 (K), R115.2, U20.7 (HO)
/Motor/Left half-bridge/HSG: R114.2, R115.1, R119.2, U21.4 (G)
/Motor/Left half-bridge/H_{MID}: D9.2 (A), R114.1
/Motor/Left half-bridge/LO: D10.1 (K), R118.2, U20.4 (LO)
/Motor/Left half-bridge/LSG: R117.2, R118.1, R120.2, U22.4 (G)
/Motor/Left half-bridge/L_{MID}: D10.2 (A), R117.1
/Motor/Left half-bridge/PWM_PD: R109.1, R111.2, U20.1 (IN)
/Motor/Left half-bridge/SD_PD: R110.1, R112.2, U20.2 (~SD)
/Motor/Left half-bridge/VS: C81.1, R116.2, U20.6 (VS)
/Motor/Left motor level shifter/IN_{A}: R44.1, U24.2 (1A)
/Motor/Left motor level shifter/IN_{B}: R45.1, U24.3 (2A)
/Motor/M+: F3.2, J6.1
/Motor/M-: J6.2, R104.1, R107.1, U18.1 (S), U18.2 (S), U18.3 (S), U19.5 (D)
/Motor/R_EN: R98.2, U25.6 (2B)
/Motor/R_PWM: R97.2, U25.7 (1B)
/Motor/Right half-bridge/BST_VCC: C75.1, C76.1, D5.2 (A), F5.2, U17.5 (VCC)
/Motor/Right half-bridge/HO: D6.1 (K), R103.2, U17.7 (HO)
/Motor/Right half-bridge/HSG: R102.2, R103.1, R107.2, U18.4 (G)
/Motor/Right half-bridge/H_{MID}: D6.2 (A), R102.1
/Motor/Right half-bridge/LO: D7.1 (K), R106.2, U17.4 (LO)
/Motor/Right half-bridge/LSG: R105.2, R106.1, R108.2, U19.4 (G)
/Motor/Right half-bridge/L_{MID}: D7.2 (A), R105.1
/Motor/Right half-bridge/PWM_PD: R97.1, R99.2, U17.1 (IN)
/Motor/Right half-bridge/SD_PD: R98.1, R100.2, U17.2 (~SD)
/Motor/Right half-bridge/VS: C77.1, R104.2, U17.6 (VS)
/Motor/Right motor level shifter/IN_{A}: R46.1, U25.2 (1A)
/Motor/Right motor level shifter/IN_{B}: R47.1, U25.3 (2A)
/Power Supply/DRIVER_~EN_{SIG}: Q2.3 (D), R128.1
/Power Supply/MOTOR_~EN_{SIG}: Q3.3 (D), R126.1
DRIVER_IN_{FUSE}: C20.1, C22.2, C24.2, F1.1, R23.2, U4.1 (+V_{in})
DRIVER_VCC: C29.1, C31.1, F5.1, F6.1, FB5.1, LD5.2 (A)
GND: C1.1, C2.1, C3.1, C5.1, C7.1, C9.1, C10.1, C11.1, C13.1, C15.1, C16.1, C17.1, C19.2, C21.1, C23.1, C25.2, C35.1, C36.1, C38.1, C39.1, C41.1, C42.1, C44.1, C45.1, C47.1, C49.1, C50.2, C51.2, C52.1, C53.1, C54.1, C55.1, C56.2, C57.1, C58.1, C59.1, C60.1, C61.1, C62.2, C70.1, C71.1, C72.2, C86.1, C87.2, C88.1, C89.2, C92.1, C93.2, C94.1, C95.2, C96.1, C97.2, C98.1, C99.2, C101.1, C102.2, C103.2, C105.1, C106.2, C107.2, C108.2, C109.2, C110.2, C111.2, D2.1, FB2.1, FB4.2, FB7.1, FB9.1, FB12.1, J1.1, J2.1, J5.2, J5.4, J7.6, J7.8, J8.6, J8.8, J10.2, J10.4, J14.3, LD2.1 (K), LD3.1 (K), PS1.2 (-Vin), Q1.2 (E), Q4.2 (S), Q5.2 (S), R7.1, R14.2, R15.2, R16.2, R34.2, R35.2, R38.1, R40.1, R43.1, R49.1, R73.1, R78.1, R93.1, R130.1, R131.1, R132.1, R133.1, SB2.2 (B), SB11.2 (B), SB12.2 (B), SW1.1, TV1.2 (A), TV2.2 (A), TV3.2 (A), TV4.2 (A), TV6.2 (A), TV7.2 (A), TV8.2 (A), TV9.2 (A), TV10.2 (A), TV11.2 (A), TV12.2 (A), TV13.2 (A), TV14.2 (A), TV15.2 (A), TV16.2 (A), TV17.2 (A), TV18.2 (A), TV21.2 (A), TV22.2 (A), TV25.2 (A), U3.2 (GND), U5.2 (GND), U6.1 (GND), U7.1 (GND), U9.2 (V-), U10.2 (GND), U11.3, U12.3, U14.2 (GND1), U14.8 (GND1), U16.4 (GND1), U24.4 (GND), U25.4 (GND), U26.4 (GND), U27.4 (GND), U28.4 (GND), U29.4 (GND), U30.2 (V-), U31.2 (V-), U32.2 (V-), U33.2 (V-), U34.10 (VSS), U34.26 (VSS), U34.49 (VSS), U34.74 (VSS), U34.99 (VSS)
GNDA: C4.1, C6.1, C8.1, C12.1, C14.1, FB2.2, U34.19 (VSSA)
GND_ISO: C64.2, C65.2, C66.1, C67.1, C68.1, C69.1, C73.2, C74.2, J12.3, J12.4, J13.3, J13.4, LD10.1 (K), PS1.4 (-Vout), R83.1, R89.1, TV23.3, TV24.3 (CC), U14.9 (GND2), U14.15 (GND2), U15.1 (GND), U16.5 (GND2)
GND_OSC: C18.2, FB4.1, U2.2 (GND)
GND_SENSE: C83.2, C84.2, C85.2, R122.2, U23.9 (GND), U23.10 (GND), U23.11 (PROGRAM)
GND_USB: C63.1, FB12.2, FB13.2, J11.5 (GND), R90.2, U13.2 (GND)
unnamed: C48.2, R42.2, R48.1
unnamed: C63.2, FB13.1, J11.S1 (Shield), J11.S2 (Shield), J11.S3 (Shield), J11.S4 (Shield), J11.S5 (Shield), J11.S6 (Shield)
unnamed: C90.2, Q6.1 (S), Q6.2 (S), Q6.3 (S), Q7.1 (S), Q7.2 (S), Q7.3 (S), R127.2
unnamed: C91.2, Q8.1 (S), Q8.2 (S), Q8.3 (S), Q9.1 (S), Q9.2 (S), Q9.3 (S), R129.2
unnamed: C100.2, R134.2, R135.1
unnamed: C104.2, R136.2, R137.1
unnamed: D3.1 (K), R76.2
unnamed: D4.1 (K), R79.2
unnamed: D5.1 (K), R101.2
unnamed: D8.1 (K), R113.2
unnamed: FB14.1, R92.1
unnamed: J1.2, R6.2, TV3.1 (K)
unnamed: J1.4, R5.2, TV4.1 (K)
unnamed: FB10.2, J5.1
unnamed: J5.3, R39.2, TV8.1 (K)
unnamed: JP2.2 (B), R1.2
unnamed: JP4.2, R86.2
unnamed: JP5.1, R96.2
unnamed: LD1.1 (K), R4.1
unnamed: LD2.2 (A), R21.1
unnamed: LD3.2 (A), R22.1
unnamed: LD4.1 (K), R31.1
unnamed: LD5.1 (K), R32.1
unnamed: LD6.1 (K), R33.1
unnamed: LD7.1 (K), R34.1
unnamed: LD8.1 (K), R35.1
unnamed: LD9.1 (K), R90.1
unnamed: LD10.2 (A), R91.2
unnamed: C59.2, C60.2, F4.1, PS1.1 (+Vin)
unnamed: Q1.1 (B), R3.2
unnamed: Q1.3 (C), R4.2
unnamed: Q2.1 (G), R27.1, R29.2
unnamed: Q3.1 (G), R28.1, R30.2
unnamed: Q4.1 (G), R72.1, R73.2
unnamed: Q5.1 (G), R77.1, R78.2
unnamed: C90.1, Q6.4 (G), Q7.4 (G), R126.2, R127.1
unnamed: C91.1, Q8.4 (G), Q9.4 (G), R128.2, R129.1
unnamed: D2.3, R36.1, R37.1, SB1.2 (C)
unnamed: R37.2, SB2.1 (A)
unnamed: R50.2, SB5.2 (B)
unnamed: R51.2, SB6.2 (B)
unnamed: R52.2, SB7.2 (B)
unnamed: R53.2, SB8.2 (B)
unnamed: R55.1, SB9.2 (B)
unnamed: R56.1, SB10.2 (B)
unnamed: R57.2, SB11.1 (A)
unnamed: R59.2, SB12.1 (A)
unnamed: R70.1, TV19.1 (K), U11.1
unnamed: R71.1, TV20.1 (K), U12.1
unnamed: R17.1, U2.1 (En)
unnamed: R19.1, U3.1 (1A)
unnamed: R21.2, U3.6 (1Y)
unnamed: R20.1, U3.3 (2A)
unnamed: R22.2, U3.4 (2Y)
unnamed: C26.2, C27.2, FB5.2, R26.2, U4.3 (+V_{out})
unnamed: R27.2, U5.6 (1Y)
unnamed: R28.2, U5.4 (2Y)
unnamed: C35.2, C38.2, FB6.1, U6.3 (VI)
unnamed: C36.2, C39.2, FB8.2, U7.3 (VI)
unnamed: C49.2, R48.2, U9.3 (+)
unnamed: C48.1, U9.1, U9.4 (-)
unnamed: C50.1, C51.1, FB11.1, U9.5 (V+)
unnamed: R68.1, U10.1 (1A)
unnamed: R72.2, U10.6 (1Y)
unnamed: R69.1, U10.3 (2A)
unnamed: R77.2, U10.4 (2Y)
unnamed: C77.2, R101.1, U17.8 (VB)
unnamed: C81.2, R113.1, U20.8 (VB)
unnamed: R121.2, R122.1, U23.14 (VOC)
unnamed: R124.1, U24.5 (DIR)
unnamed: R125.1, U25.5 (DIR)
unnamed: R130.2, U26.5 (DIR)
unnamed: R131.2, U27.5 (DIR)
unnamed: R132.2, U28.5 (DIR)
unnamed: R133.2, U29.5 (DIR)
unnamed: C101.2, R135.2, U30.3 (+)
unnamed: C102.1, C103.1, FB15.1, U30.5 (V+)
unnamed: C105.2, R137.2, U31.3 (+)
unnamed: C106.1, C107.1, FB16.1, U31.5 (V+)
unnamed: C108.1, C109.1, FB17.1, U32.5 (V+)
unnamed: C110.1, C111.1, FB18.1, U33.5 (V+)
PGND: C20.2, C22.1, C24.1, C26.1, C27.1, C28.2, C29.2, C30.2, C31.2, C32.1, C33.1, C34.2, C37.1, C40.1, C43.1, C46.1, C75.2, C76.2, C78.2, C79.2, C80.2, C82.2, FB7.2, FB9.2, J4.1, Q2.2 (S), Q3.2 (S), R23.1, R26.1, R29.1, R30.1, R31.2, R32.2, R33.2, R99.1, R100.1, R108.1, R111.1, R112.1, R120.1, TV5.2 (A), U4.2 (Gnd), U8.2 (GND), U17.3 (COM), U19.1 (S), U19.2 (S), U19.3 (S), U20.3 (COM), U22.1 (S), U22.2 (S), U22.3 (S)
V_{BPS}+: F1.2, Q9.5 (D)
V_{MOTOR}: C78.1, C82.1, U18.5 (D), U21.5 (D)
V_{PWR}+: F2.1, J4.2
V_{PWR}_Fuse+: D1.2 (A), F2.2, Q6.5 (D), Q8.5 (D), TV5.1 (K)
V_{PWR}_Rect+: C34.1, C37.2, C40.2, D1.1 (K), U8.1 (+V_{IN})
V_{PWR}_Src+: C28.1, C30.1, LD4.2 (A), Q7.5 (D), R41.2
V_{REF}+: C12.2, C14.2, R2.1
