parkourlrc/pcb-tgiacomellibr--sjc-6abed6a295/hardware_v0.2/hardware_v0.2.kicad_pcb

## KiCad design hardware_v0.2/hardware_v0.2.kicad_pcb (2024-04-02, an earlier design)

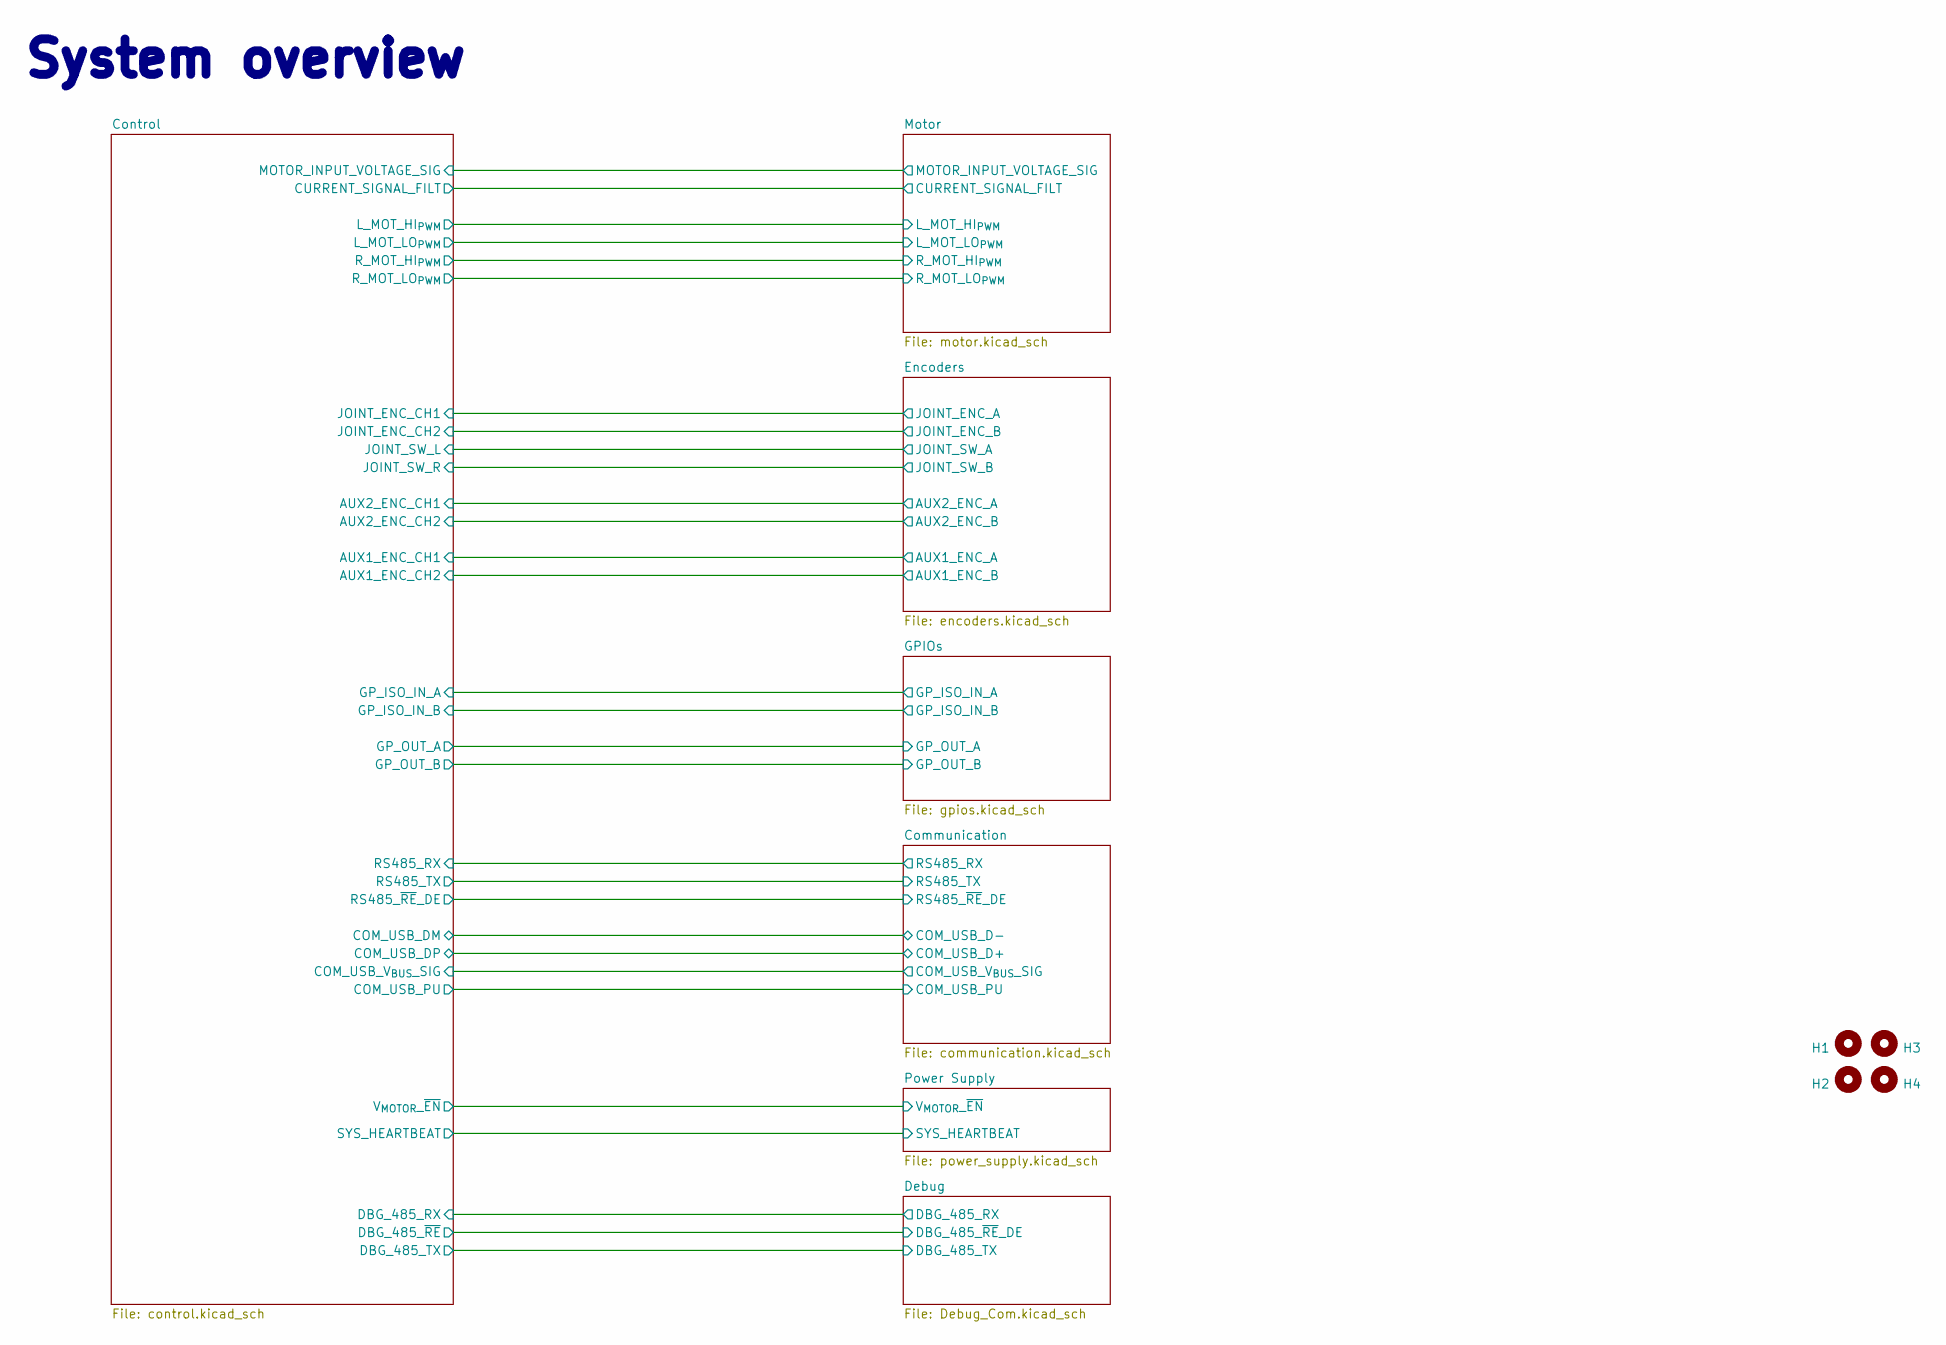
[picture p30: schematic hardware_v0.2.kicad_sch, System overview]

Parts:
H1, H2, H3, H4: MountingHole; MountingHole_3.2mm_M3_ISO7380

Notes on the sheet:
System overview

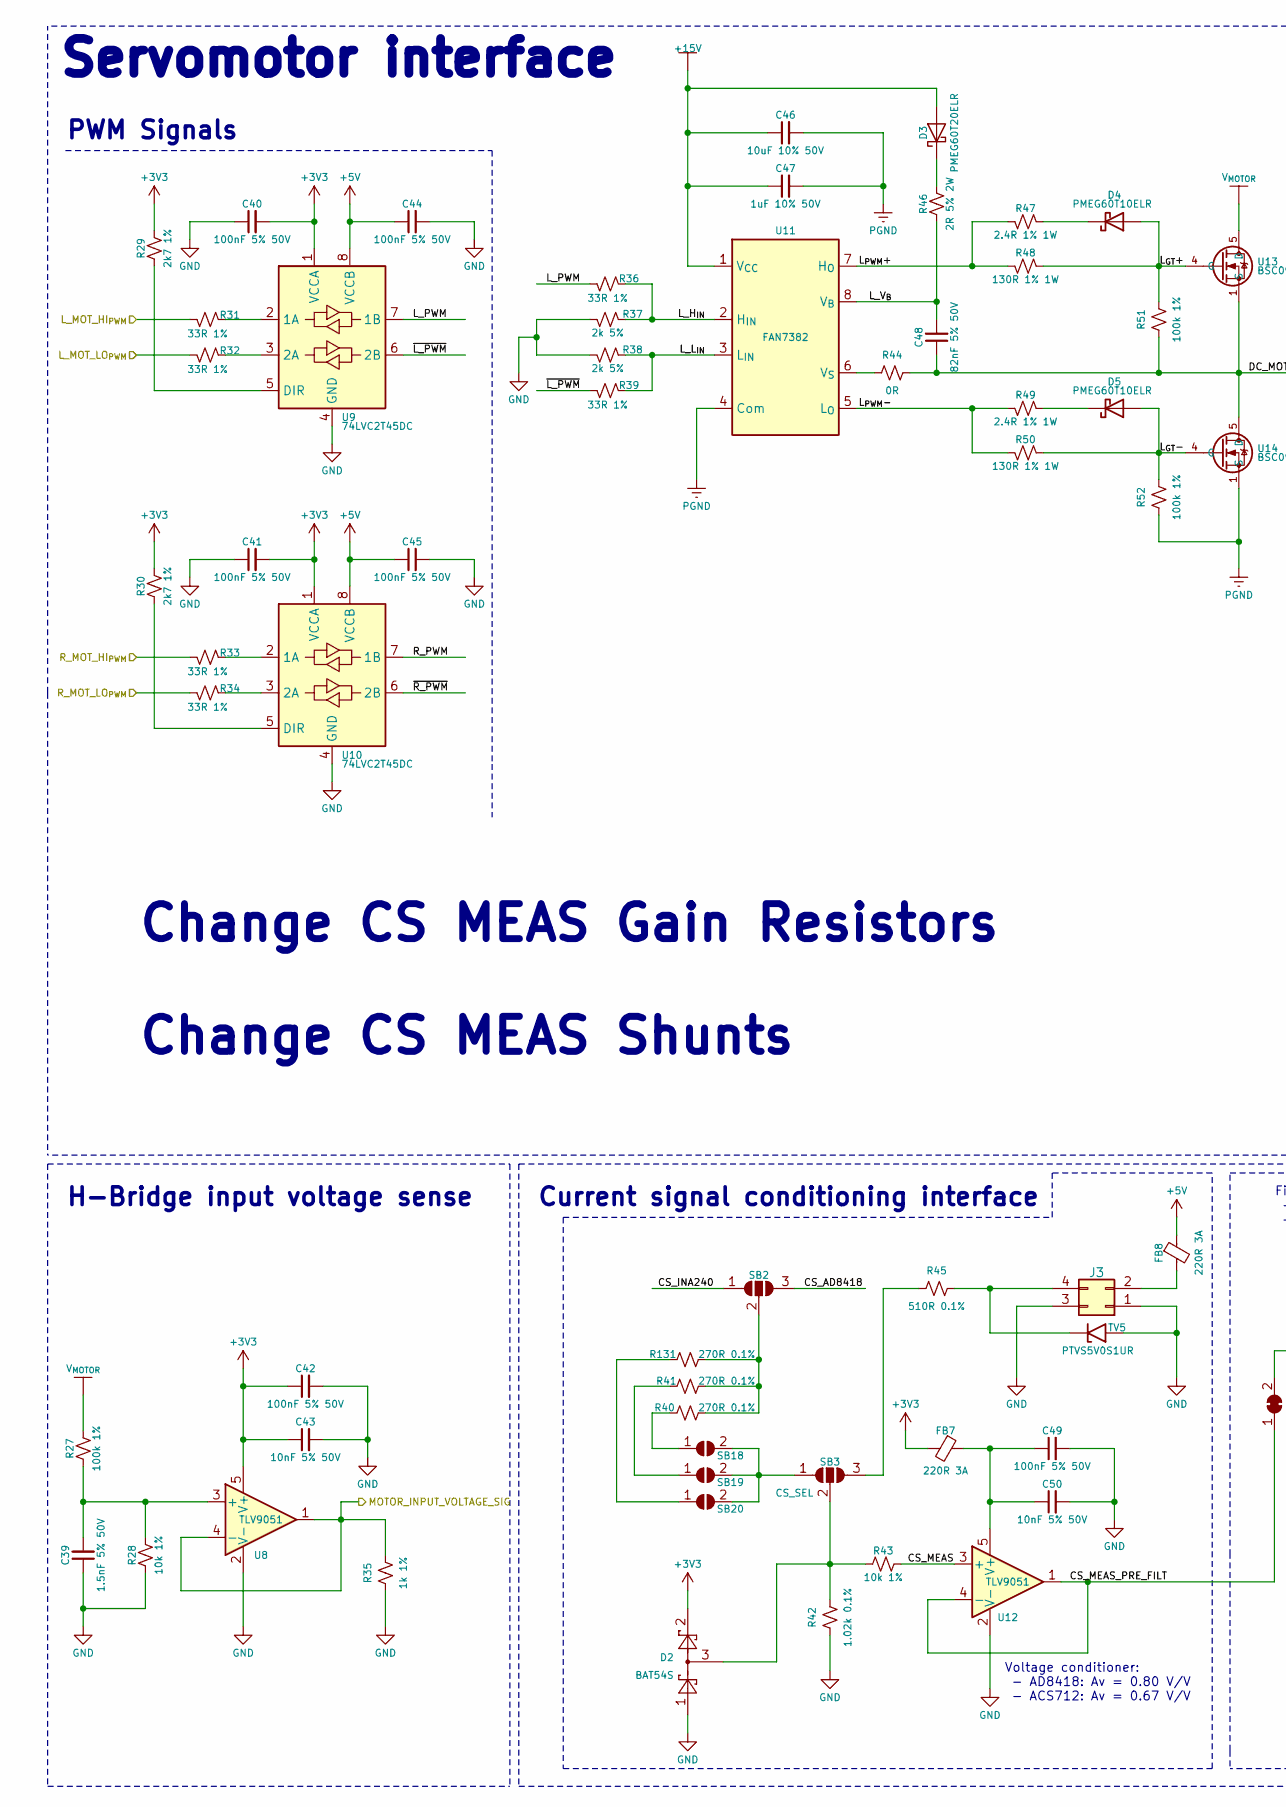
[picture p31: schematic motor.kicad_sch, SJC Servomotor, part in row 1, column 1]

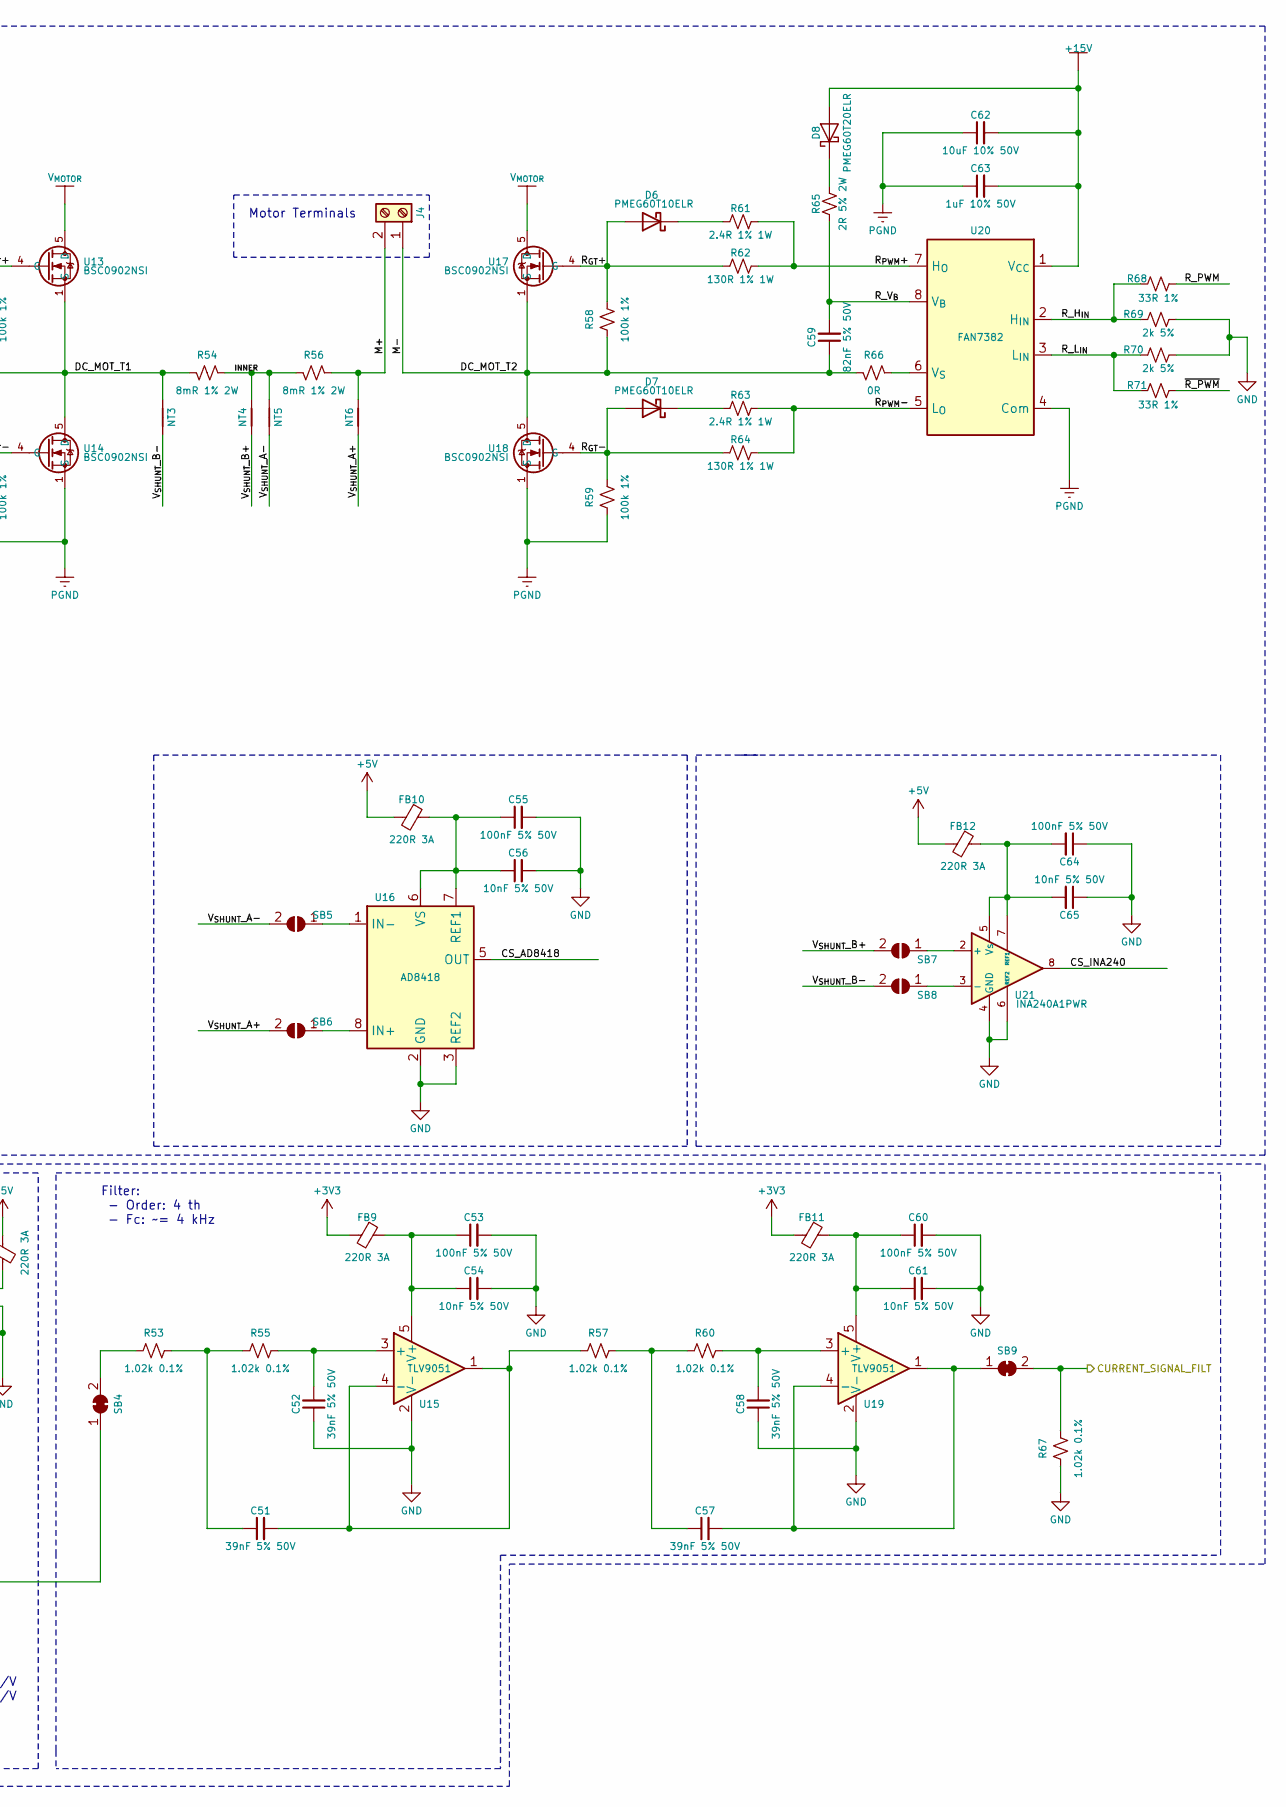
[picture p32: schematic motor.kicad_sch, SJC Servomotor, part in row 1, column 2]

Parts:
C39: 1.5nF 5% 50V; C_0603_1608Metric; JLCPCB Part # C107039
C40, C41, C42, C44, C45, C49, C53, C55, C60, C64: 100nF 5% 50V; C_0603_1608Metric; JLCPCB Part # C91183
C43, C50, C54, C56, C61, C65: 10nF 5% 50V; C_0603_1608Metric; JLCPCB Part # C389113
C46, C62: 10uF 10% 50V; C_1206_3216Metric; JLCPCB Part # C13585
C47, C63: 1uF 10% 50V; C_1206_3216Metric; JLCPCB Part # C1848
C48, C59: 82nF 5% 50V; C_0805_2012Metric_Pad1.18x1.45mm_HandSolder; JLCPCB Part # C520047
C51, C52, C57, C58: 39nF 5% 50V; C_0603_1608Metric; JLCPCB Part # C519553
D2: BAT54S; SOT-23; JLCPCB Part # C19726
D3, D8: PMEG60T20ELR; D_SOD-123F; JLCPCB Part # C552947
D4, D5, D6, D7: PMEG60T10ELR; D_SOD-123F; JLCPCB Part # C552945
FB7, FB8, FB9, FB10, FB11, FB12: 220R 3A; L_0805_2012Metric_Pad1.05x1.20mm_HandSolder; JLCPCB Part # C76818
J3: Debug-485; PinHeader_2x02_P2.54mm_Vertical
J4: Motor; AMASS_XT60PW-M_1x02_P7.20mm_Horizontal; JLCPCB Part # C98732
NT3, NT5: SHUNT IN-; NetTie-2_SMD_Pad1.0mm
NT4, NT6: SHUNT IN+; NetTie-2_SMD_Pad1.0mm
R27, R51, R52, R58, R59: 100k 1%; R_0603_1608Metric; JLCPCB Part # C14675
R28, R43: 10k 1%; R_0603_1608Metric; JLCPCB Part # C98220
R29, R30: 2k7 1%; R_0603_1608Metric; JLCPCB Part # C114612
R31, R32, R33, R34, R36, R39, R68, R71: 33R 1%; R_0603_1608Metric; JLCPCB Part # C108661
R35: 1k 1%; R_0603_1608Metric; JLCPCB Part # C22548
R37, R38, R69, R70: 2k 5%; R_0603_1608Metric; JLCPCB Part # C103396
R40, R41, R131: 270R 0.1%; R_0603_1608Metric; JLCPCB Part # C861270
R42, R53, R55, R57, R60, R67: 1.02k 0.1%; R_0603_1608Metric; JLCPCB Part # C705819
R44, R66: 0R; R_0603_1608Metric; JLCPCB Part # C103196
R45: 510R 0.1%; R_0603_1608Metric; JLCPCB Part # C2828640
R46, R65: 2R 5% 2W; R_2512_6332Metric_Pad1.40x3.35mm_HandSolder; JLCPCB Part # C91926
R47, R49, R61, R63: 2.4R 1% 1W; R_2512_6332Metric_Pad1.40x3.35mm_HandSolder; JLCPCB Part # C175225
R48, R50, R62, R64: 130R 1% 1W; R_2512_6332Metric_Pad1.40x3.35mm_HandSolder; JLCPCB Part # C728111
R54, R56: 8mR 1% 2W; R_2512_6332Metric_Pad1.40x3.35mm_HandSolder; JLCPCB Part # C2440282
SB2, SB3: CS_SEL; SolderJumper-3_P1.3mm_Open_RoundedPad1.0x1.5mm
SB4, SB9: SolderJumper-2_P1.3mm_Bridged2Bar_RoundedPad1.0x1.5mm
SB5, SB6, SB7, SB8, SB18, SB19, SB20: SolderJumper-2_P1.3mm_Open_RoundedPad1.0x1.5mm
TV5: PTVS5V0S1UR; D_SOD-123; JLCPCB Part # C478011
U8, U12, U15, U19: TLV9051; SOT-23-5; JLCPCB Part # C1849429
U9, U10: 74LVC2T45DC; VSSOP-8_2.3x2mm_P0.5mm; JLCPCB Part # C730237
U11, U20: FAN7382; SOIC-8_3.9x4.9mm_P1.27mm; JLCPCB Part # C128796
U13, U14, U17, U18: BSC0902NSI; TDSON-8-1; JLCPCB Part # C534382
U16: AD8418; MSOP-8_3x3mm_P0.65mm; JLCPCB Part # C147928
U21: INA240A1PWR; TSSOP-8_4.4x3mm_P0.65mm; JLCPCB Part # C93965

Connections:
+3V3: C40.2, C41.2, C42.1, C43.1, D2.2, FB7.2, FB9.2, FB11.2, R29.2, R30.2, U8.5 (V+), U9.1 (VCCA), U10.1 (VCCA); also elsewhere on the board
+5V: C44.1, C45.1, FB8.1, FB10.2, FB12.2, U9.8 (VCCB), U10.8 (VCCB); also elsewhere on the board
+15V: C46.1, C47.1, C62.2, C63.2, D3.2 (A), D8.2 (A), U11.1 (V_{CC}), U20.1 (V_{CC}); also elsewhere on the board
/Control/CURRENT_SIGNAL_FILT: R67.2, SB9.2 (B); also elsewhere on the board
/Control/L_MOT_HI_{PWM}: R31.2; also elsewhere on the board
/Control/L_MOT_LO_{PWM}: R32.2; also elsewhere on the board
/Control/MOTOR_INPUT_VOLTAGE_SIG: R35.2, U8.1, U8.4 (-); also elsewhere on the board
/Control/R_MOT_HI_{PWM}: R33.2; also elsewhere on the board
/Control/R_MOT_LO_{PWM}: R34.2; also elsewhere on the board
/Motor/CS_MEAS: R43.2, U12.3 (+)
/Motor/CS_MEAS_PRE_FILT: SB4.1 (A), U12.1, U12.4 (-)
/Motor/DC_MOT_T1: C48.1, NT3.1, R44.2, R51.1, R54.2, U13.1 (S), U13.2 (S), U13.3 (S), U14.5 (D)
/Motor/DC_MOT_T2: C59.1, J4.1, R58.1, R66.2, U17.1 (S), U17.2 (S), U17.3 (S), U18.5 (D)
/Motor/INNER: NT4.1, NT5.1, R54.1, R56.2
/Motor/L_H_{IN}: R36.1, R37.1, U11.2 (H_{IN})
/Motor/L_L_{IN}: R38.1, R39.1, U11.3 (L_{IN})
/Motor/L_PWM: R36.2, U9.7 (1B)
/Motor/L_V_{B}: C48.2, R46.1, U11.8 (V_{B})
/Motor/L_{GT}+: D4.2 (A), R48.1, R51.2, U13.4 (G)
/Motor/L_{GT}-: D5.2 (A), R50.1, R52.2, U14.4 (G)
/Motor/L_{PWM}+: R47.2, R48.2, U11.7 (H_{O})
/Motor/L_{PWM}-: R49.2, R50.2, U11.5 (L_{O})
/Motor/M+: J4.2, NT6.1, R56.1
/Motor/R_H_{IN}: R68.1, R69.1, U20.2 (H_{IN})
/Motor/R_L_{IN}: R70.1, R71.1, U20.3 (L_{IN})
/Motor/R_PWM: R68.2, U10.7 (1B)
/Motor/R_V_{B}: C59.2, R65.1, U20.8 (V_{B})
/Motor/R_{GT}+: D6.2 (A), R58.2, R62.1, U17.4 (G)
/Motor/R_{GT}-: D7.2 (A), R59.2, R64.1, U18.4 (G)
/Motor/R_{PWM}+: R61.2, R62.2, U20.7 (H_{O})
/Motor/R_{PWM}-: R63.2, R64.2, U20.5 (L_{O})
/Motor/V_{SHUNT}_B+: NT4.2, SB7.1 (A), SB7.2 (B), U21.2 (+)
/Motor/V_{SHUNT}_B-: NT3.2, SB8.1 (A), SB8.2 (B), U21.3 (-)
/Motor/~L_PWM: R39.2, U9.6 (2B)
/Motor/~R_PWM: R71.2, U10.6 (2B)
GND: C39.1, C40.1, C41.1, C42.2, C43.2, C44.2, C45.2, C49.2, C50.2, C52.1, C53.2, C54.2, C55.2, C56.2, C58.1, C60.2, C61.2, C64.1, C65.1, D2.1, J3.1, J3.3, R28.1, R35.1, R37.2, R38.2, R42.1, R67.1, R69.2, R70.2, TV5.2 (A), U8.2 (V-), U9.4 (GND), U10.4 (GND), U12.2 (V-), U15.2 (V-), U16.2 (GND), U16.3 (REF2), U19.2 (V-), U21.1 (GND), U21.4 (GND), U21.6 (REF2); also elsewhere on the board
unnamed: C51.1, R53.2, R55.1
unnamed: C57.1, R57.2, R60.1
unnamed: D3.1 (K), R46.2
unnamed: D4.1 (K), R47.1
unnamed: D5.1 (K), R49.1
unnamed: D6.1 (K), R61.1
unnamed: D7.1 (K), R63.1
unnamed: D8.1 (K), R65.2
unnamed: FB8.2, J3.2
unnamed: J3.4, R45.2, TV5.1 (K)
unnamed: R40.1, R41.1, R131.1, SB2.2 (C)
unnamed: R45.1, SB3.3 (B)
unnamed: D2.3, R42.2, R43.1, SB3.2 (C)
unnamed: R53.1, SB4.2 (B)
unnamed: C57.2, SB9.1 (A), U19.1, U19.4 (-)
unnamed: R40.2, SB18.1 (A)
unnamed: SB3.1 (A), SB18.2 (B), SB19.2 (B), SB20.2 (B)
unnamed: R41.2, SB19.1 (A)
unnamed: R131.2, SB20.1 (A)
unnamed: C39.2, R27.1, R28.2, U8.3 (+)
unnamed: R31.1, U9.2 (1A)
unnamed: R32.1, U9.3 (2A)
unnamed: R29.1, U9.5 (DIR)
unnamed: R33.1, U10.2 (1A)
unnamed: R34.1, U10.3 (2A)
unnamed: R30.1, U10.5 (DIR)
unnamed: R44.1, U11.6 (V_{S})
unnamed: C49.1, C50.1, FB7.1, U12.5 (V+)
unnamed: C52.2, R55.2, U15.3 (+)
unnamed: C51.2, R57.1, U15.1, U15.4 (-)
unnamed: C53.1, C54.1, FB9.1, U15.5 (V+)
unnamed: C55.1, C56.1, FB10.1, U16.6 (VS), U16.7 (REF1)
unnamed: C58.2, R60.2, U19.3 (+)
unnamed: C60.1, C61.1, FB11.1, U19.5 (V+)
unnamed: R66.1, U20.6 (V_{S})
unnamed: C64.2, C65.2, FB12.1, U21.5 (Vs), U21.7 (REF1)
PGND: C46.2, C47.2, C62.1, C63.1, R52.1, R59.1, U11.4 (Com), U14.1 (S), U14.2 (S), U14.3 (S), U18.1 (S), U18.2 (S), U18.3 (S), U20.4 (Com); also elsewhere on the board
V_{MOTOR}: R27.2, U13.5 (D), U17.5 (D); also elsewhere on the board

Notes on the sheet:
Current signal conditioning interface
Servomotor interface
PWM Signals
Voltage conditioner: - AD8418: Av = 0.80 V/V - ACS712: Av = 0.67 V/V
Filter: - Order: 4 th - Fc: ~= 4 kHz
Change CS MEAS Gain Resistors Change CS MEAS Shunts
Motor Terminals
H-Bridge input voltage sense
