parkourlrc/pcb-tgiacomellibr--sjc-6abed6a295/hardware_v0.2/hardware_v0.2.kicad_pcb

## KiCad design hardware_v0.2/hardware_v0.2.kicad_pcb (continued)

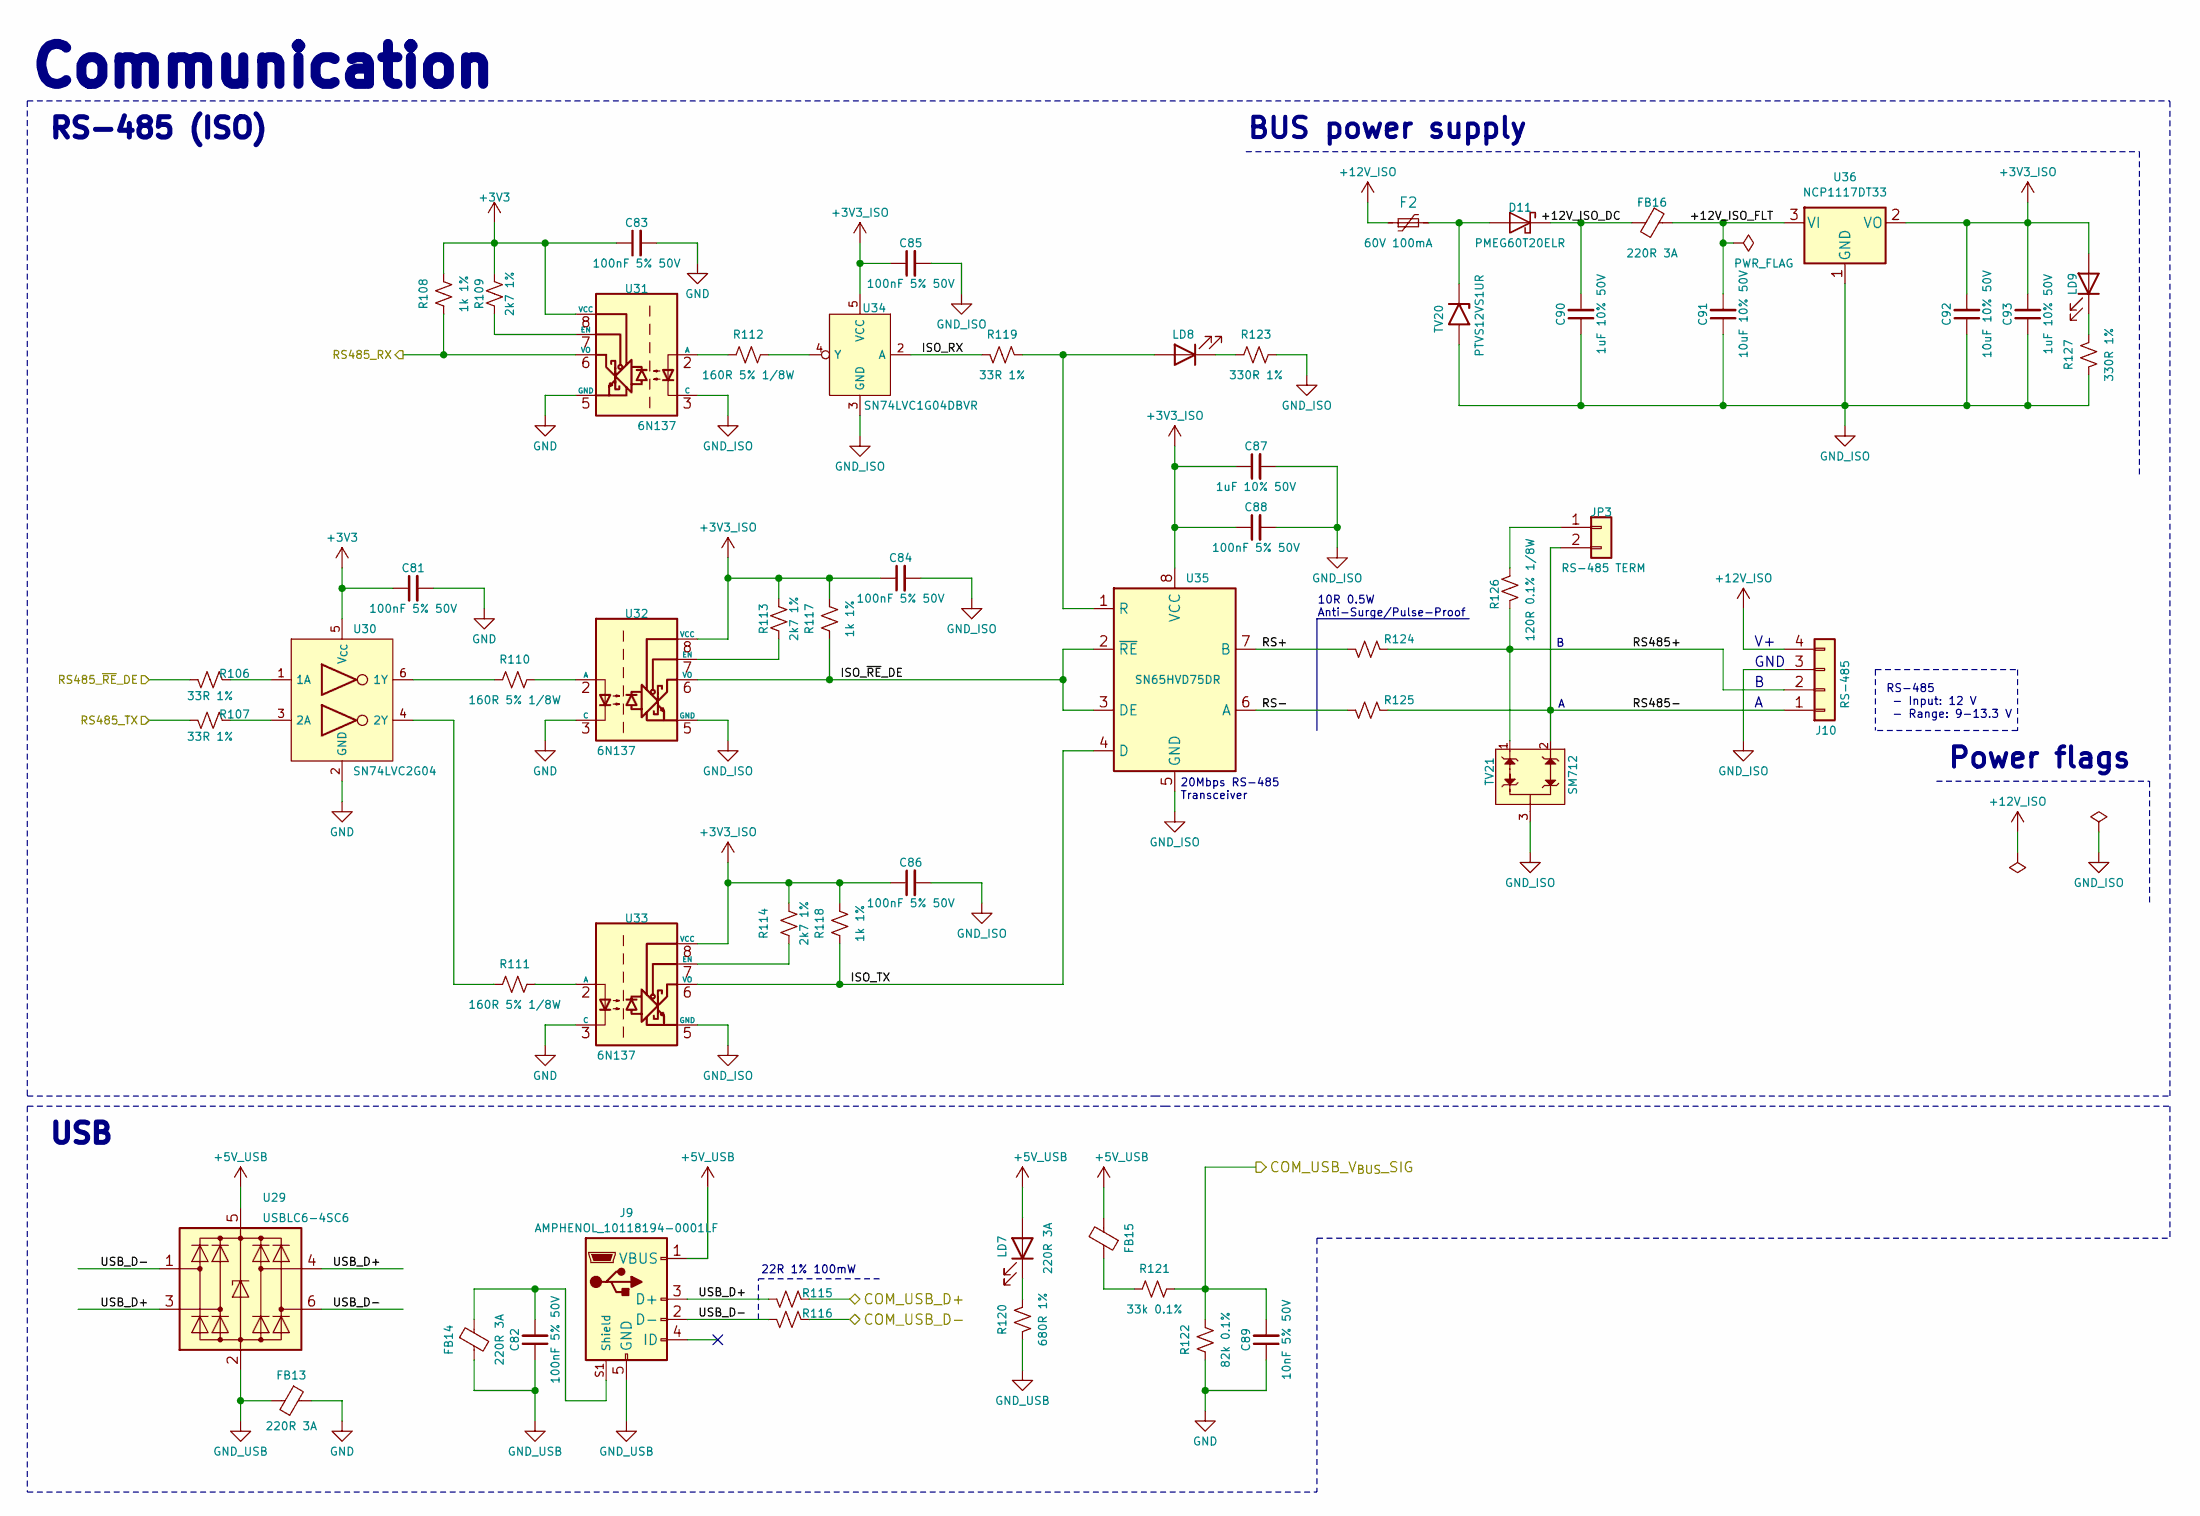
[picture p33: schematic communication.kicad_sch, SJC Communication]

Parts:
C81, C82, C83, C84, C85, C86, C88: 100nF 5% 50V; C_0603_1608Metric; JLCPCB Part # C91183
C87, C90, C93: 1uF 10% 50V; C_1206_3216Metric; JLCPCB Part # C1848
C89: 10nF 5% 50V; C_0603_1608Metric; JLCPCB Part # C389113
C91, C92: 10uF 10% 50V; C_1206_3216Metric; JLCPCB Part # C13585
D11: PMEG60T20ELR; D_SOD-123F; JLCPCB Part # C552947
F2: 60V 100mA; Fuse_1206_3216Metric; JLCPCB Part # C2153714
FB13, FB14, FB15, FB16: 220R 3A; L_0805_2012Metric_Pad1.05x1.20mm_HandSolder; JLCPCB Part # C76818
J9: AMPHENOL_10118194-0001LF; JLCPCB Part # C132563
J10: RS-485; TerminalBlock_Phoenix_MKDS-3-4-5.08_1x04_P5.08mm_Horizontal; JLCPCB Part # C2915641
JP3: RS-485 TERM; PinHeader_1x02_P2.54mm_Vertical; JLCPCB Part # C234182
LD7, LD8, LD9: 1.8V @ 5mA; LED_0603_1608Metric_Pad1.05x0.95mm_HandSolder; JLCPCB Part # C165982
R106, R107, R119: 33R 1%; R_0603_1608Metric; JLCPCB Part # C108661
R108, R117, R118: 1k 1%; R_0603_1608Metric; JLCPCB Part # C22548
R109, R113, R114: 2k7 1%; R_0603_1608Metric; JLCPCB Part # C114612
R110, R111, R112: 160R 5% 1/8W; R_0603_1608Metric; JLCPCB Part # C171721
R115, R116: 22R 1%; R_0603_1608Metric; JLCPCB Part # C107701
R120: 680R 1%; R_0603_1608Metric; JLCPCB Part # C2097840
R121: 33k 0.1%; R_0603_1608Metric; JLCPCB Part # C2828645
R122: 82k 0.1%; R_0603_1608Metric; JLCPCB Part # C728598
R123, R127: 330R 1%; R_0603_1608Metric; JLCPCB Part # C144102
R124, R125: 10R 1% 1/2W; R_0805_2012Metric_Pad1.20x1.40mm_HandSolder; JLCPCB Part # C441969
R126: 120R 0.1% 1/8W; R_0805_2012Metric_Pad1.20x1.40mm_HandSolder; JLCPCB Part # C2828708
TV20: PTVS12VS1UR; D_SOD-123; JLCPCB Part # C456115
TV21: SM712; SOT-23-3; JLCPCB Part # C293966
U29: USBLC6-4SC6; SOT-23-6_Handsoldering; JLCPCB Part # C111212
U30: SN74LVC2G04; SOT-23-6_Handsoldering; JLCPCB Part # C10428
U31, U32, U33: 6N137; SMDIP-8_W7.62mm; JLCPCB Part # C92651
U34: SN74LVC1G04DBVR; SOT-23-5_HandSoldering; JLCPCB Part # C7827
U35: SN65HVD75DR; SOIC-8_3.9x4.9mm_P1.27mm; JLCPCB Part # C57928
U36: NCP1117DT33; TO-252-2; JLCPCB Part # C152529

Connections:
+3V3: C81.1, C83.1, R108.2, R109.2, U30.5 (V_{CC}), U31.8 (VCC); also elsewhere on the board
+3V3_ISO: C84.1, C85.1, C86.1, C87.1, C88.1, C92.2, C93.2, LD9.2 (A), R113.2, R114.2, R117.2, R118.2, U32.8 (VCC), U33.8 (VCC), U34.5 (VCC), U35.8 (VCC), U36.2 (VO)
+5V_USB: FB15.2, J9.1 (VBUS), LD7.2 (A), U29.5 (VBUS)
+12V_ISO: F2.1, J10.4
/Communication/+12V_ISO_DC: C90.2, D11.1 (K), FB16.2
/Communication/+12V_ISO_FLT: C91.2, FB16.1, U36.3 (VI)
/Communication/COM_USB_D+: R115.1; also elsewhere on the board
/Communication/COM_USB_D-: R116.1; also elsewhere on the board
/Communication/COM_USB_V_{BUS}_SIG: C89.2, R121.2, R122.2; also elsewhere on the board
/Communication/ISO_RX: R119.2, U34.2 (A)
/Communication/ISO_TX: R118.1, U33.6 (VO), U35.4 (D)
/Communication/ISO_~RE_DE: R117.1, U32.6 (VO), U35.2 (~RE), U35.3 (DE)
/Communication/RS485+: J10.2, R124.1, R126.1, TV21.1
/Communication/RS485-: J10.1, JP3.2, R125.1, TV21.2
/Communication/RS485_RX: R108.1, U31.6 (VO); also elsewhere on the board
/Communication/RS485_TX: R107.2; also elsewhere on the board
/Communication/RS485_~RE_DE: R106.2; also elsewhere on the board
/Communication/RS+: R124.2, U35.7 (B)
/Communication/RS-: R125.2, U35.6 (A)
/Communication/USB_D+: J9.3 (D+), R115.2, U29.3 (I/O2), U29.4 (I/O3)
/Communication/USB_D-: J9.2 (D-), R116.2, U29.1 (I/O1), U29.6 (I/O4)
GND: C81.2, C83.2, C89.1, FB13.1, R122.1, U30.2 (GND), U31.5 (GND), U32.3 (C), U33.3 (C); also elsewhere on the board
GND_ISO: C84.2, C85.2, C86.2, C87.2, C88.2, C90.1, C91.1, C92.1, C93.1, J10.3, R123.2, R127.2, TV20.2 (A), TV21.3, U31.3 (C), U32.5 (GND), U33.5 (GND), U34.3 (GND), U35.5 (GND), U36.1 (GND)
GND_USB: C82.1, FB13.2, FB14.2, J9.5 (GND), R120.2, U29.2 (GND)
unnamed: C82.2, FB14.1, J9.S1 (Shield), J9.S2 (Shield), J9.S3 (Shield), J9.S4 (Shield), J9.S5 (Shield), J9.S6 (Shield)
unnamed: D11.2 (A), F2.2, TV20.1 (K)
unnamed: FB15.1, R121.1
unnamed: JP3.1, R126.2
unnamed: LD7.1 (K), R120.1
unnamed: LD8.2 (A), R119.1, U35.1 (R)
unnamed: LD8.1 (K), R123.1
unnamed: LD9.1 (K), R127.1
unnamed: R106.1, U30.1 (1A)
unnamed: R110.1, U30.6 (1Y)
unnamed: R107.1, U30.3 (2A)
unnamed: R111.1, U30.4 (2Y)
unnamed: R112.1, U31.2 (A)
unnamed: R109.1, U31.7 (EN)
unnamed: R110.2, U32.2 (A)
unnamed: R113.1, U32.7 (EN)
unnamed: R111.2, U33.2 (A)
unnamed: R114.1, U33.7 (EN)
unnamed: R112.2, U34.4 (Y)

Notes on the sheet:
RS-485 (ISO)
10R 0.5W Anti-Surge/Pulse-Proof
Power flags
20Mbps RS-485 Transceiver
BUS power supply
USB
22R 1% 100mW
GND
Communication
RS-485 - Input: 12 V - Range: 9-13.3 V

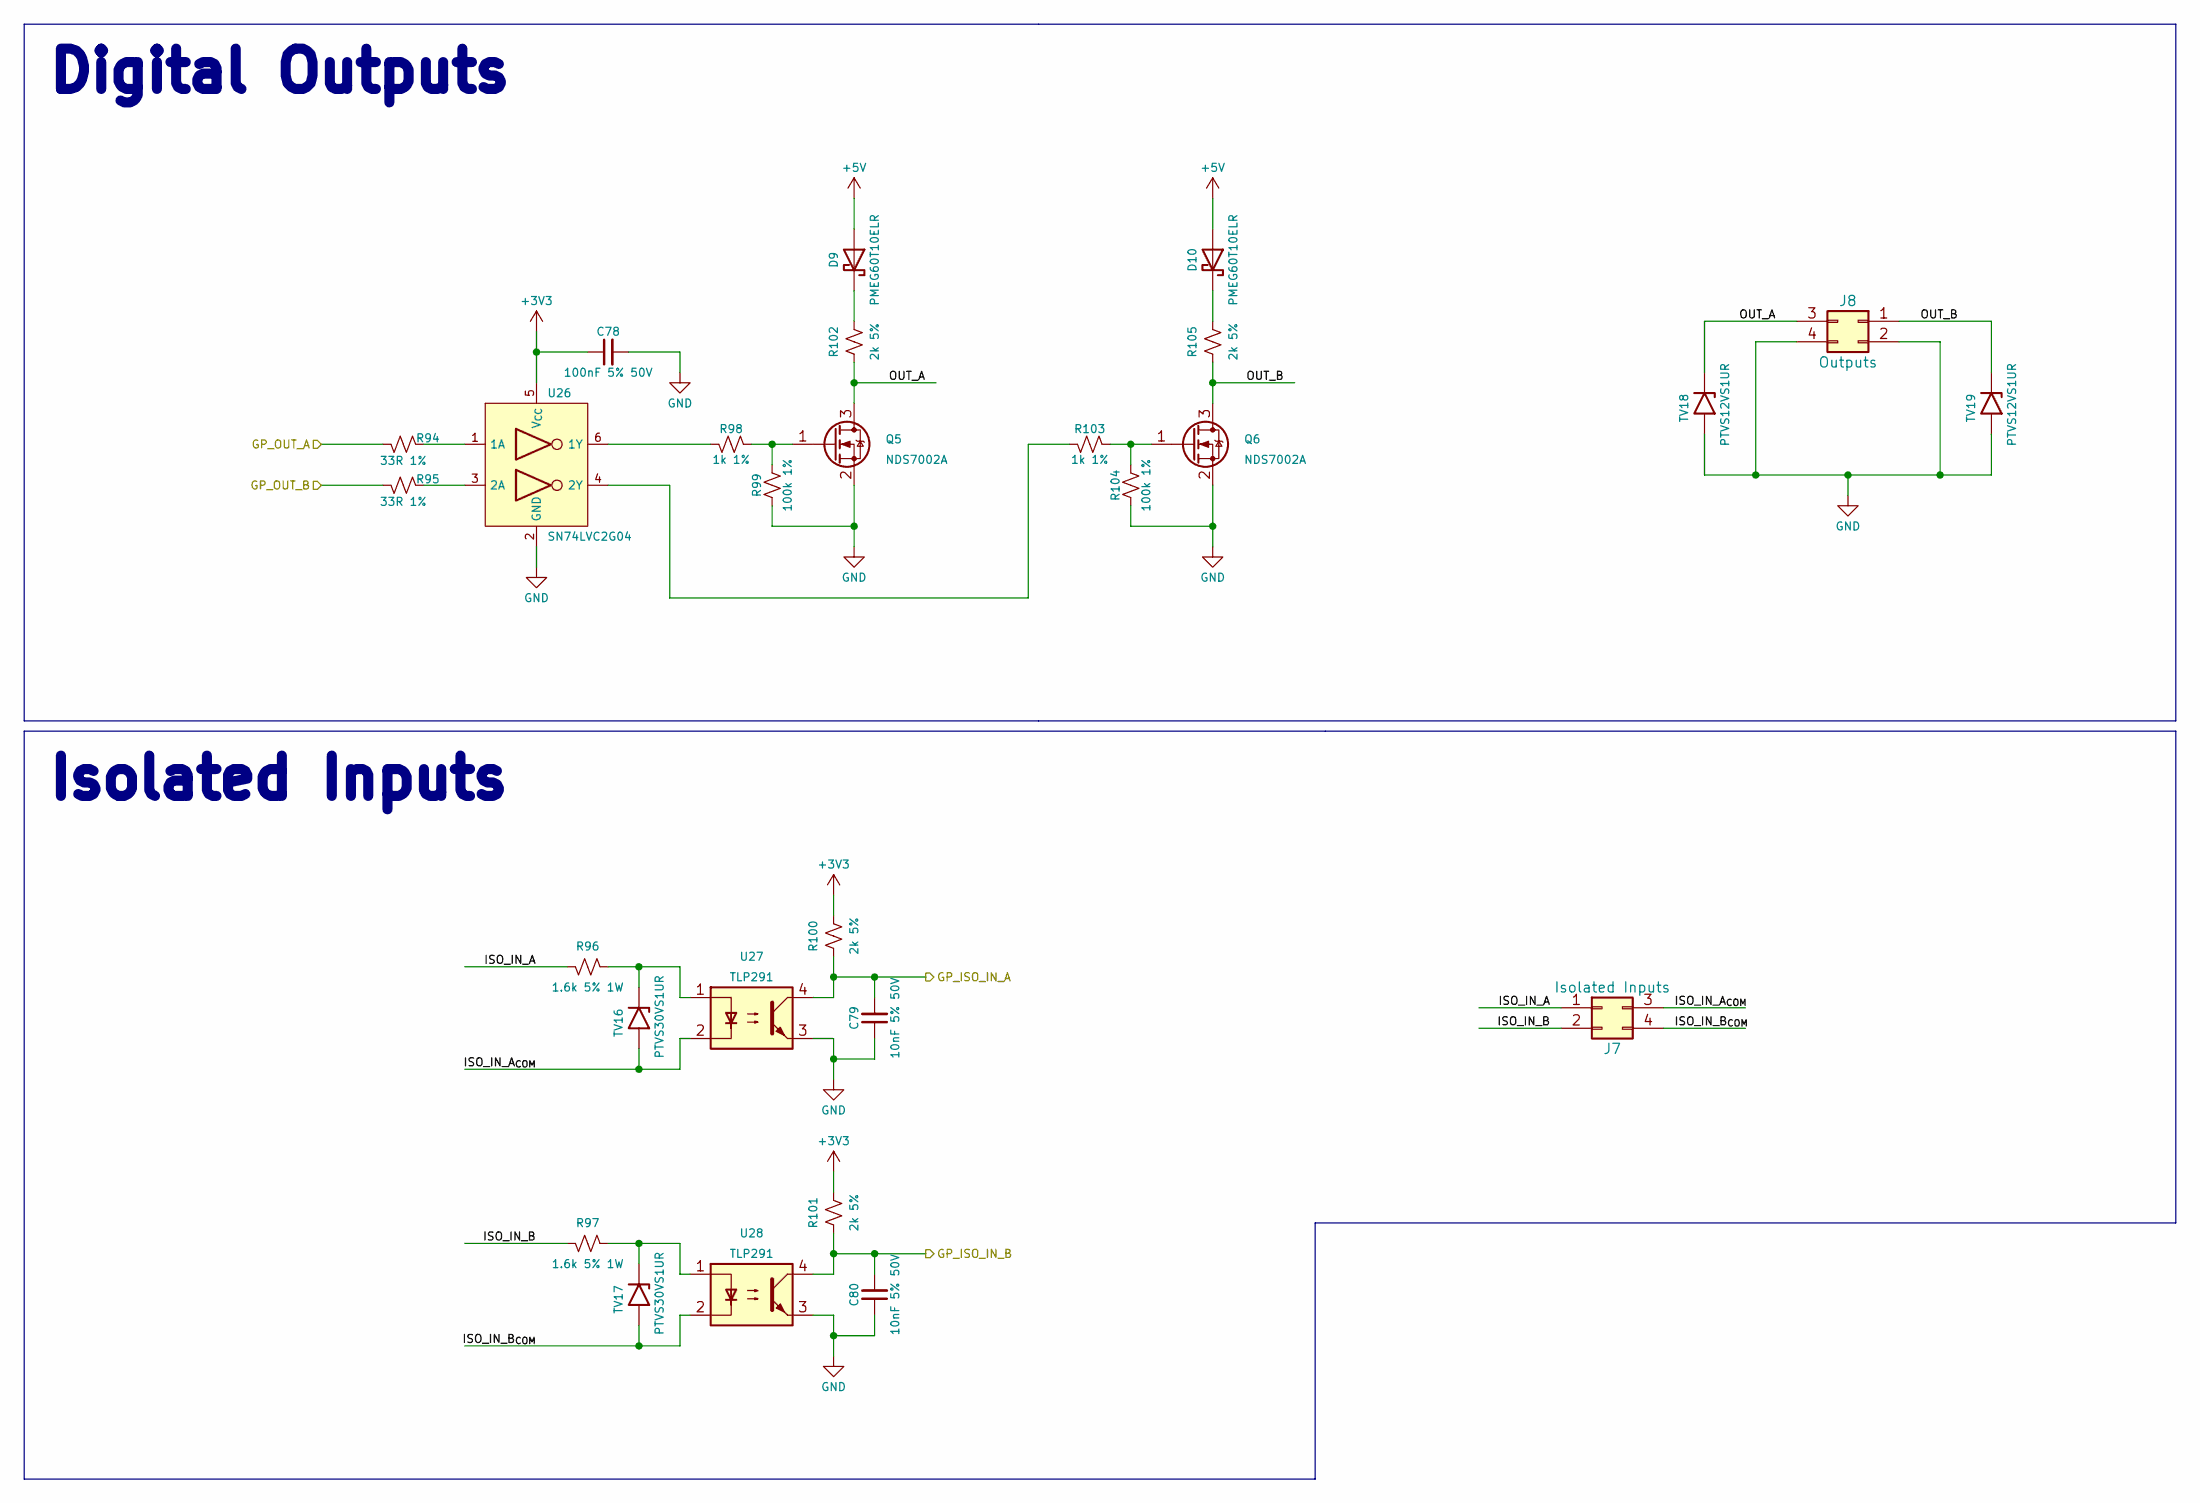
[picture p34: schematic gpios.kicad_sch, SJC I/Os]

Parts:
C78: 100nF 5% 50V; C_0603_1608Metric; JLCPCB Part # C91183
C79, C80: 10nF 5% 50V; C_0603_1608Metric; JLCPCB Part # C389113
D9, D10: PMEG60T10ELR; D_SOD-123F; JLCPCB Part # C552945
J7: Isolated Inputs; Molex_Micro-Fit_3.0_43045-0412_2x02_P3.00mm_Vertical
J8: Outputs; Molex_Micro-Fit_3.0_43045-0412_2x02_P3.00mm_Vertical
Q5, Q6: NDS7002A; SOT-23; JLCPCB Part # C74715
R94, R95: 33R 1%; R_0603_1608Metric; JLCPCB Part # C108661
R96, R97: 1.6k 5% 1W; R_2512_6332Metric_Pad1.40x3.35mm_HandSolder; JLCPCB Part # C453392
R98, R103: 1k 1%; R_0603_1608Metric; JLCPCB Part # C22548
R99, R104: 100k 1%; R_0603_1608Metric; JLCPCB Part # C14675
R100, R101, R102, R105: 2k 5%; R_0603_1608Metric; JLCPCB Part # C103396
TV16, TV17: PTVS30VS1UR; D_SOD-123; JLCPCB Part # C553410
TV18, TV19: PTVS12VS1UR; D_SOD-123; JLCPCB Part # C456115
U26: SN74LVC2G04; SOT-23-6_Handsoldering; JLCPCB Part # C10428
U27, U28: TLP291; SOP-4_4.4x2.6mm_P1.27mm; JLCPCB Part # C55144

Connections:
+3V3: C78.1, R100.2, R101.2, U26.5 (V_{CC}); also elsewhere on the board
+5V: D9.2 (A), D10.2 (A); also elsewhere on the board
/Control/GP_ISO_IN_A: C79.2, R100.1, U27.4; also elsewhere on the board
/Control/GP_ISO_IN_B: C80.2, R101.1, U28.4; also elsewhere on the board
/Control/GP_OUT_A: R94.2; also elsewhere on the board
/Control/GP_OUT_B: R95.2; also elsewhere on the board
/GPIOs/ISO_IN_A: J7.1, R96.2
/GPIOs/ISO_IN_A_{COM}: J7.3, TV16.2 (A), U27.2
/GPIOs/ISO_IN_B: J7.2, R97.2
/GPIOs/ISO_IN_B_{COM}: J7.4, TV17.2 (A), U28.2
/GPIOs/OUT_A: J8.3, Q5.3 (D), R102.1, TV18.1 (K)
/GPIOs/OUT_B: J8.1, Q6.3 (D), R105.1, TV19.1 (K)
GND: C78.2, C79.1, C80.1, J8.2, J8.4, Q5.2 (S), Q6.2 (S), R99.1, R104.1, TV18.2 (A), TV19.2 (A), U26.2 (GND), U27.3, U28.3; also elsewhere on the board
unnamed: D9.1 (K), R102.2
unnamed: D10.1 (K), R105.2
unnamed: Q5.1 (G), R98.1, R99.2
unnamed: Q6.1 (G), R103.1, R104.2
unnamed: R96.1, TV16.1 (K), U27.1
unnamed: R97.1, TV17.1 (K), U28.1
unnamed: R94.1, U26.1 (1A)
unnamed: R98.2, U26.6 (1Y)
unnamed: R95.1, U26.3 (2A)
unnamed: R103.2, U26.4 (2Y)

Notes on the sheet:
Isolated Inputs
Digital Outputs

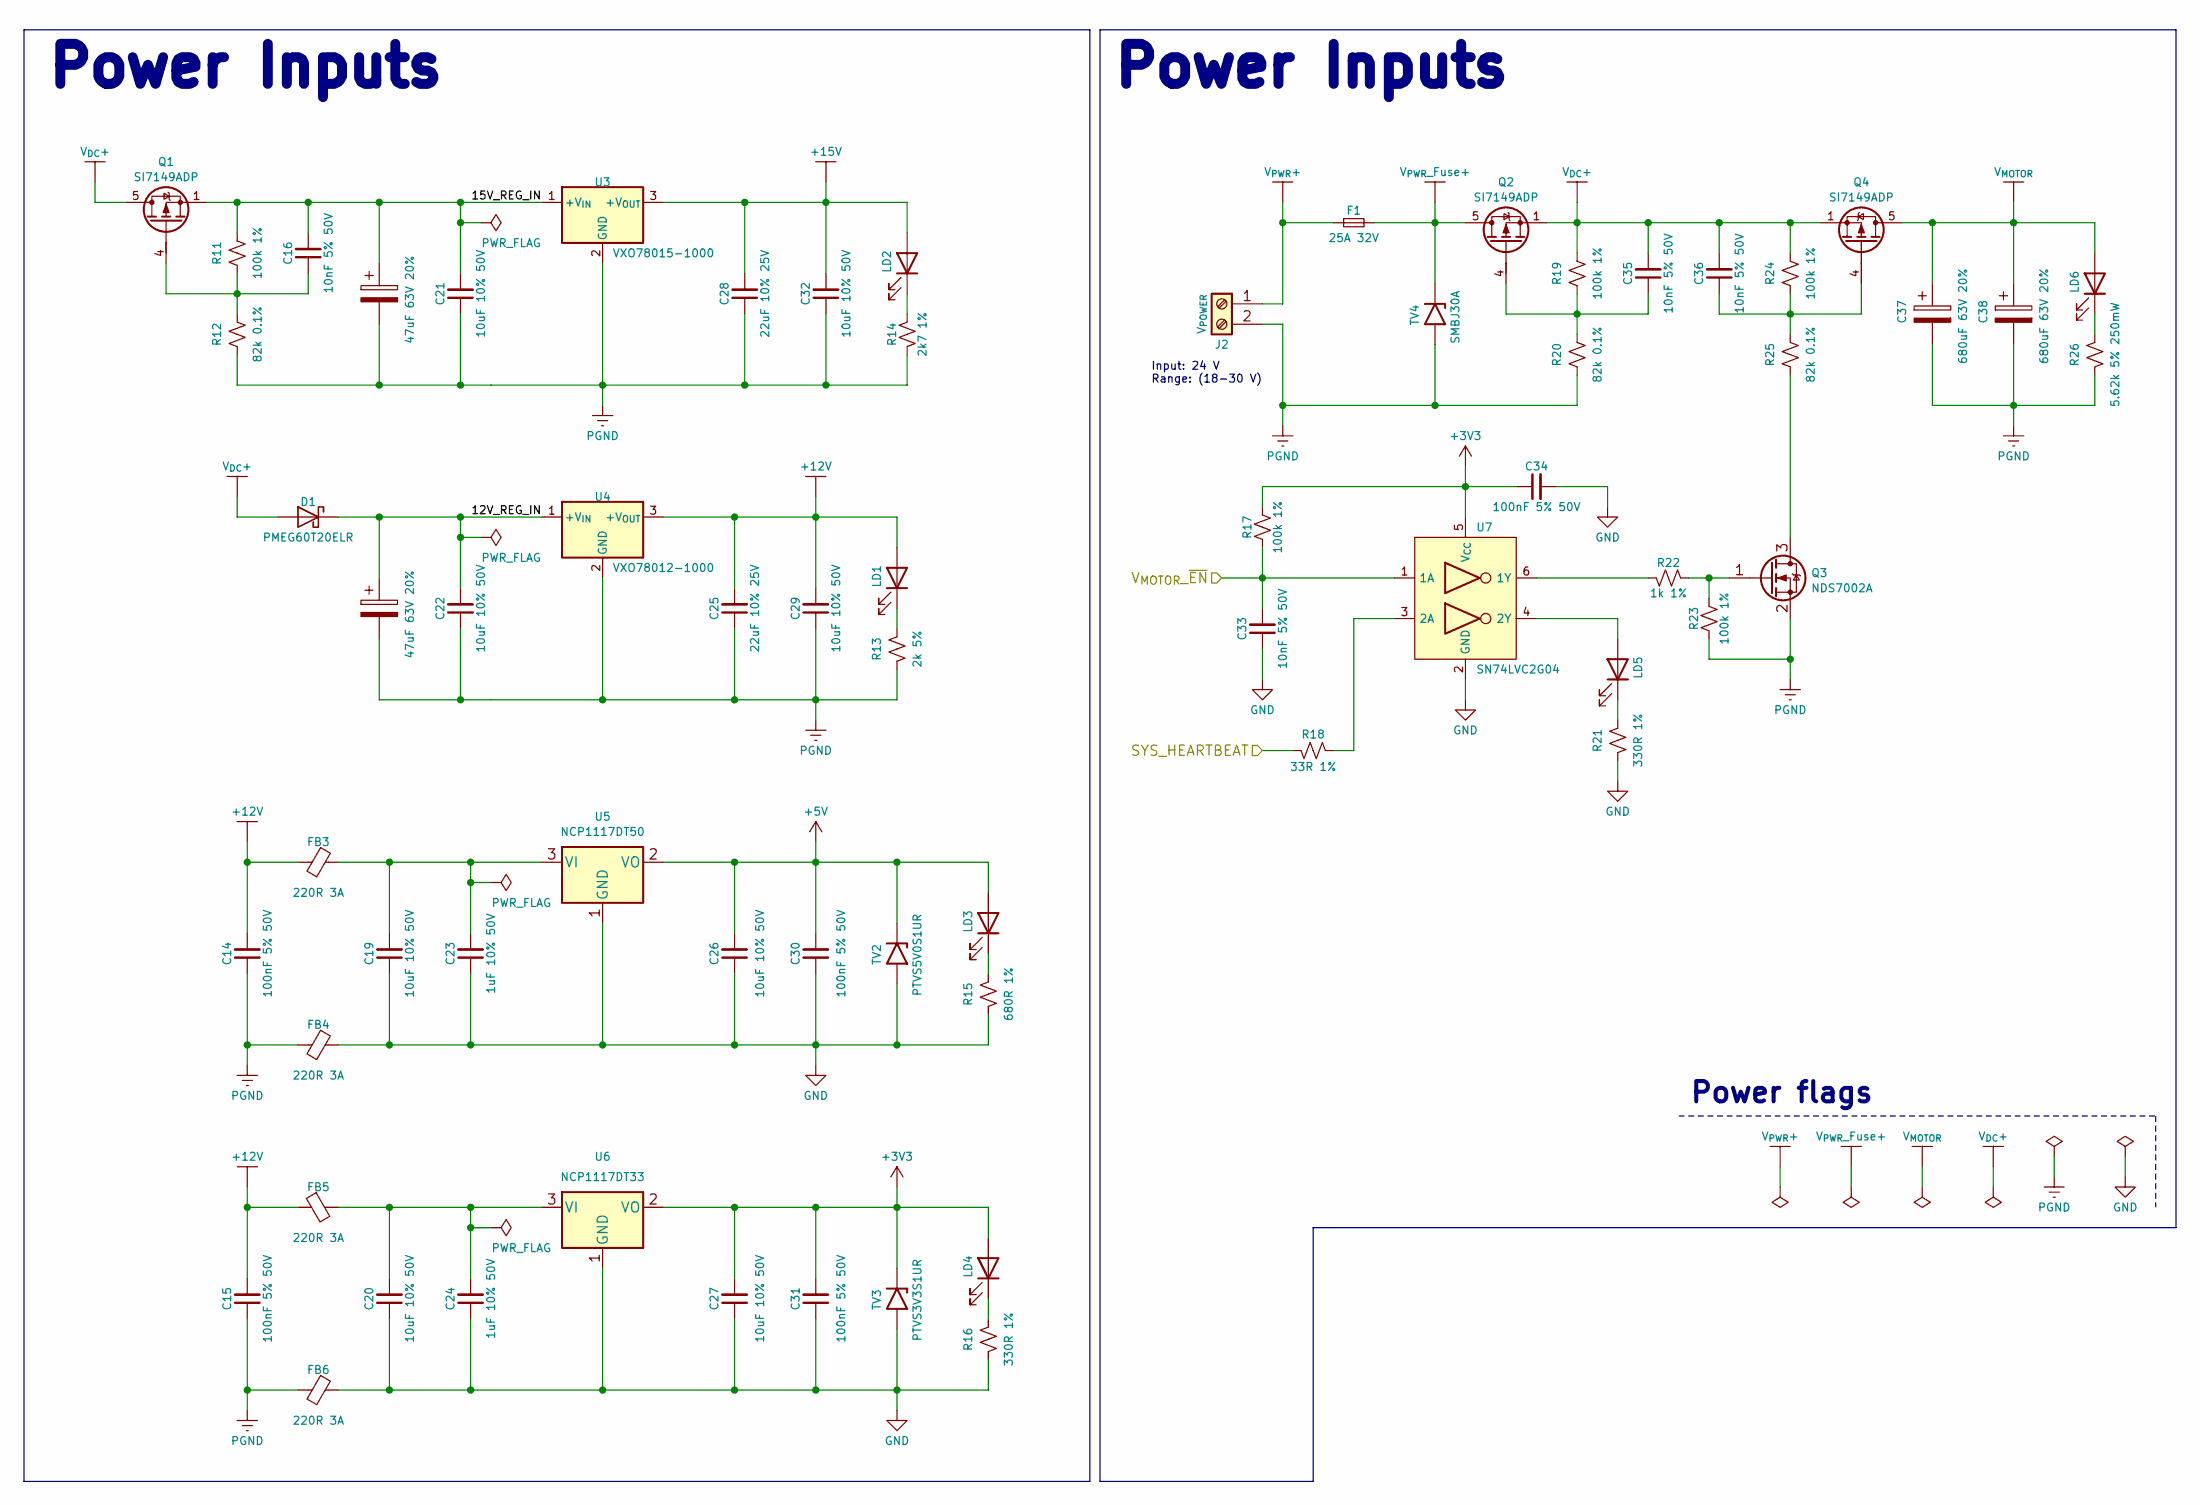
[picture p35: schematic power_supply.kicad_sch, SJC Power Supply]

Parts:
C14, C15, C30, C31, C34: 100nF 5% 50V; C_0603_1608Metric; JLCPCB Part # C91183
C16, C33, C35, C36: 10nF 5% 50V; C_0603_1608Metric; JLCPCB Part # C389113
C17, C18: 47uF 63V 20%; CP_Elec_8x10.5; JLCPCB Part # C116428
C19, C20, C21, C22, C26, C27, C29, C32: 10uF 10% 50V; C_1206_3216Metric; JLCPCB Part # C13585
C23, C24: 1uF 10% 50V; C_1206_3216Metric; JLCPCB Part # C1848
C25, C28: 22uF 10% 25V; C_1206_3216Metric; JLCPCB Part # C105213
C37, C38: 680uF 63V 20%; CP_Elec_18x17.5; JLCPCB Part # C249956
D1: PMEG60T20ELR; D_SOD-123F; JLCPCB Part # C552947
F1: 25A 32V; Fuse_1206_3216Metric_Pad1.42x1.75mm_HandSolder; JLCPCB Part # C2925001
FB3, FB4, FB5, FB6: 220R 3A; L_0805_2012Metric_Pad1.05x1.20mm_HandSolder; JLCPCB Part # C76818
J2: V_{POWER}; AMASS_XT60PW-M_1x02_P7.20mm_Horizontal; JLCPCB Part # C98732
LD1, LD2, LD3, LD4, LD5, LD6: 1.8V @ 5mA; LED_0603_1608Metric_Pad1.05x0.95mm_HandSolder; JLCPCB Part # C165982
Q1, Q2, Q4: SI7149ADP; PowerPAK_SO-8_Single; JLCPCB Part # C554002
Q3: NDS7002A; SOT-23; JLCPCB Part # C74715
R11, R17, R19, R23, R24: 100k 1%; R_0603_1608Metric; JLCPCB Part # C14675
R12, R20, R25: 82k 0.1%; R_0603_1608Metric; JLCPCB Part # C728598
R13: 2k 5%; R_0603_1608Metric; JLCPCB Part # C103396
R14: 2k7 1%; R_0603_1608Metric; JLCPCB Part # C114612
R15: 680R 1%; R_0603_1608Metric; JLCPCB Part # C2097840
R16, R21: 330R 1%; R_0603_1608Metric; JLCPCB Part # C144102
R18: 33R 1%; R_0603_1608Metric; JLCPCB Part # C108661
R22: 1k 1%; R_0603_1608Metric; JLCPCB Part # C22548
R26: 5.62k 5% 250mW; R_0805_2012Metric_Pad1.20x1.40mm_HandSolder; JLCPCB Part # C425493
TV2: PTVS5V0S1UR; D_SOD-123; JLCPCB Part # C478011
TV3: PTVS3V3S1UR; D_SOD-123; JLCPCB Part # C183521
TV4: SMBJ30A; D_SMB_Handsoldering; JLCPCB Part # C83851
U3: VXO78015-1000; CONV_VXO78015-1000; Mouser # 490-VXO7815-1000
U4: VXO78012-1000; CONV_VXO78012-1000; Mouser # 490-VXO7812-1000
U5: NCP1117DT50; TO-252-2; JLCPCB Part # C152470
U6: NCP1117DT33; TO-252-2; JLCPCB Part # C152529
U7: SN74LVC2G04; SOT-23-6_Handsoldering; JLCPCB Part # C10428

Connections:
+3V3: C27.2, C31.2, C34.1, LD4.2 (A), R17.2, TV3.1 (K), U6.2 (VO), U7.5 (V_{CC}); also elsewhere on the board
+5V: C26.2, C30.2, LD3.2 (A), TV2.1 (K), U5.2 (VO); also elsewhere on the board
+12V: C14.2, C15.2, C25.2, C29.2, FB3.2, FB5.1, LD1.2 (A), U4.3 (+V_{OUT})
+15V: C28.2, C32.2, LD2.2 (A), U3.3 (+V_{OUT}); also elsewhere on the board
/Control/SYS_HEARTBEAT: R18.1; also elsewhere on the board
/Control/V_{MOTOR}_~EN: C33.2, R17.1, U7.1 (1A); also elsewhere on the board
/Power Supply/12V_REG_IN: C18.1, C22.2, D1.1 (K), U4.1 (+V_{IN})
/Power Supply/15V_REG_IN: C16.2, C17.1, C21.2, Q1.1 (S), Q1.2 (S), Q1.3 (S), R11.2, U3.1 (+V_{IN})
GND: C19.1, C20.1, C23.1, C24.1, C26.1, C27.1, C30.1, C31.1, C33.1, C34.2, FB4.1, FB6.1, R15.2, R16.2, R21.2, TV2.2 (A), TV3.2 (A), U5.1 (GND), U6.1 (GND), U7.2 (GND); also elsewhere on the board
unnamed: LD1.1 (K), R13.1
unnamed: LD2.1 (K), R14.1
unnamed: LD3.1 (K), R15.1
unnamed: LD4.1 (K), R16.1
unnamed: LD5.2 (A), U7.4 (2Y)
unnamed: LD5.1 (K), R21.1
unnamed: LD6.1 (K), R26.1
unnamed: C16.1, Q1.4 (G), R11.1, R12.2
unnamed: C35.1, Q2.4 (G), R19.1, R20.2
unnamed: Q3.3 (D), R25.1
unnamed: Q3.1 (G), R22.1, R23.2
unnamed: C36.1, Q4.4 (G), R24.1, R25.2
unnamed: C19.2, C23.2, FB3.1, U5.3 (VI)
unnamed: C20.2, C24.2, FB5.2, U6.3 (VI)
unnamed: R22.2, U7.6 (1Y)
unnamed: R18.2, U7.3 (2A)
PGND: C14.1, C15.1, C17.2, C18.2, C21.1, C22.1, C25.1, C28.1, C29.1, C32.1, C37.2, C38.2, FB4.2, FB6.2, J2.2, Q3.2 (S), R12.1, R13.2, R14.2, R20.1, R23.1, R26.2, TV4.2 (A), U3.2 (GND), U4.2 (GND); also elsewhere on the board
V_{DC}+: C35.2, C36.2, D1.2 (A), Q1.5 (D), Q2.1 (S), Q2.2 (S), Q2.3 (S), Q4.1 (S), Q4.2 (S), Q4.3 (S), R19.2, R24.2
V_{MOTOR}: C37.1, C38.1, LD6.2 (A), Q4.5 (D); also elsewhere on the board
V_{PWR}+: F1.1, J2.1
V_{PWR}_Fuse+: F1.2, Q2.5 (D), TV4.1 (K)

Notes on the sheet:
Power flags
Power Inputs
Input: 24 V Range: (18-30 V)

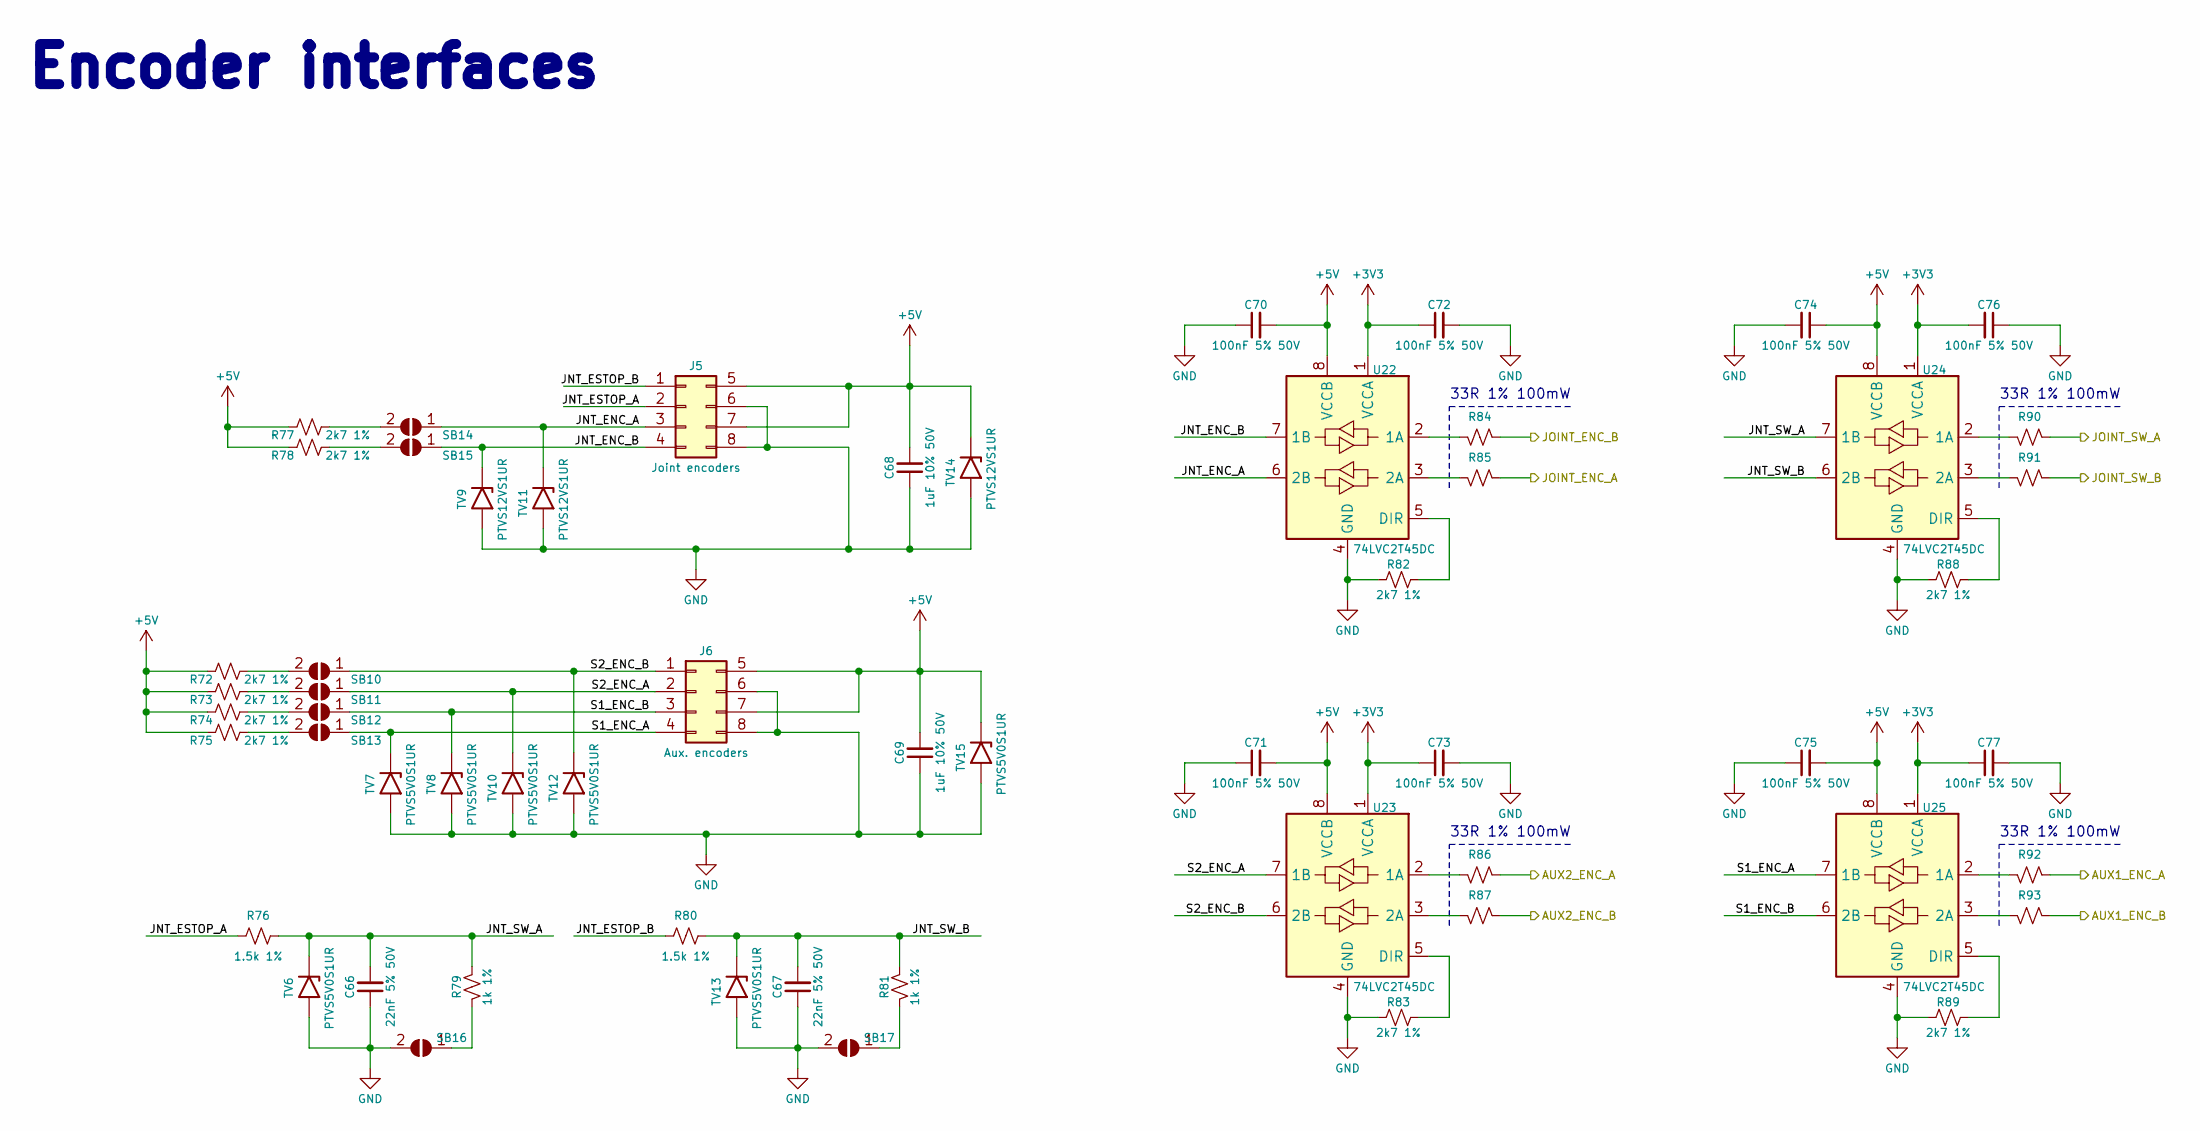
[picture p36: schematic encoders.kicad_sch, SJC Encoders]

Parts:
C66, C67: 22nF 5% 50V; C_0603_1608Metric; JLCPCB Part # C277528
C68, C69: 1uF 10% 50V; C_1206_3216Metric; JLCPCB Part # C1848
C70, C71, C72, C73, C74, C75, C76, C77: 100nF 5% 50V; C_0603_1608Metric; JLCPCB Part # C91183
J5: Joint encoders; Molex_Micro-Fit_3.0_43045-0812_2x04_P3.00mm_Vertical
J6: Aux. encoders; Molex_Micro-Fit_3.0_43045-0812_2x04_P3.00mm_Vertical
R72, R73, R74, R75, R77, R78, R82, R83, R88, R89: 2k7 1%; R_0603_1608Metric; JLCPCB Part # C114612
R76, R80: 1.5k 1%; R_0603_1608Metric; JLCPCB Part # C285210
R79, R81: 1k 1%; R_0603_1608Metric; JLCPCB Part # C22548
R84, R85, R86, R87, R90, R91, R92, R93: 33R 1%; R_0603_1608Metric; JLCPCB Part # C108661
SB10, SB11, SB12, SB13, SB14, SB15, SB16, SB17: SolderJumper-2_P1.3mm_Open_RoundedPad1.0x1.5mm
TV6, TV7, TV8, TV10, TV12, TV13, TV15: PTVS5V0S1UR; D_SOD-123; JLCPCB Part # C478011
TV9, TV11, TV14: PTVS12VS1UR; D_SOD-123; JLCPCB Part # C456115
U22, U23, U24, U25: 74LVC2T45DC; VSSOP-8_2.3x2mm_P0.5mm; JLCPCB Part # C730237

Connections:
+3V3: C72.1, C73.1, C76.2, C77.1, U22.1 (VCCA), U23.1 (VCCA), U24.1 (VCCA), U25.1 (VCCA); also elsewhere on the board
+5V: C68.2, C69.2, C70.2, C71.2, C74.1, C75.2, J5.5, J5.7, J6.5, J6.7, R72.1, R73.1, R74.1, R75.1, R77.2, R78.2, TV14.1 (K), TV15.1 (K), U22.8 (VCCB), U23.8 (VCCB), U24.8 (VCCB), U25.8 (VCCB); also elsewhere on the board
/Control/AUX1_ENC_CH1: R92.1; also elsewhere on the board
/Control/AUX1_ENC_CH2: R93.1; also elsewhere on the board
/Control/AUX2_ENC_CH1: R86.1; also elsewhere on the board
/Control/AUX2_ENC_CH2: R87.1; also elsewhere on the board
/Control/JOINT_ENC_CH1: R85.1; also elsewhere on the board
/Control/JOINT_ENC_CH2: R84.1; also elsewhere on the board
/Control/JOINT_SW_L: R90.1; also elsewhere on the board
/Control/JOINT_SW_R: R91.1; also elsewhere on the board
/Encoders/JNT_ENC_A: J5.3, SB14.1 (A), TV11.1 (K), U22.6 (2B)
/Encoders/JNT_ENC_B: J5.4, SB15.1 (A), TV9.1 (K), U22.7 (1B)
/Encoders/JNT_ESTOP_A: J5.2, R76.1
/Encoders/JNT_ESTOP_B: J5.1, R80.1
/Encoders/JNT_SW_A: C66.2, R76.2, R79.1, TV6.1 (K), U24.7 (1B)
/Encoders/JNT_SW_B: C67.2, R80.2, R81.1, TV13.1 (K), U24.6 (2B)
/Encoders/S1_ENC_A: J6.4, SB13.1 (A), TV7.1 (K), U25.7 (1B)
/Encoders/S1_ENC_B: J6.3, SB12.1 (A), TV8.1 (K), U25.6 (2B)
/Encoders/S2_ENC_A: J6.2, SB11.1 (A), TV10.1 (K), U23.7 (1B)
/Encoders/S2_ENC_B: J6.1, SB10.1 (A), TV12.1 (K), U23.6 (2B)
GND: C66.1, C67.1, C68.1, C69.1, C70.1, C71.1, C72.2, C73.2, C74.2, C75.1, C76.1, C77.2, J5.6, J5.8, J6.6, J6.8, R82.1, R83.1, R88.1, R89.1, SB16.2 (B), SB17.2 (B), TV6.2 (A), TV7.2 (A), TV8.2 (A), TV9.2 (A), TV10.2 (A), TV11.2 (A), TV12.2 (A), TV13.2 (A), TV14.2 (A), TV15.2 (A), U22.4 (GND), U23.4 (GND), U24.4 (GND), U25.4 (GND); also elsewhere on the board
unnamed: R72.2, SB10.2 (B)
unnamed: R73.2, SB11.2 (B)
unnamed: R74.2, SB12.2 (B)
unnamed: R75.2, SB13.2 (B)
unnamed: R77.1, SB14.2 (B)
unnamed: R78.1, SB15.2 (B)
unnamed: R79.2, SB16.1 (A)
unnamed: R81.2, SB17.1 (A)
unnamed: R84.2, U22.2 (1A)
unnamed: R85.2, U22.3 (2A)
unnamed: R82.2, U22.5 (DIR)
unnamed: R86.2, U23.2 (1A)
unnamed: R87.2, U23.3 (2A)
unnamed: R83.2, U23.5 (DIR)
unnamed: R90.2, U24.2 (1A)
unnamed: R91.2, U24.3 (2A)
unnamed: R88.2, U24.5 (DIR)
unnamed: R92.2, U25.2 (1A)
unnamed: R93.2, U25.3 (2A)
unnamed: R89.2, U25.5 (DIR)

Notes on the sheet:
33R 1% 100mW
Encoder interfaces
