parkourlrc/pcb-tgiacomellibr--sjc-6abed6a295/hardware_v0.2/hardware_v0.2.kicad_pcb

## KiCad design hardware_v0.2/hardware_v0.2.kicad_pcb (continued)

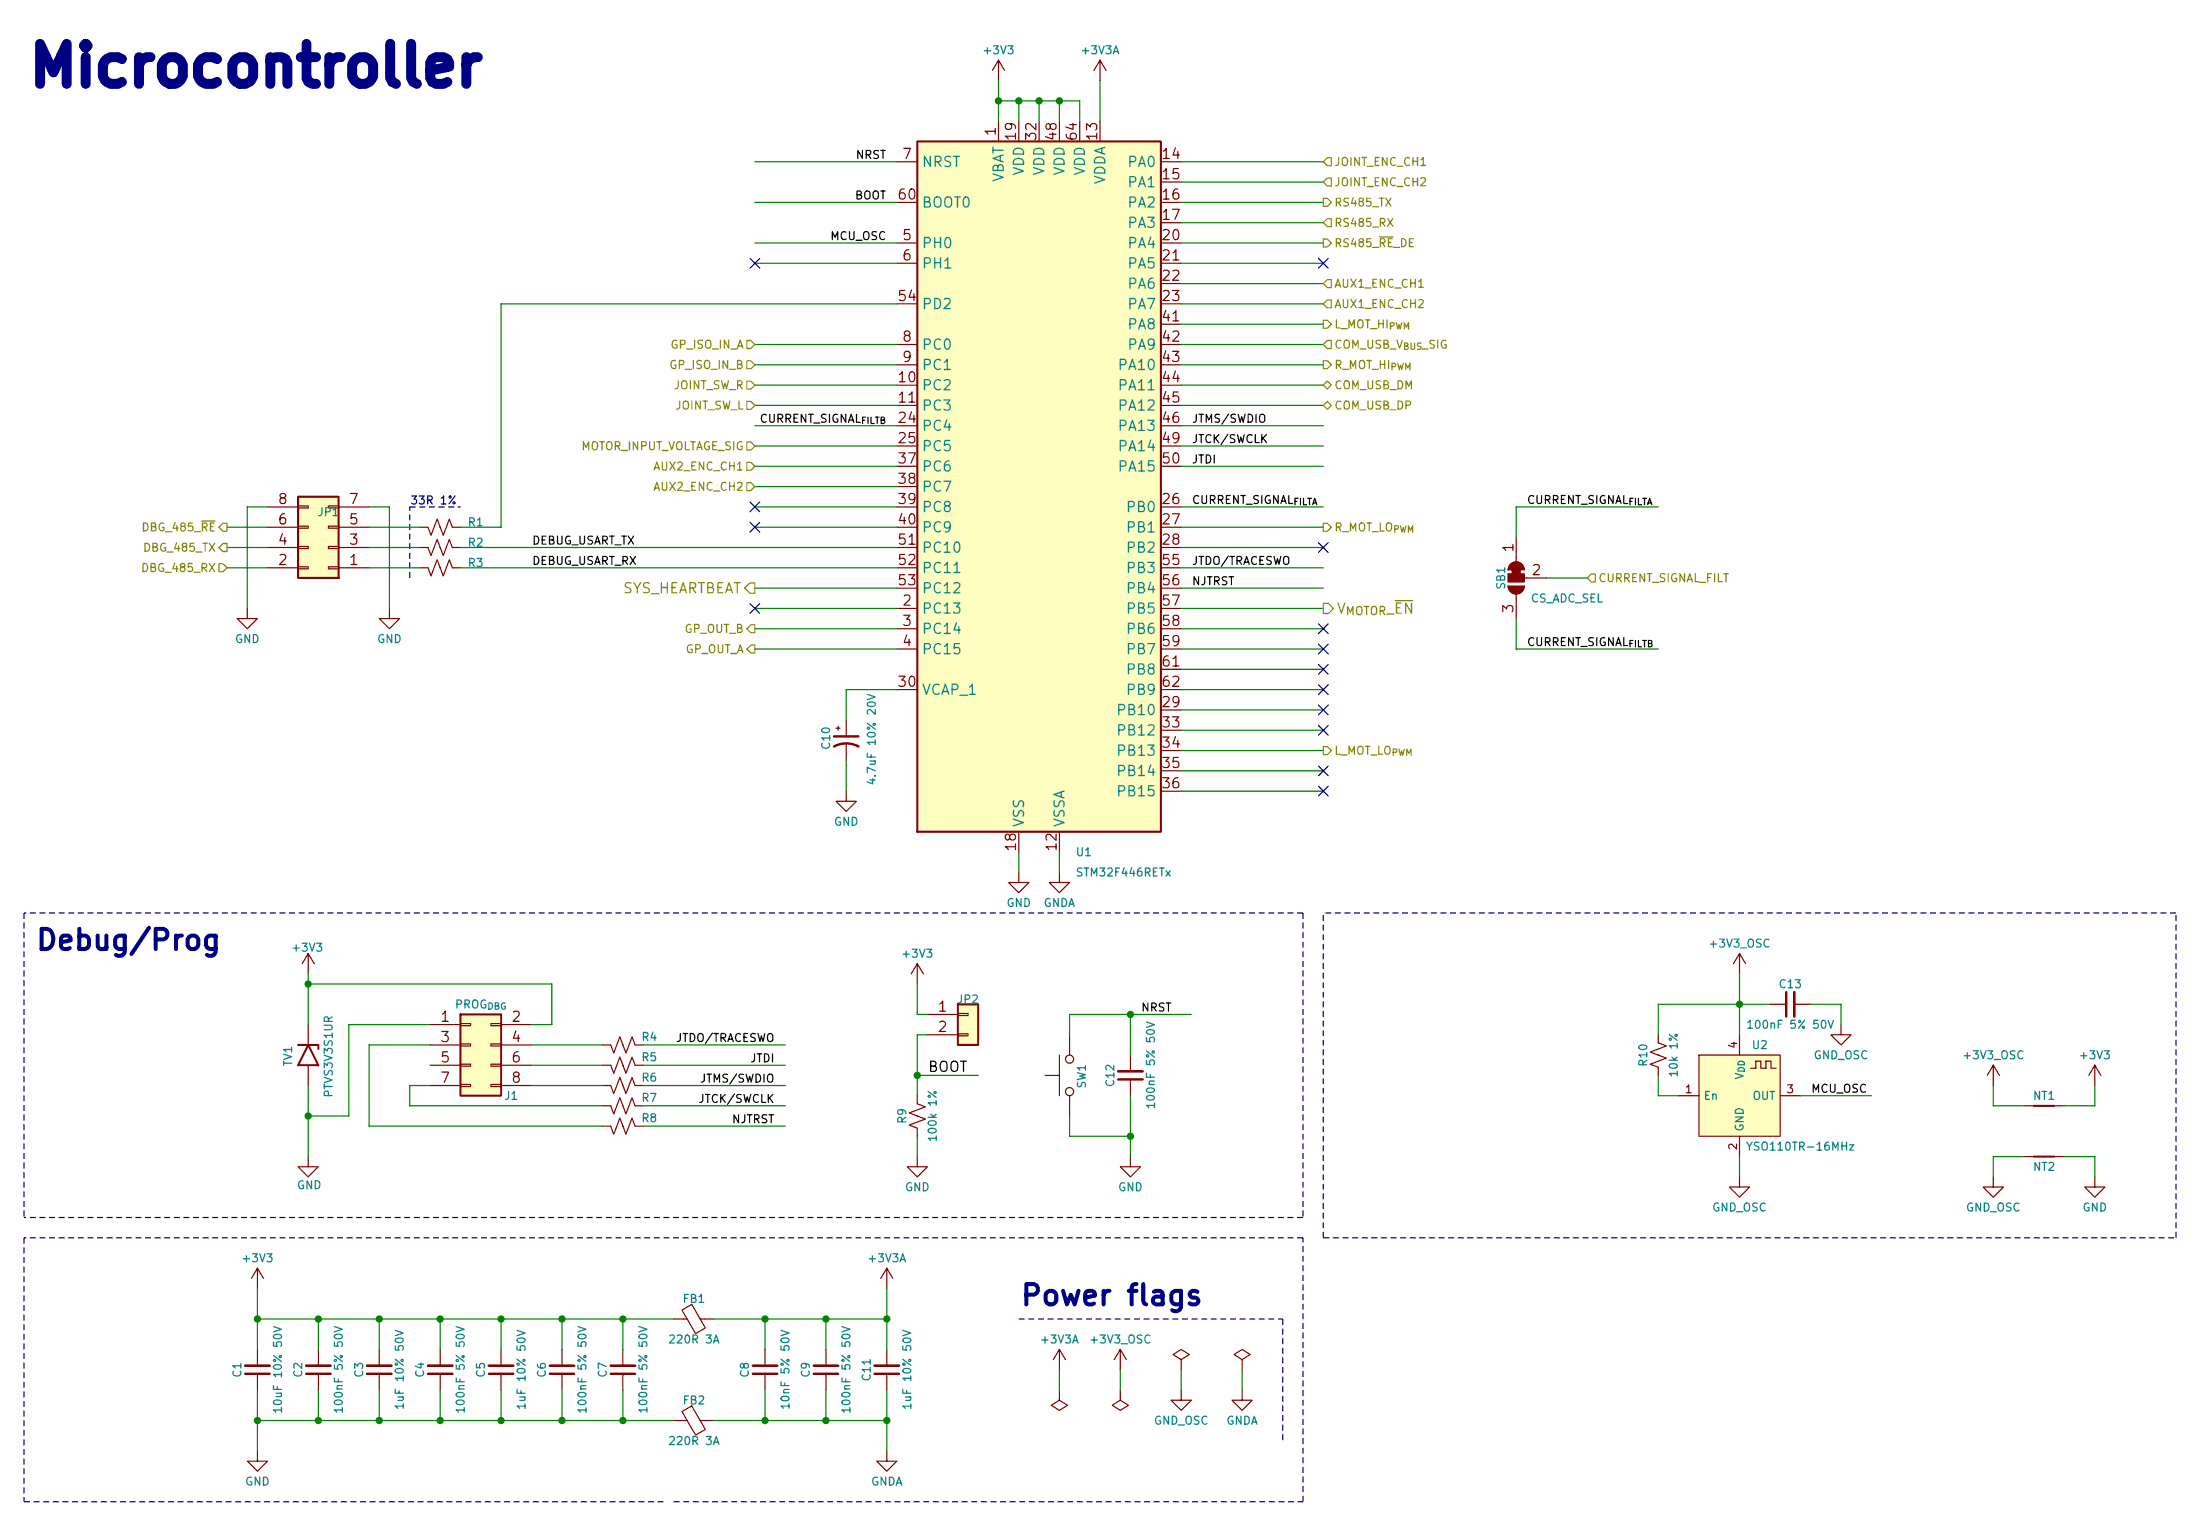
[picture p37: schematic control.kicad_sch, SJC Control]

Parts:
C1: 10uF 10% 50V; C_1206_3216Metric; JLCPCB Part # C13585
C2, C4, C6, C7, C9, C12, C13: 100nF 5% 50V; C_0603_1608Metric; JLCPCB Part # C91183
C3, C5, C11: 1uF 10% 50V; C_1206_3216Metric; JLCPCB Part # C1848
C8: 10nF 5% 50V; C_0603_1608Metric; JLCPCB Part # C389113
C10: 4.7uF 10% 20V; CP_EIA-3528-15_AVX-H_Pad1.50x2.35mm_HandSolder; JLCPCB Part # C308921
FB1, FB2: 220R 3A; L_0805_2012Metric_Pad1.05x1.20mm_HandSolder; JLCPCB Part # C76818
J1: PROG_{DBG}; PinHeader_2x04_P2.54mm_Vertical; JLCPCB Part # C2884546
JP1: DEBUG_OUT_SEL; PinHeader_2x04_P2.54mm_Vertical; JLCPCB Part # C234182
JP2: E-STOP_DIV; PinHeader_1x02_P2.54mm_Vertical; JLCPCB Part # C234182
NT1, NT2: NetTie-2_SMD_Pad0.5mm
R1, R2, R3, R4, R5, R6, R7, R8: 33R 1%; R_0603_1608Metric; JLCPCB Part # C108661
R9: 100k 1%; R_0603_1608Metric; JLCPCB Part # C14675
R10: 10k 1%; R_0603_1608Metric; JLCPCB Part # C98220
SB1: CS_ADC_SEL; SolderJumper-3_P1.3mm_Bridged2Bar12_RoundedPad1.0x1.5mm
SW1: Tactile Switch; SW_Tactile_SPST_NO_Straight_CK_PTS636Sx25SMTRLFS; JLCPCB Part # C2689642
TV1: PTVS3V3S1UR; D_SOD-123; JLCPCB Part # C183521
U1: STM32F446RETx; LQFP-64_10x10mm_P0.5mm; JLCPCB Part # C69336
U2: YSO110TR-16MHz; Oscillator_SMD_YXC_YSO110TR_7050-4Pin_7.0x5.0mm; JLCPCB Part # C669093

Connections:
+3V3: C1.2, C2.2, C3.2, C4.2, C5.2, C6.2, C7.2, FB1.1, J1.2, JP2.1, NT1.1, TV1.1 (K), U1.1 (VBAT), U1.19 (VDD), U1.32 (VDD), U1.48 (VDD), U1.64 (VDD); also elsewhere on the board
+3V3A: C8.2, C9.2, C11.2, FB1.2, U1.13 (VDDA)
+3V3_OSC: C13.1, NT1.2, R10.2, U2.4 (V_{DD})
/Communication/COM_USB_D+: U1.45 (PA12); also elsewhere on the board
/Communication/COM_USB_D-: U1.44 (PA11); also elsewhere on the board
/Communication/COM_USB_V_{BUS}_SIG: U1.42 (PA9); also elsewhere on the board
/Communication/RS485_RX: U1.17 (PA3); also elsewhere on the board
/Communication/RS485_TX: U1.16 (PA2); also elsewhere on the board
/Communication/RS485_~RE_DE: U1.20 (PA4); also elsewhere on the board
/Control/AUX1_ENC_CH1: U1.22 (PA6); also elsewhere on the board
/Control/AUX1_ENC_CH2: U1.23 (PA7); also elsewhere on the board
/Control/AUX2_ENC_CH1: U1.37 (PC6); also elsewhere on the board
/Control/AUX2_ENC_CH2: U1.38 (PC7); also elsewhere on the board
/Control/BOOT: JP2.2, R9.2, U1.60 (BOOT0)
/Control/CURRENT_SIGNAL_FILT: SB1.2 (C); also elsewhere on the board
/Control/CURRENT_SIGNAL_{FILTA}: SB1.1 (A), U1.26 (PB0)
/Control/CURRENT_SIGNAL_{FILTB}: SB1.3 (B), U1.24 (PC4)
/Control/DBG_485_RX: JP1.2; also elsewhere on the board
/Control/DBG_485_TX: JP1.4; also elsewhere on the board
/Control/DBG_485_~RE: JP1.6; also elsewhere on the board
/Control/DEBUG_USART_RX: R3.1, U1.52 (PC11)
/Control/DEBUG_USART_TX: R2.1, U1.51 (PC10)
/Control/GP_ISO_IN_A: U1.8 (PC0); also elsewhere on the board
/Control/GP_ISO_IN_B: U1.9 (PC1); also elsewhere on the board
/Control/GP_OUT_A: U1.4 (PC15); also elsewhere on the board
/Control/GP_OUT_B: U1.3 (PC14); also elsewhere on the board
/Control/JOINT_ENC_CH1: U1.14 (PA0); also elsewhere on the board
/Control/JOINT_ENC_CH2: U1.15 (PA1); also elsewhere on the board
/Control/JOINT_SW_L: U1.11 (PC3); also elsewhere on the board
/Control/JOINT_SW_R: U1.10 (PC2); also elsewhere on the board
/Control/JTCK/SWCLK: R7.1, U1.49 (PA14)
/Control/JTDI: R5.1, U1.50 (PA15)
/Control/JTDO/TRACESWO: R4.1, U1.55 (PB3)
/Control/JTMS/SWDIO: R6.1, U1.46 (PA13)
/Control/L_MOT_HI_{PWM}: U1.41 (PA8); also elsewhere on the board
/Control/L_MOT_LO_{PWM}: U1.34 (PB13); also elsewhere on the board
/Control/MCU_OSC: U1.5 (PH0), U2.3 (OUT)
/Control/MOTOR_INPUT_VOLTAGE_SIG: U1.25 (PC5); also elsewhere on the board
/Control/NJTRST: R8.1, U1.56 (PB4)
/Control/NRST: C12.2, SW1.2, U1.7 (NRST)
/Control/R_MOT_HI_{PWM}: U1.43 (PA10); also elsewhere on the board
/Control/R_MOT_LO_{PWM}: U1.27 (PB1); also elsewhere on the board
/Control/SYS_HEARTBEAT: U1.53 (PC12); also elsewhere on the board
/Control/V_{MOTOR}_~EN: U1.57 (PB5); also elsewhere on the board
GND: C1.1, C2.1, C3.1, C4.1, C5.1, C6.1, C7.1, C10.2, C12.1, FB2.1, J1.1, JP1.7, JP1.8, NT2.2, R9.1, SW1.1, TV1.2 (A), U1.18 (VSS), U1.31 (VSS), U1.47 (VSS), U1.63 (VSS); also elsewhere on the board
GNDA: C8.1, C9.1, C11.1, FB2.2, U1.12 (VSSA)
GND_OSC: C13.2, NT2.1, U2.2 (GND)
unnamed: J1.3, R8.2
unnamed: J1.4, R4.2
unnamed: J1.6, R5.2
unnamed: J1.7, R7.2
unnamed: J1.8, R6.2
unnamed: JP1.1, R3.2
unnamed: JP1.3, R2.2
unnamed: JP1.5, R1.2
unnamed: R1.1, U1.54 (PD2)
unnamed: C10.1, U1.30 (VCAP_1)
unnamed: R10.1, U2.1 (En)

Notes on the sheet:
Microcontroller
33R 1%
Power flags
Debug/Prog

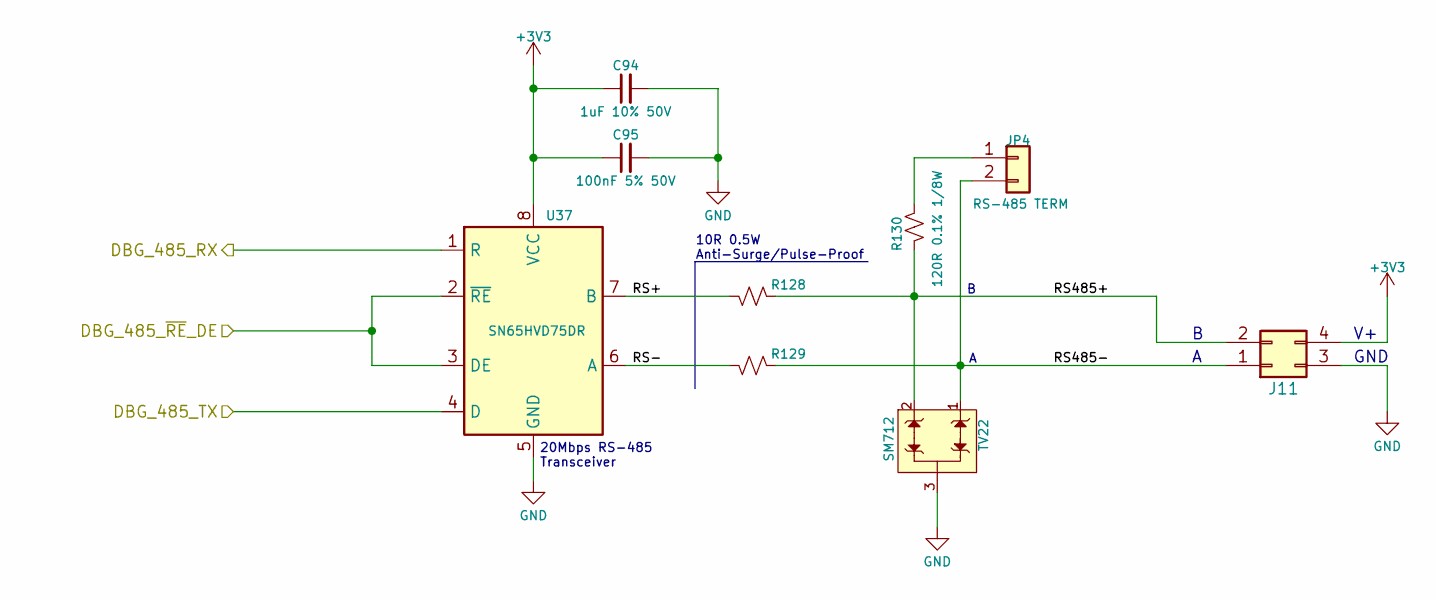
[picture p38: schematic Debug_Com.kicad_sch]

Parts:
C94: 1uF 10% 50V; C_1206_3216Metric; JLCPCB Part # C1848
C95: 100nF 5% 50V; C_0603_1608Metric; JLCPCB Part # C91183
J11: Debug-485; PinHeader_2x02_P2.54mm_Vertical
JP4: RS-485 TERM; PinHeader_1x02_P2.54mm_Vertical; JLCPCB Part # C234182
R128, R129: 10R 1% 1/2W; R_0805_2012Metric_Pad1.20x1.40mm_HandSolder; JLCPCB Part # C441969
R130: 120R 0.1% 1/8W; R_0805_2012Metric_Pad1.20x1.40mm_HandSolder; JLCPCB Part # C2828708
TV22: SM712; SOT-23-3; JLCPCB Part # C293966
U37: SN65HVD75DR; SOIC-8_3.9x4.9mm_P1.27mm; JLCPCB Part # C57928

Connections:
+3V3: C94.1, C95.1, J11.4, U37.8 (VCC); also elsewhere on the board
/Control/DBG_485_RX: U37.1 (R); also elsewhere on the board
/Control/DBG_485_TX: U37.4 (D); also elsewhere on the board
/Control/DBG_485_~RE: U37.2 (~RE), U37.3 (DE); also elsewhere on the board
/Debug/RS485+: J11.2, R128.1, R130.1, TV22.2
/Debug/RS485-: J11.1, JP4.2, R129.1, TV22.1
/Debug/RS+: R128.2, U37.7 (B)
/Debug/RS-: R129.2, U37.6 (A)
GND: C94.2, C95.2, J11.3, TV22.3, U37.5 (GND); also elsewhere on the board
unnamed: JP4.1, R130.2

Notes on the sheet:
10R 0.5W Anti-Surge/Pulse-Proof
GND
20Mbps RS-485 Transceiver

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
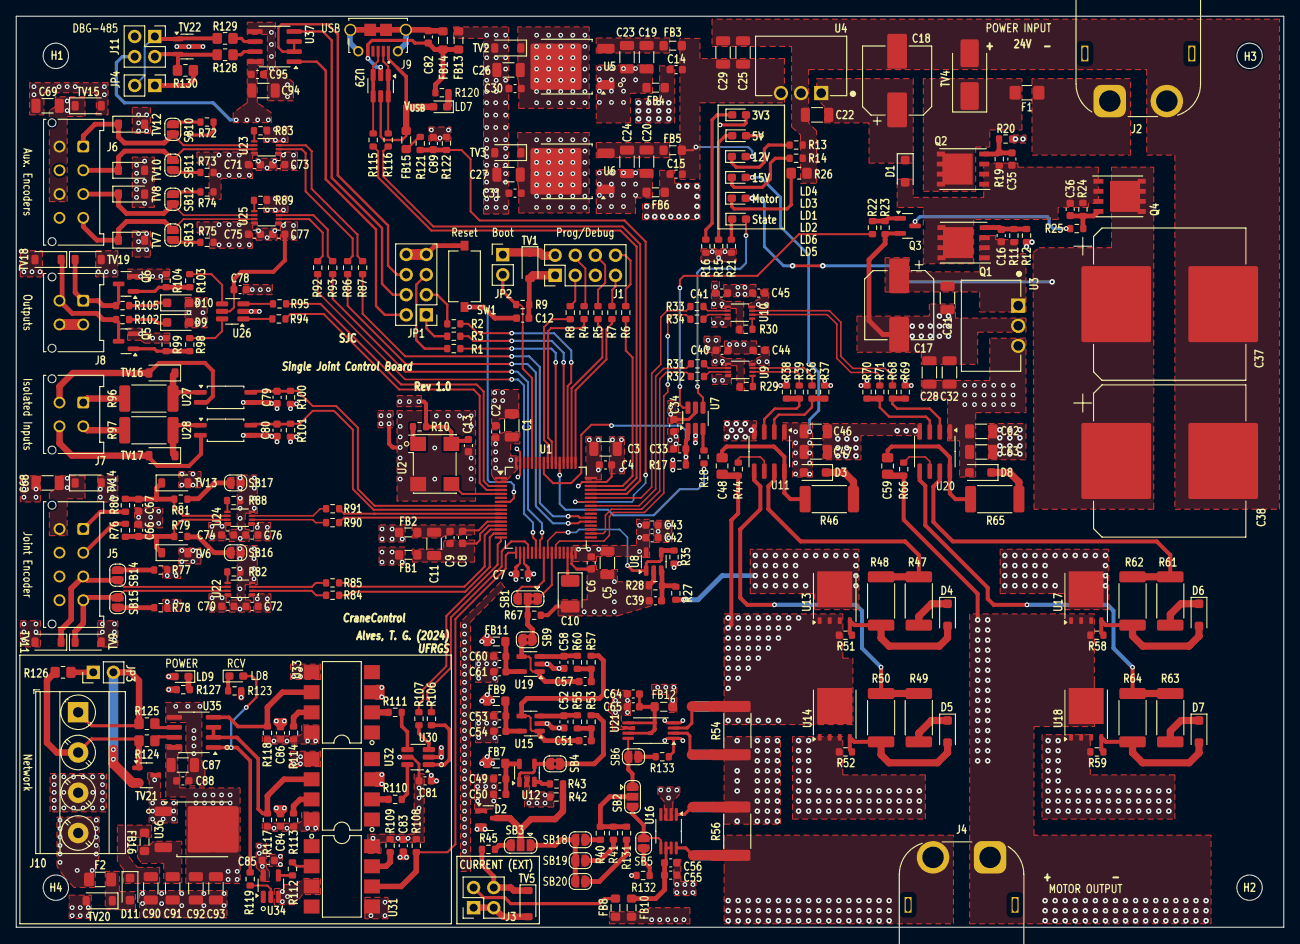
[picture p39: board hardware_v0.2.kicad_pcb from above]

Board: 4 copper layers, 160.0 x 115.0 mm, 375 parts (0 on the bottom side), 238 nets.

Other parts of the board:
R132, R133: 10k 1%; R_0603_1608Metric

Their connections:
GND: R132.1, R133.1; also elsewhere on the board
