parkourlrc/pcb-tgiacomellibr--sjc-6abed6a295/hardware/hardware.kicad_pcb

## KiCad design hardware/hardware.kicad_pcb (2023-06-06)

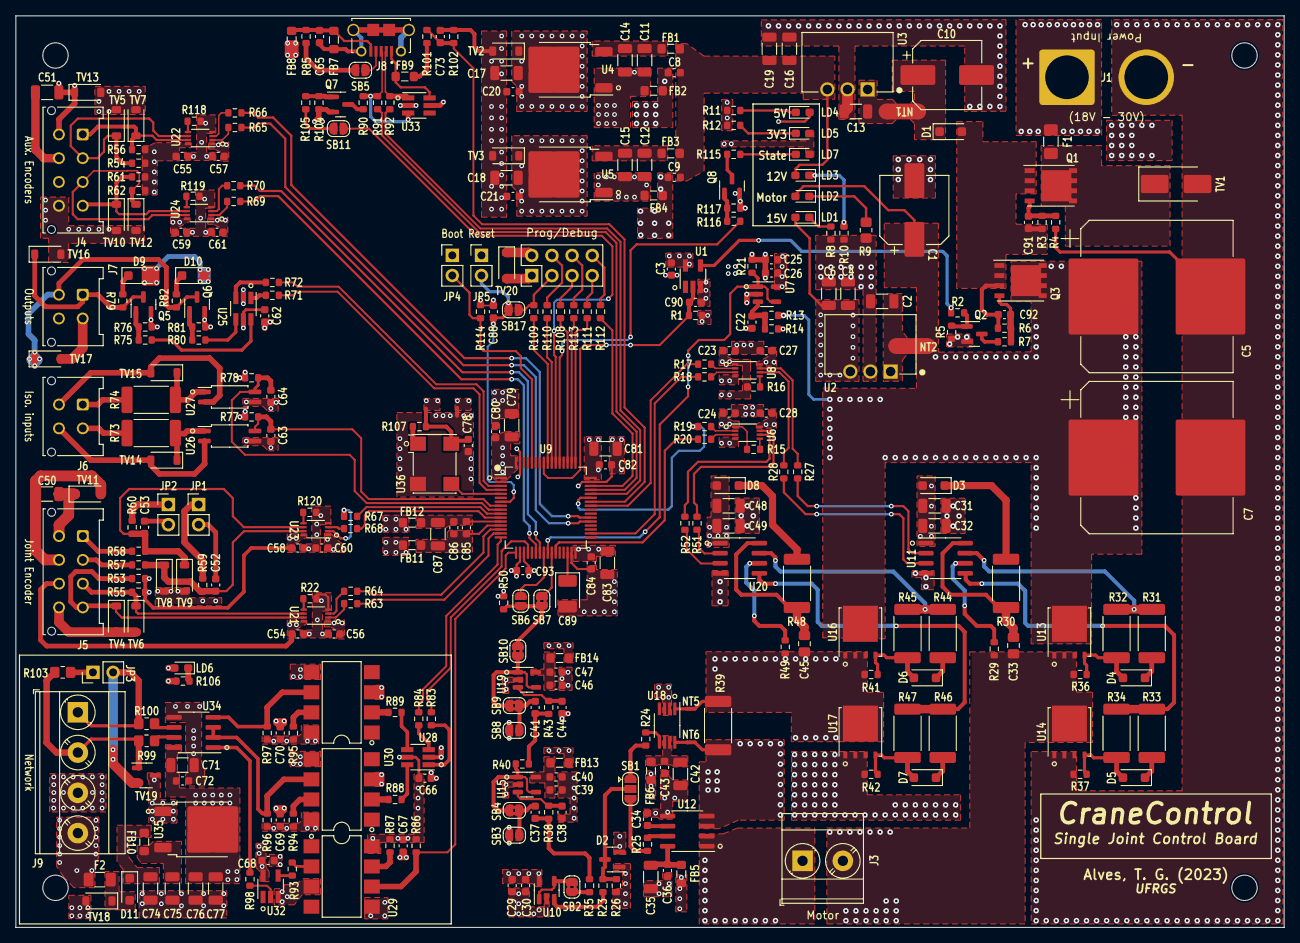
[picture p40: board hardware.kicad_pcb from above]

Board: 4 copper layers, 160.0 x 115.0 mm, 346 parts (0 on the bottom side), 216 nets.

Parts:
C1, C10: 47uF 63V 20%; CP_Elec_8x10.5
C2, C6, C11, C12, C13, C17, C18, C19, C31, C35, C42, C48, C75, C76, C79: 10uF 10% 50V; C_1206_3216Metric
C3, C8, C9, C20, C21, C23, C24, C25, C27, C28, C29, C36, C39, C43, C46, C54, C55, C56, C57, C58, C59, C60, C61, C62, C65, C66, C67, C68, C69, C70, C72, C73, C78, C80, C82, C84, C86, C88, C93: 100nF 5% 50V; C_0603_1608Metric
C4, C16: 22uF 10% 25V; C_1206_3216Metric
C5, C7: 680uF 63V 20%; CP_Elec_18x17.5
C14, C15, C32, C49, C50, C51, C71, C74, C77, C81, C83, C87: 1uF 10% 50V; C_1206_3216Metric
C22: 12nF 5% 50V; C_0603_1608Metric
C26, C30, C40, C47, C63, C64, C85, C90, C91, C92: 10nF 5% 50V; C_0603_1608Metric
C33, C45: 82nF 5% 50V; C_0805_2012Metric_Pad1.18x1.45mm_HandSolder
C34, C52, C53: 22nF 5% 50V; C_0603_1608Metric
C37, C38, C41, C44: 39nF 5% 50V; C_0603_1608Metric
C89: 4.7uF 10% 20V; CP_EIA-3528-15_AVX-H_Pad1.50x2.35mm_HandSolder
D1, D3, D8, D11: PMEG60T20ELR; D_SOD-123F
D2: BAT54S; SOT-23
D4, D5, D6, D7, D9, D10: PMEG60T10ELR; D_SOD-123F
F1: 25A 32V; Fuse_1206_3216Metric_Pad1.42x1.75mm_HandSolder
F2: 60V 100mA; Fuse_1206_3216Metric
FB1, FB2, FB3, FB4, FB5, FB6, FB7, FB8, FB9, FB10, FB11, FB12, FB13, FB14: 220R 3A; L_0805_2012Metric_Pad1.05x1.20mm_HandSolder
H1, H2, H3, H4: MountingHole; MountingHole_3.2mm_M3_ISO7380
J1: V_{POWER}; SolderWire-16.8sqmm_1x02_P10.0mm_D5.5mm_OD7.0mm
J3: Motor; TerminalBlock_Phoenix_MKDS-3-2-5.08_1x02_P5.08mm_Horizontal
J4: Aux. encoders; Molex_Micro-Fit_3.0_43045-0812_2x04_P3.00mm_Vertical
J5: Joint encoders; Molex_Micro-Fit_3.0_43045-0812_2x04_P3.00mm_Vertical
J6: Isolated Inputs; Molex_Micro-Fit_3.0_43045-0412_2x02_P3.00mm_Vertical
J7: Outputs; Molex_Micro-Fit_3.0_43045-0412_2x02_P3.00mm_Vertical
J8: AMPHENOL_10118194-0001LF
J9: RS-485; TerminalBlock_Phoenix_MKDS-3-4-5.08_1x04_P5.08mm_Horizontal
J10: PROG_{DBG}; PinHeader_2x04_P2.54mm_Vertical
JP1, JP2, JP4, JP5: E-STOP_DIV; PinHeader_1x02_P2.54mm_Vertical
JP3: RS-485 TERM; PinHeader_1x02_P2.54mm_Vertical
LD1, LD2, LD3, LD4, LD5, LD6, LD7: 1.8V @ 5mA; LED_0603_1608Metric_Pad1.05x0.95mm_HandSolder
NT1, NT2: PWR-DRV; NetTie-2_SMD_Pad2.0mm
NT3: 3V3_OSC; NetTie-2_SMD_Pad0.5mm
NT4: GND_OSC; NetTie-2_SMD_Pad0.5mm
NT5: SHUNT IN-; NetTie-2_SMD_Pad0.5mm
NT6: SHUNT IN+; NetTie-2_SMD_Pad0.5mm
Q1, Q3: SI7149ADP; PowerPAK_SO-8_Single
Q2, Q5, Q6, Q8: NDS7002A; SOT-23
Q7: BSS84; SOT-23
R1, R3, R5, R6, R13, R36, R37, R41, R42, R76, R81, R85, R104, R114, R117: 100k 1%; R_0603_1608Metric
R2, R21, R59, R60, R75, R80, R86, R96, R97, R105, R116: 1k 1%; R_0603_1608Metric
R4, R7, R102: 82k 0.1%; R_0603_1608Metric
R8, R15, R16, R22, R53, R54, R55, R56, R61, R62, R87, R94, R95, R118, R119, R120: 2k7 1%; R_0603_1608Metric
R9: 5.62k 5% 250mW; R_0805_2012Metric_Pad1.20x1.40mm_HandSolder
R10, R77, R78, R79, R82: 2k 5%; R_0603_1608Metric
R11: 680R 1%; R_0603_1608Metric
R12, R106, R115: 330R 1%; R_0603_1608Metric
R14, R23, R107: 10k 1%; R_0603_1608Metric
R17, R18, R19, R20, R27, R28, R51, R52, R63, R64, R65, R66, R67, R68, R69, R70, R71, R72, R83, R84, R98, R108, R109, R110, R111, R112, R113: 33R 1%; R_0603_1608Metric
R24: 270R 0.1%; R_0603_1608Metric
R25: 510R 0.1%; R_0603_1608Metric
R26, R35, R38, R40, R43, R50: 1.02k 0.1%; R_0603_1608Metric
R29, R49: 0R; R_0603_1608Metric
R30, R48: 2R 5% 2W; R_2512_6332Metric_Pad1.40x3.35mm_HandSolder
R31, R33, R44, R46: 2.4R 1% 1W; R_2512_6332Metric_Pad1.40x3.35mm_HandSolder
R32, R34, R45, R47: 130R 1% 1W; R_2512_6332Metric_Pad1.40x3.35mm_HandSolder
R39: 8mR 1% 2W; R_2512_6332Metric_Pad1.40x3.35mm_HandSolder
R57, R58, R90: 1.5k 1%; R_0603_1608Metric
R73, R74: 1.6k 5% 1W; R_2512_6332Metric_Pad1.40x3.35mm_HandSolder
R88, R89, R93: 160R 5% 1/8W; R_0603_1608Metric
R91, R92: 22R 1%; R_0603_1608Metric
R99, R100: 10R 1% 1/2W; R_0805_2012Metric_Pad1.20x1.40mm_HandSolder
R101: 47k 0.1%; R_0603_1608Metric
R103: 120R 0.1% 1/8W; R_0805_2012Metric_Pad1.20x1.40mm_HandSolder
SB1: CS_SEL; SolderJumper-3_P1.3mm_Open_RoundedPad1.0x1.5mm
SB2, SB4, SB7, SB9, SB10: SolderJumper-2_P1.3mm_Bridged2Bar_RoundedPad1.0x1.5mm
SB3, SB5, SB6, SB8, SB11, SB17: SolderJumper-2_P1.3mm_Open_RoundedPad1.0x1.5mm
TV1: SMBJ30A; D_SMB_Handsoldering
TV2, TV5, TV7, TV8, TV9, TV10, TV12, TV13: PTVS5V0S1UR; D_SOD-123
TV3, TV20: PTVS3V3S1UR; D_SOD-123
TV4, TV6, TV11, TV16, TV17, TV18: PTVS12VS1UR; D_SOD-123
TV14, TV15: PTVS30VS1UR; D_SOD-123
TV19: SM712; SOT-23-3
U1, U32: SN74LVC1G04DBVR; SOT-23-5_HandSoldering
U2: VXO78015-1000; CONV_VXO78015-1000
U3: VXO78012-1000; CONV_VXO78012-1000
U4: NCP1117DT50; TO-252-2
U5, U35: NCP1117DT33; TO-252-2
U6, U8, U21, U22, U23, U24: 74LVC2T45DC; VSSOP-8_2.3x2mm_P0.5mm
U7, U10, U15, U19: TLV9051; SOT-23-5
U9: STM32F446RETx; LQFP-64_10x10mm_P0.5mm
U11, U20: FAN7382; SOIC-8_3.9x4.9mm_P1.27mm
U12: ACS712-20A; SOIC-8_3.9x4.9mm_P1.27mm
U13, U14, U16, U17: BSC0902NSI; TDSON-8-1
U18: AD8418; MSOP-8_3x3mm_P0.65mm
U25, U28: SN74LVC2G04; SOT-23-6_Handsoldering
U26, U27: TLP291; SOP-4_4.4x2.6mm_P1.27mm
U29, U30, U31: 6N137; SMDIP-8_W7.62mm
U33: USBLC6-4SC6; SOT-23-6_Handsoldering
U34: SN65HVD75DR; SOIC-8_3.9x4.9mm_P1.27mm
U36: YSO110TR-16MHz; Oscillator_SMD_YXC_YSO110TR_7050-4Pin_7.0x5.0mm

Connections:
+3V3: C3.1, C18.2, C21.2, C23.2, C24.2, C25.1, C26.1, C29.1, C30.1, C56.1, C57.1, C60.2, C61.1, C62.1, C66.1, C67.1, C79.2, C80.2, C81.2, C82.2, C83.2, C84.2, C93.2, D2.2, FB11.1, FB13.2, FB14.2, J10.2, JP4.1, LD5.2 (A), LD7.2 (A), NT3.2, Q7.2 (S), R1.2, R15.2, R16.2, R77.2, R78.2, R86.2, R87.2, R104.2, TV3.1 (K), TV20.1 (K), U1.5 (VCC), U5.2 (VO), U6.1 (VCCA), U7.5 (V+), U8.1 (VCCA), U9.1 (VBAT), U9.19 (VDD), U9.32 (VDD), U9.48 (VDD), U9.64 (VDD), U10.5 (V+), U21.1 (VCCA), U22.1 (VCCA), U23.1 (VCCA), U24.1 (VCCA), U25.5 (V_{CC}), U28.5 (V_{CC}), U29.8 (VCC)
+3V3A: C85.2, C86.2, C87.2, FB11.2, U9.13 (VDDA)
+3V3_ISO: C68.1, C69.1, C70.1, C71.1, C72.1, C76.2, C77.2, LD6.2 (A), R94.2, R95.2, R96.2, R97.2, U30.8 (VCC), U31.8 (VCC), U32.5 (VCC), U34.8 (VCC), U35.2 (VO)
+3V3_OSC: C78.1, NT3.1, R107.2, U36.4 (V_{DD})
+5V: C17.2, C20.2, C27.1, C28.1, C50.2, C51.2, C54.2, C55.2, C58.1, C59.2, D9.2 (A), D10.2 (A), FB5.1, FB6.1, J4.5, J4.7, J5.5, J5.7, LD4.2 (A), R53.2, R54.2, R55.2, R56.2, R61.2, R62.2, TV2.1 (K), TV11.1 (K), TV13.1 (K), U4.2 (VO), U6.8 (VCCB), U8.8 (VCCB), U21.8 (VCCB), U22.8 (VCCB), U23.8 (VCCB), U24.8 (VCCB), U33.5 (VBUS)
+5V_USB: FB9.2, J8.1 (VBUS), U33.6 (I/O4)
+12V: C8.2, C9.2, C16.2, C19.2, FB1.2, FB3.1, LD3.2 (A), U3.3 (+V_{OUT})
+12V_ISO: F2.1, J9.4
+15V: C4.2, C6.2, C31.1, C32.1, C48.2, C49.2, D3.2 (A), D8.2 (A), LD1.2 (A), U2.3 (+V_{OUT}), U11.1 (V_{CC}), U20.1 (V_{CC})
/Communication/+12V_ISO_DC: C74.2, D11.1 (K), FB10.2
/Communication/+12V_ISO_FLT: C75.2, FB10.1, U35.3 (VI)
/Communication/COM_USB_D+: R91.1, U9.45 (PA12)
/Communication/COM_USB_D-: R92.1, U9.44 (PA11)
/Communication/COM_USB_PU: SB11.1 (A), U9.54 (PD2)
/Communication/COM_USB_V_{BUS}_SIG: C73.2, R101.2, R102.2, U9.42 (PA9)
/Communication/ISO_RX: R98.2, U32.2 (A)
/Communication/ISO_TX: R97.1, U31.6 (VO), U34.4 (D)
/Communication/ISO_~RE_DE: R96.1, U30.6 (VO), U34.2 (~RE), U34.3 (DE)
/Communication/RS485+: J9.2, R99.1, R103.1, TV19.1
/Communication/RS485-: J9.1, JP3.2, R100.1, TV19.2
/Communication/RS485_RX: R86.1, U9.17 (PA3), U29.6 (VO)
/Communication/RS485_TX: R84.2, U9.16 (PA2)
/Communication/RS485_~RE_DE: R83.2, U9.20 (PA4)
/Communication/RS+: R99.2, U34.7 (B)
/Communication/RS-: R100.2, U34.6 (A)
/Communication/USB_D+: J8.3 (D+), R90.1, R91.2, U33.3 (I/O2)
/Communication/USB_D-: J8.2 (D-), R92.2, U33.1 (I/O1)
/Communication/USB_DP_PU: Q7.3 (D), R90.2
/Control/AUX1_ENC_CH1: R69.1, U9.22 (PA6)
/Control/AUX1_ENC_CH2: R70.1, U9.23 (PA7)
/Control/AUX2_ENC_CH1: R65.1, U9.37 (PC6)
/Control/AUX2_ENC_CH2: R66.1, U9.38 (PC7)
/Control/BOOT: JP4.2, R114.2, U9.60 (BOOT0)
/Control/CURRENT_SIGNAL_FILT: R50.2, SB6.2 (B), SB7.2 (B), SB10.2 (B)
/Control/DEBUG_USART_TX: R108.1, U9.51 (PC10)
/Control/GP_ISO_IN_A: C63.2, R77.1, U9.8 (PC0), U26.4
/Control/GP_ISO_IN_B: C64.2, R78.1, U9.9 (PC1), U27.4
/Control/GP_OUT_A: R71.2, U9.4 (PC15)
/Control/GP_OUT_B: R72.2, U9.3 (PC14)
/Control/JOINT_ENC_CH1: R64.1, U9.14 (PA0)
/Control/JOINT_ENC_CH2: R63.1, U9.15 (PA1)
/Control/JOINT_SW_L: R67.1, U9.10 (PC2)
/Control/JOINT_SW_R: R68.1, U9.11 (PC3)
/Control/JTCK/SWCLK: R111.1, U9.49 (PA14)
/Control/JTDI: R113.1, U9.50 (PA15)
/Control/JTDO/TRACESWO: R110.1, U9.55 (PB3)
/Control/JTMS/SWDIO: R112.1, U9.46 (PA13)
/Control/L_MOT_HI_{PWM}: R17.2, U9.41 (PA8)
/Control/L_MOT_LO_{PWM}: R18.2, U9.34 (PB13)
/Control/MCU_OSC: U9.5 (PH0), U36.3 (OUT)
/Control/MOTOR_INPUT_VOLTAGE_SIG: R21.2, U7.1, U7.4 (-), U9.25 (PC5)
/Control/NJTRST: R109.1, U9.56 (PB4)
/Control/NRST: C88.2, JP5.2, SB17.2 (B), U9.7 (NRST)
/Control/R_MOT_HI_{PWM}: R19.2, U9.43 (PA10)
/Control/R_MOT_LO_{PWM}: R20.2, U9.27 (PB1)
/Control/SYS_HEARTBEAT: R116.2, U9.53 (PC12)
/Control/V_{MOTOR}_~EN: C90.2, R1.1, U1.2 (A), U9.57 (PB5)
/Encoders/JNT_ENC_A: J5.3, R55.1, TV6.1 (K), U21.6 (2B)
/Encoders/JNT_ENC_B: J5.4, R53.1, TV4.1 (K), U21.7 (1B)
/Encoders/JNT_ESTOP_A: J5.2, R57.1
/Encoders/JNT_ESTOP_B: J5.1, R58.1
/Encoders/JNT_SW_A: C52.2, R57.2, R59.2, TV8.1 (K), U23.7 (1B)
/Encoders/JNT_SW_B: C53.2, R58.2, R60.2, TV9.1 (K), U23.6 (2B)
/Encoders/S1_ENC_A: J4.3, R62.1, TV12.1 (K), U24.7 (1B)
/Encoders/S1_ENC_B: J4.4, R61.1, TV10.1 (K), U24.6 (2B)
/Encoders/S2_ENC_A: J4.1, R56.1, TV7.1 (K), U22.7 (1B)
/Encoders/S2_ENC_B: J4.2, R54.1, TV5.1 (K), U22.6 (2B)
/GPIOs/ISO_IN_A: J6.2, R73.2
/GPIOs/ISO_IN_A_{COM}: J6.4, TV14.2 (A), U26.2
/GPIOs/ISO_IN_B: J6.1, R74.2
/GPIOs/ISO_IN_B_{COM}: J6.3, TV15.2 (A), U27.2
/GPIOs/OUT_A: J7.1, Q5.3 (D), R79.1, TV16.1 (K)
/GPIOs/OUT_B: J7.3, Q6.3 (D), R82.1, TV17.1 (K)
/Motor/CS_MEAS: R23.2, U10.3 (+)
/Motor/CS_MEAS_ACS712: R25.1, U12.7 (VIOUT)
/Motor/CS_MEAS_AD8418: R24.1, U18.5 (OUT)
/Motor/CS_MEAS_PRE_FILT: SB2.1 (A), U10.1, U10.4 (-)
/Motor/DC_MOT_T1: C33.1, J3.2, R29.2, R36.1, U13.1 (S), U13.2 (S), U13.3 (S), U14.5 (D)
/Motor/DC_MOT_T1_RET: J3.1, U12.1 (IP+), U12.2 (IP+)
/Motor/DC_MOT_T1_SHUNT: NT6.1, R39.1, U12.3 (IP-), U12.4 (IP-)
/Motor/DC_MOT_T2: C45.1, NT5.1, R39.2, R41.1, R49.2, U16.1 (S), U16.2 (S), U16.3 (S), U17.5 (D)
/Motor/L_HSG: D4.2 (A), R32.1, R36.2, U13.4 (G)
/Motor/L_PWM: R27.2, U8.7 (1B)
/Motor/R_HSG: D6.2 (A), R41.2, R45.1, U16.4 (G)
/Motor/R_PWM: R51.2, U6.7 (1B)
/Motor/~L_PWM: R28.2, U8.6 (2B)
/Motor/~R_PWM: R52.2, U6.6 (2B)
/Power Supply/15V_REG_IN: C2.2, NT2.2, U2.1 (+V_{IN})
GND: C3.2, C11.1, C12.1, C14.1, C15.1, C17.1, C18.1, C20.1, C21.1, C22.1, C23.1, C24.1, C25.2, C26.2, C27.2, C28.2, C29.2, C30.2, C34.1, C35.2, C36.2, C38.1, C39.2, C40.2, C42.2, C43.2, C44.1, C46.2, C47.2, C50.1, C51.1, C52.1, C53.1, C54.1, C55.1, C56.2, C57.2, C58.2, C59.1, C60.1, C61.2, C62.2, C63.1, C64.1, C66.2, C67.2, C73.1, C79.1, C80.1, C81.1, C82.1, C83.1, C84.1, C88.1, C89.2, C90.1, C93.1, D2.1, FB2.1, FB4.1, FB8.1, FB12.1, J4.6, J4.8, J5.6, J5.8, J7.2, J7.4, J10.1, JP1.2, JP2.2, JP5.1, NT4.2, Q5.2 (S), Q6.2 (S), Q8.2 (S), R11.2, R12.2, R14.1, R21.1, R22.1, R26.1, R50.1, R76.1, R81.1, R102.1, R114.1, R117.1, R118.1, R119.1, R120.1, SB3.2 (B), SB8.2 (B), TV2.2 (A), TV3.2 (A), TV4.2 (A), TV5.2 (A), TV6.2 (A), TV7.2 (A), TV8.2 (A), TV9.2 (A), TV10.2 (A), TV11.2 (A), TV12.2 (A), TV13.2 (A), TV16.2 (A), TV17.2 (A), TV20.2 (A), U1.3 (GND), U4.1 (GND), U5.1 (GND), U6.4 (GND), U7.2 (V-), U8.4 (GND), U9.18 (VSS), U9.31 (VSS), U9.47 (VSS), U9.63 (VSS), U10.2 (V-), U12.5 (GND), U15.2 (V-), U18.2 (GND), U18.3 (REF2), U19.2 (V-), U21.4 (GND), U22.4 (GND), U23.4 (GND), U24.4 (GND), U25.2 (GND), U26.3, U27.3, U28.2 (GND), U29.5 (GND), U30.3 (C), U31.3 (C), U33.2 (GND)
GNDA: C85.1, C86.1, C87.1, FB12.2, U9.12 (VSSA)
GND_ISO: C68.2, C69.2, C70.2, C71.2, C72.2, C74.1, C75.1, C76.1, C77.1, J9.3, R106.2, TV18.2 (A), TV19.3, U29.3 (C), U30.5 (GND), U31.5 (GND), U32.3 (GND), U34.5 (GND), U35.1 (GND)
GND_OSC: C78.2, NT4.1, U36.2 (GND)
GND_USB: C65.1, FB7.2, FB8.2, J8.5 (GND), R85.1
unnamed: C37.2, R35.2, R38.1
unnamed: C41.2, R40.2, R43.1
unnamed: C65.2, FB7.1, J8.S1 (Shield), J8.S2 (Shield), J8.S3 (Shield), J8.S4 (Shield), J8.S5 (Shield), J8.S6 (Shield)
unnamed: C10.1, D1.1 (K), NT1.1
unnamed: D3.1 (K), R30.2
unnamed: D4.1 (K), R31.1
unnamed: D5.2 (A), R34.1, R37.2, U14.4 (G)
unnamed: D5.1 (K), R33.1
unnamed: D6.1 (K), R44.1
unnamed: D7.2 (A), R42.2, R47.1, U17.4 (G)
unnamed: D7.1 (K), R46.1
unnamed: D8.1 (K), R48.2
unnamed: D9.1 (K), R79.2
unnamed: D10.1 (K), R82.2
unnamed: D11.2 (A), F2.2, TV18.1 (K)
unnamed: FB9.1, R101.1
unnamed: J8.4 (ID), SB5.1 (A)
unnamed: J10.3, R109.2, SB17.1 (A)
unnamed: J10.4, R110.2
unnamed: J10.5, R108.2
unnamed: J10.6, R113.2
unnamed: J10.7, R111.2
unnamed: J10.8, R112.2
unnamed: JP1.1, R59.1
unnamed: JP2.1, R60.1
unnamed: JP3.1, R103.2
unnamed: LD1.1 (K), R8.1
unnamed: LD2.1 (K), R9.1
unnamed: LD3.1 (K), R10.1
unnamed: LD4.1 (K), R11.1
unnamed: LD5.1 (K), R12.1
unnamed: LD6.1 (K), R106.1
unnamed: LD7.1 (K), R115.1
unnamed: C91.1, Q1.4 (G), R3.1, R4.2
unnamed: Q2.3 (D), R7.1
unnamed: Q2.1 (G), R2.1, R5.2
unnamed: C92.1, Q3.4 (G), R6.1, R7.2
unnamed: Q5.1 (G), R75.1, R76.2
unnamed: Q6.1 (G), R80.1, R81.2
unnamed: Q7.1 (G), R104.1, R105.2
unnamed: Q8.3 (D), R115.2
unnamed: Q8.1 (G), R116.1, R117.2
unnamed: R24.2, SB1.1 (A)
unnamed: R25.2, SB1.3 (B)
unnamed: D2.3, R23.1, R26.2, SB1.2 (C)
unnamed: R35.1, SB2.2 (B)
unnamed: C37.1, SB3.1 (A), SB4.1 (A)
unnamed: R40.1, SB4.2 (B), U15.1, U15.4 (-)
unnamed: R85.2, SB5.2 (B)
unnamed: SB6.1 (A), U9.24 (PC4)
unnamed: SB7.1 (A), U9.26 (PB0)
unnamed: C41.1, SB8.1 (A), SB9.1 (A)
unnamed: SB9.2 (B), SB10.1 (A), U19.1, U19.4 (-)
unnamed: R105.1, SB11.2 (B)
unnamed: R73.1, TV14.1 (K), U26.1
unnamed: R74.1, TV15.1 (K), U27.1
unnamed: R2.2, U1.4 (Y)
unnamed: C13.2, NT1.2, U3.1 (+V_{IN})
unnamed: C11.2, C14.2, FB1.1, U4.3 (VI)
unnamed: C12.2, C15.2, FB3.2, U5.3 (VI)
unnamed: R19.1, U6.2 (1A)
unnamed: R20.1, U6.3 (2A)
unnamed: R15.1, U6.5 (DIR)
unnamed: C22.2, R13.1, R14.2, U7.3 (+)
unnamed: R17.1, U8.2 (1A)
unnamed: R18.1, U8.3 (2A)
unnamed: R16.1, U8.5 (DIR)
unnamed: C89.1, U9.30 (VCAP_1)
unnamed: R27.1, U11.2 (H_{IN})
unnamed: R31.2, R32.2, U11.7 (H_{O})
unnamed: R28.1, U11.3 (L_{IN})
unnamed: R33.2, R34.2, U11.5 (L_{O})
unnamed: C33.2, R30.1, U11.8 (V_{B})
unnamed: R29.1, U11.6 (V_{S})
unnamed: C34.2, U12.6 (FILTER)
unnamed: C35.1, C36.1, FB5.2, U12.8 (VCC)
unnamed: C38.2, R38.2, U15.3 (+)
unnamed: C39.1, C40.1, FB13.1, U15.5 (V+)
unnamed: NT6.2, U18.8 (IN+)
unnamed: NT5.2, U18.1 (IN-)
unnamed: C42.1, C43.1, FB6.2, U18.6 (VS), U18.7 (REF1)
unnamed: C44.2, R43.2, U19.3 (+)
unnamed: C46.1, C47.1, FB14.1, U19.5 (V+)
unnamed: R51.1, U20.2 (H_{IN})
unnamed: R44.2, R45.2, U20.7 (H_{O})
unnamed: R52.1, U20.3 (L_{IN})
unnamed: R46.2, R47.2, U20.5 (L_{O})
unnamed: C45.2, R48.1, U20.8 (V_{B})
unnamed: R49.1, U20.6 (V_{S})
unnamed: R63.2, U21.2 (1A)
unnamed: R64.2, U21.3 (2A)
unnamed: R22.2, U21.5 (DIR)
unnamed: R65.2, U22.2 (1A)
unnamed: R66.2, U22.3 (2A)
unnamed: R118.2, U22.5 (DIR)
unnamed: R67.2, U23.2 (1A)
unnamed: R68.2, U23.3 (2A)
unnamed: R120.2, U23.5 (DIR)
unnamed: R69.2, U24.2 (1A)
unnamed: R70.2, U24.3 (2A)
unnamed: R119.2, U24.5 (DIR)
unnamed: R71.1, U25.1 (1A)
unnamed: R75.2, U25.6 (1Y)
unnamed: R72.1, U25.3 (2A)
unnamed: R80.2, U25.4 (2Y)
unnamed: R83.1, U28.1 (1A)
unnamed: R88.1, U28.6 (1Y)
unnamed: R84.1, U28.3 (2A)
unnamed: R89.1, U28.4 (2Y)
unnamed: R93.1, U29.2 (A)
unnamed: R87.1, U29.7 (EN)
unnamed: R88.2, U30.2 (A)
unnamed: R94.1, U30.7 (EN)
unnamed: R89.2, U31.2 (A)
unnamed: R95.1, U31.7 (EN)
unnamed: R93.2, U32.4 (Y)
unnamed: R98.1, U34.1 (R)
unnamed: R107.1, U36.1 (En)
PGND: C1.2, C2.1, C4.1, C5.2, C6.1, C7.2, C8.1, C9.1, C10.2, C13.1, C16.1, C19.1, C31.2, C32.2, C48.1, C49.1, FB2.2, FB4.2, J1.2, Q2.2 (S), R4.1, R5.1, R8.2, R9.2, R10.2, R37.1, R42.1, TV1.2 (A), U2.2 (GND), U3.2 (GND), U11.4 (Com), U14.1 (S), U14.2 (S), U14.3 (S), U17.1 (S), U17.2 (S), U17.3 (S), U20.4 (Com)
V_{DC}+: C91.2, C92.2, D1.2 (A), Q1.1 (S), Q1.2 (S), Q1.3 (S), Q3.1 (S), Q3.2 (S), Q3.3 (S), R3.2, R6.2
V_{MOTOR}: C1.1, C5.1, C7.1, LD2.2 (A), NT2.1, Q3.5 (D), R13.2, U13.5 (D), U16.5 (D)
V_{PWR}+: F1.1, J1.1
V_{PWR}_Fuse+: F1.2, Q1.5 (D), TV1.1 (K)
