parkourlrc/pcb-tgiacomellibr--sjc-6abed6a295/firmware/sjc/tasks/src/main_task.c

/*
 * network_task.c
 *
 *  Created on: Sep 9, 2023
 *      Author: tiago
 */


// HAL includes ------------------------------------------------------ //
// ------------------------------------------------------------------- //
#include "main.h"
#include "cmsis_os.h"
// ------------------------------------------------------------------- //

// Task includes --------------------------------------------------- //
// ------------------------------------------------------------------- //
#include "types.h"

#include "motor.h"
// ------------------------------------------------------------------- //


// Task defines ---------------------------------------------------- //
// ------------------------------------------------------------------- //


// ------------------------------------------------------------------- //

// Task data structures -------------------------------------------- //
// ------------------------------------------------------------------- //

// ------------------------------------------------------------------- //

// Task variables -------------------------------------------------- //
// ------------------------------------------------------------------- //

// ------------------------------------------------------------------- //

// Private function prototypes ---------------------------------------- //
// ------------------------------------------------------------------- //


// ------------------------------------------------------------------- //

// Public functions -------------------------------------------------- //
// ------------------------------------------------------------------- //
void MainTaskApp(void *argument)
{
	/* init code for USB_DEVICE */
	//  MX_USB_DEVICE_Init();
	/* USER CODE BEGIN mainTaskApp */

	SJC_Motor_Init(24, PWM_FREQ_20kHz);
	SJC_Motor_Enable();

	float volt = 0;
	float sum = 0.01;
	uint32_t count = 0;
	uint32_t cycle = 0;

	//	SJC_Motor_SetOutputVoltage(volt);
	osDelay(pdMS_TO_TICKS(1000));

	uint32_t tick;
	tick = osKernelGetTickCount();

	/* Infinite loop */
	for(;;)
	{
		tick += pdMS_TO_TICKS(1);

		if (volt >= 24.0f)
		{
			sum = -1.0f*fabs(sum);
		}
		else if (volt < -24.0f)
		{
			sum = fabs(sum);
		}
		volt += sum;
		SJC_Motor_SetOutputVoltage(volt);
		count++;
		cycle++;

		if (count > 100)
		{
			float vin = SJC_Motor_GetPowerSupplyVoltage();
			float Iin = SJC_Motor_GetElectricCurrent();
			float vout = SJC_Motor_GetOutputVoltage();

			printf("\r\n[%lu] Vin: %.2f - Mot: %.2f - I: %.2f", cycle, vin, vout, Iin);
			count = 0;
		}

		osDelayUntil(tick);
	}
	/* USER CODE END MainTaskApp */
}
// ------------------------------------------------------------------- //

// Private functions ------------------------------------------------- //
// ------------------------------------------------------------------- //

// ------------------------------------------------------------------- //
