parkourlrc/pcb-tgiacomellibr--sjc-6abed6a295/firmware/sjc_fw.ioc

Mcu.UserName=STM32F446RETx
PA0-WKUP.Signal=S_TIM2_CH1_ETR
PA1.Signal=S_TIM2_CH2
PA10.GPIO_Label=R_MOT_HI
PA10.Signal=S_TIM1_CH3
PA11.Signal=USB_OTG_FS_DM
PA12.Signal=USB_OTG_FS_DP
PA13.Signal=SYS_JTMS-SWDIO
PA14.Signal=SYS_JTCK-SWCLK
PA2.GPIO_Label=RS485_TX
PA2.Signal=USART2_TX
PA3.GPIO_Label=RS485_RX
PA3.Signal=USART2_RX
PA4.GPIO_Label=RS485_DE
PA4.Signal=GPIO_Output
PA6.GPIO_Label=AUX1_ENC_CH1
PA6.Signal=S_TIM3_CH1
PA7.GPIO_Label=AUX1_ENC_CH2
PA7.Signal=S_TIM3_CH2
PA8.GPIO_Label=L_MOT_HI
PA8.Signal=S_TIM1_CH1
PB0.GPIO_Label=CURRENT_SIGNAL_FILT
PB0.Signal=ADCx_IN8
PB1.GPIO_Label=R_MOT_LO
PB1.Signal=TIM1_CH3N
PB13.GPIO_Label=L_MOT_LO
PB13.Signal=TIM1_CH1N
PB5.GPIO_Label=V_MOTOR_nEN
PB5.Signal=GPIO_Output
PC0.GPIO_Label=GP_ISO_IN_A
PC0.Signal=GPIO_Input
PC1.GPIO_Label=GP_ISO_IN_B
PC1.Signal=GPIO_Input
PC10.GPIO_Label=DEBUG_USART_TX
PC10.Signal=USART3_TX
PC11.GPIO_Label=DEBUG_USART_RX
PC11.Signal=USART3_RX
PC12.GPIO_Label=SYS_HEARTBEAT
PC12.Signal=GPIO_Output
PC14-OSC32_IN.GPIO_Label=GP_OUT_B
PC14-OSC32_IN.Signal=GPIO_Output
PC15-OSC32_OUT.GPIO_Label=GP_OUT_A
PC15-OSC32_OUT.Signal=GPIO_Output
PC2.GPIO_Label=JOINT_SW_L
PC2.Signal=GPIO_Input
PC3.GPIO_Label=JOINT_SW_R
PC3.Signal=GPIO_Input
PC4.GPIO_Label=CURRENT_SIGNAL_FILT2
PC4.Signal=ADCx_IN14
PC5.GPIO_Label=MOTOR_INPUT_VOLTAGE_SIG
PC5.Signal=ADCx_IN15
PC6.GPIO_Label=AUX2_ENC_CH1
PC6.Signal=S_TIM8_CH1
PC7.GPIO_Label=AUX2_ENC_CH2
PC7.Signal=S_TIM8_CH2
PH0-OSC_IN.Signal=RCC_OSC_IN
PH1-OSC_OUT.Signal=RCC_OSC_OUT
