parkourlrc/pcb-tgiacomellibr--sjc-6abed6a295/firmware/Core/Inc/main.h

#define GP_OUT_B_Pin LL_GPIO_PIN_14
#define GP_OUT_B_GPIO_Port GPIOC
#define GP_OUT_A_Pin LL_GPIO_PIN_15
#define GP_OUT_A_GPIO_Port GPIOC
#define GP_ISO_IN_A_Pin LL_GPIO_PIN_0
#define GP_ISO_IN_A_GPIO_Port GPIOC
#define GP_ISO_IN_B_Pin LL_GPIO_PIN_1
#define GP_ISO_IN_B_GPIO_Port GPIOC
#define JOINT_SW_L_Pin LL_GPIO_PIN_2
#define JOINT_SW_L_GPIO_Port GPIOC
#define JOINT_SW_R_Pin LL_GPIO_PIN_3
#define JOINT_SW_R_GPIO_Port GPIOC
#define RS485_TX_Pin LL_GPIO_PIN_2
#define RS485_TX_GPIO_Port GPIOA
#define RS485_RX_Pin LL_GPIO_PIN_3
#define RS485_RX_GPIO_Port GPIOA
#define RS485_DE_Pin LL_GPIO_PIN_4
#define RS485_DE_GPIO_Port GPIOA
#define AUX1_ENC_CH1_Pin LL_GPIO_PIN_6
#define AUX1_ENC_CH1_GPIO_Port GPIOA
#define AUX1_ENC_CH2_Pin LL_GPIO_PIN_7
#define AUX1_ENC_CH2_GPIO_Port GPIOA
#define CURRENT_SIGNAL_FILT2_Pin LL_GPIO_PIN_4
#define CURRENT_SIGNAL_FILT2_GPIO_Port GPIOC
#define MOTOR_INPUT_VOLTAGE_SIG_Pin LL_GPIO_PIN_5
#define MOTOR_INPUT_VOLTAGE_SIG_GPIO_Port GPIOC
#define CURRENT_SIGNAL_FILT_Pin LL_GPIO_PIN_0
#define CURRENT_SIGNAL_FILT_GPIO_Port GPIOB
#define R_MOT_LO_Pin LL_GPIO_PIN_1
#define R_MOT_LO_GPIO_Port GPIOB
#define L_MOT_LO_Pin LL_GPIO_PIN_13
#define L_MOT_LO_GPIO_Port GPIOB
#define AUX2_ENC_CH1_Pin LL_GPIO_PIN_6
#define AUX2_ENC_CH1_GPIO_Port GPIOC
#define AUX2_ENC_CH2_Pin LL_GPIO_PIN_7
#define AUX2_ENC_CH2_GPIO_Port GPIOC
#define L_MOT_HI_Pin LL_GPIO_PIN_8
#define L_MOT_HI_GPIO_Port GPIOA
#define R_MOT_HI_Pin LL_GPIO_PIN_10
#define R_MOT_HI_GPIO_Port GPIOA
#define DEBUG_USART_TX_Pin LL_GPIO_PIN_10
#define DEBUG_USART_TX_GPIO_Port GPIOC
#define DEBUG_USART_RX_Pin LL_GPIO_PIN_11
#define DEBUG_USART_RX_GPIO_Port GPIOC
#define SYS_HEARTBEAT_Pin LL_GPIO_PIN_12
#define SYS_HEARTBEAT_GPIO_Port GPIOC
#define V_MOTOR_nEN_Pin LL_GPIO_PIN_5
#define V_MOTOR_nEN_GPIO_Port GPIOB
