parkourlrc/pcb-tgiacomellibr--sjc-6abed6a295/firmware/sjc/tasks/include/task_system_controller.h

/*
 * network_task.h
 *
 *  Created on: Oct 4, 2023
 *      Author: Tiago
 */

#ifndef SJC__TASKS__SYSTEM_CONTROLLER_TASK_H_
#define SJC__TASKS__SYSTEM_CONTROLLER_TASK_H_

#include "types.h"

eSjcReturnType_t SJC_TaskSystemController_Init(void);
eSjcReturnType_t SJC_TaskSystemController_SetSharedDataMutex(osMutexId_t MutexHandle);

#endif /* SJC__TASKS__SYSTEM_CONTROLLER_TASK_H_ */
