parkourlrc/pcb-tgiacomellibr--sjc-6abed6a295/firmware/sjc/system_types/include/types.h

/*
 * types.h
 *
 *  Created on: Sep 17, 2023
 *      Author: tiago
 */

#ifndef SJC__SYSTEM_TYPES__TYPES_H_
#define SJC__SYSTEM_TYPES__TYPES_H_

#include <math.h>
#include <stdarg.h>
#include <stdbool.h>
#include <stdint.h>
#include <stdio.h>
#include <string.h>

#include "data_structures.h"
#include "filters.h"
#include "helpers.h"
#include "rtos_types.h"

#endif /* SJC__SYSTEM_TYPES__TYPES_H_ */
