parkourlrc/pcb-tgiacomellibr--sjc-6abed6a295/firmware/sjc/system_types/include/rtos_types.h

/*
 * data_structures.h
 *
 *  Created on: Sep 17, 2023
 *      Author: tiago
 */

#ifndef SJC__SYSTEM_TYPES__RTOS_TYPES_H_
#define SJC__SYSTEM_TYPES__RTOS_TYPES_H_

// System includes --------------------------------------------------- //
// ------------------------------------------------------------------- //
#include "cmsis_os.h"
#include "semphr.h"
// ------------------------------------------------------------------- //

// Definitions includes ---------------------------------------------- //
// ------------------------------------------------------------------- //
#define BINARY_SEMPHR_COUNT_SIZE							((uint32_t) 1U)
#define BINARY_SEMPHR_INITIAL_COUNT							((uint32_t) 1U)
// ------------------------------------------------------------------- //


#endif /* SJC__SYSTEM_TYPES__RTOS_TYPES_H_ */
