parkourlrc/pcb-tgiacomellibr--sjc-6abed6a295/(commit log)

2023-06-06 STM32Cube project and pin assignment
2023-09-18 Stm32 peripheral updated
2023-09-18 SJC library created, PWM and Motor Voltage modules writed
2023-10-24 STM32CubeIDE project updates
2023-12-09 PCB updates
2023-12-28 Add encoder measurements
2023-12-28 Add encoder reading and bugfixes to IOs
2024-01-05 Add adc sensor measurements and USB debug printf
2024-01-05 Add driver updates
2024-01-06 Add bugfix to analog sensors measurement timestep
2024-01-10 Add pid controller module and speed control tests
2024-01-18 Add Timer calcs
2024-02-06 Current sensor calcs updated
2024-02-10 Placement updates and power planes removed
2024-03-13 Mobus timer calcs updated
2024-03-13 Modbus timer configs updated
2024-03-13 Board configs updated
2024-03-13 Adc measurement checkpoint updated
2024-03-13 Modbus serial port interrupts simplified
2024-03-13 Modbus timer code cleanup
2024-03-23 Add data_logger module
    - Log transmission
    - TX DMA
2024-03-23 Simplify TX interrupts
2024-03-23 Add current bias method
2024-03-28 Update NetTies of current sense circuit
2024-03-28 Add V_USB LED
2024-03-30 PCB design updated
2024-03-30 Update sampletime check measurement
2024-03-30 Modify DMA data buffer banks
2024-03-30 Add current control to taskcontroller
2024-04-02 Add solder jumpers to current sense circuits outputs
2024-04-02 Add traces to current sense circuits and oscilator
2024-04-20 Firmware changes
    - Add Task high wattermark measurement
    - Add task loop time measurement
    - Change file permissions
    - Add controller initial state to detect current bias
    - Add different heartbeat codes to bias detection and runtime
2024-04-26 Modify current comp. filter parameters
2024-04-26 Revert pid controller structure
2024-04-26 Add mean filter between adc data
2024-05-24 Add Hardware V2 pcb layout
2024-08-12 WIP: Create V3 Firmware project and update motor and psu schematic
2024-08-18 WIP: Current sense amplifiers changed
2024-08-18 WIP: Add Power supply protections
2024-08-18 WIP: Add new symbols and footprints
2024-08-18 WIP: Make schematic reorganization
2024-08-19 wip: recover old pcb dimensions
2024-10-31 Wip: Add LEDs
2024-12-27 WIP: Changing servo driver circuit
2025-01-06 Add communication circuits
2025-01-07 Remove old schematic sheets
2025-01-07 Clear old PCB layout
2025-01-07 Add can bus transceiver
2025-01-10 Wip: Add LEDs for communication status and change network side transceiver's psu to 5V
2025-01-10 Update schematic and pcb
2025-01-15 Wip: Design of 12V buck converter
2025-01-20 Add schematic and pcb design files
2025-01-23 Add LDO regulators (+5V and +3V3)
2025-01-25 WIP: Power components placement
2025-02-05 Add bypass capacitors
2025-02-06 WIP: Buck psu updates
2025-02-25 Wip: Save as KiCad 9
2025-03-06 Wip: Schematic changes - servomotor interface
2025-03-07 Wip: Selecting h-bridge mosfets and bootstrap network components. Incomplete!
2025-03-10 WIP: Remove secondary current sensor
2025-03-11 Update external current sense circuit
2025-03-11 Remove shunt resistor and update external current sense circuit connector
2025-03-11 Wip: Split pcbs
2025-03-17 Split project: Logic and Power
2025-03-18 Add calcs and Change RG_on and RG_off resistors
2025-03-18 WIP: Power signals update
2025-03-26 Add IAUC100N04S6N028 mosfet symbol and footprint
2025-03-28 Update Measurement task and create filter module
2025-03-28 Encoder module updates
2025-03-29 Add new filter structures and update the software library to allow dynamic filter adjustment
2025-03-31 Update bootstrap circuit calcs
2025-03-31 Wip: PCB Updates
2025-04-01 Add buck converter calcs script
2025-04-05 Update software library and deprecated firmware filter config
2025-04-10 Schematic updates
2025-04-17 Add Spi interface
2025-12-20 Change PPR to CPR encoder resolution specs (quadrature value)
2026-04-23 feat: DMA-based current measurement and module API cleanup
2026-04-23 refactor(firmware): modularize velocity measurement, harden sjc base and module APIs
    - velocity_measurement: new module (.c/.h) owning per-joint exponential
    filtering of encoder-derived angular velocity; replaces inline filter
    state previously held in sjc.c.
    - sjc base: protect xSjcControlConfigs access with a dedicated mutex;
    move current-bias state into MotorDrive (via new setCurrentBias API);
    strip dead accessor prototypes from sjc.h; integrate
    VelocityMeasurement_init in SJC_init; drop Net_UpdateBoardInfo and
    Net_UpdateActuatorParameters (merged into remaining updaters).
    - error handling: add Error_HandlerFrom(module, function) that prints
    a fault breadcrumb on USART3 bef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
