parkourlrc/pcb-tgiacomellibr--sjc-6abed6a295/(notices)

Notices in the files:
firmware/Core/Inc/main.h:
Copyright (c) 2023 STMicroelectronics.
All rights reserved.
This software is licensed under terms that can be found in the LICENSE file
